sequoia-hope/bluebuzz/archive/nrf52840/ABANDONED.md

# Abandoned

The first bluebuzz board (nRF52840 module, 34 x 44 mm, 4 layers). Abandoned
2026-10-18 in favour of the RP2350A + RM2 board, which now lives at the top
of this project. Kept for reference only; its pipeline still runs from this
folder (`python3 build.py`), but nothing here is maintained.
