sequoia-hope/bluebuzz/design/gates/phase7/copper_b_cu.png

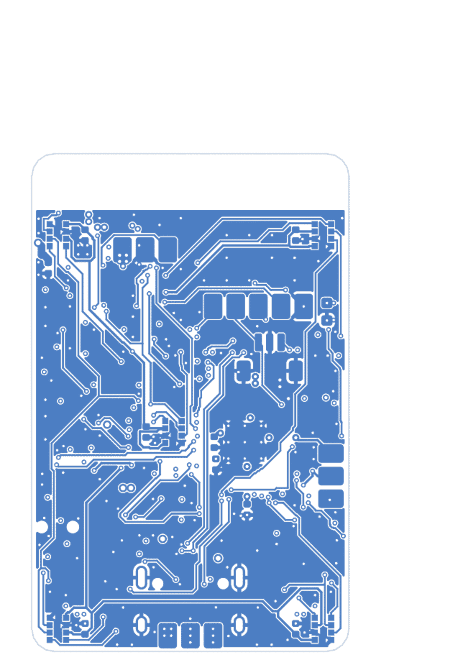
design/gates/phase7/copper_b_cu.png
