sequoia-hope/bluebuzz/design/gates/phase7/copper_f_cu.png

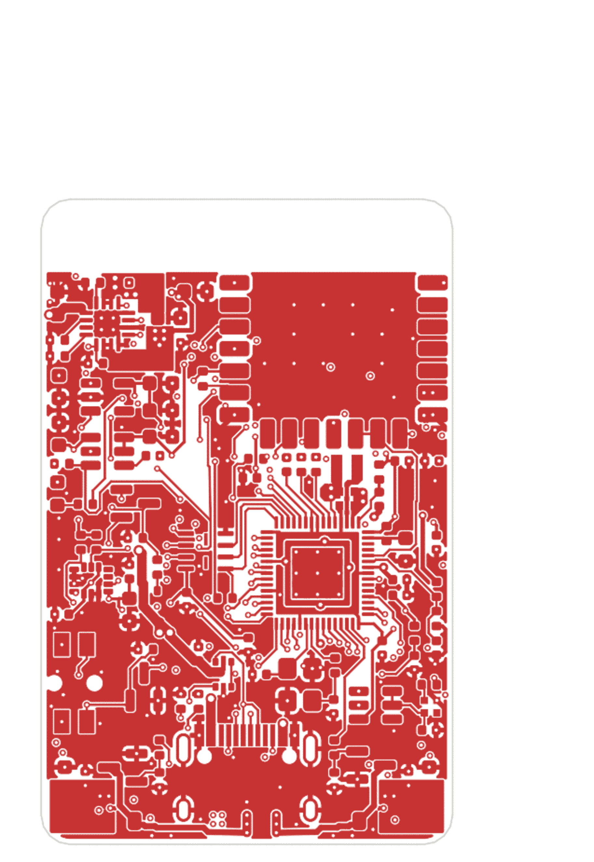
design/gates/phase7/copper_f_cu.png
