sequoia-hope/bluebuzz/design/gates/phase7/copper_in1_cu.png

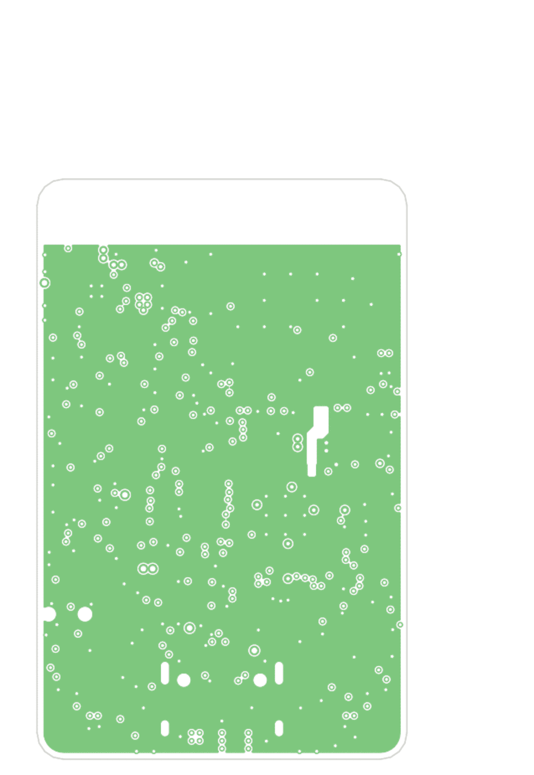
design/gates/phase7/copper_in1_cu.png
