sequoia-hope/bluebuzz/design/gates/phase7/copper_in2_cu.png

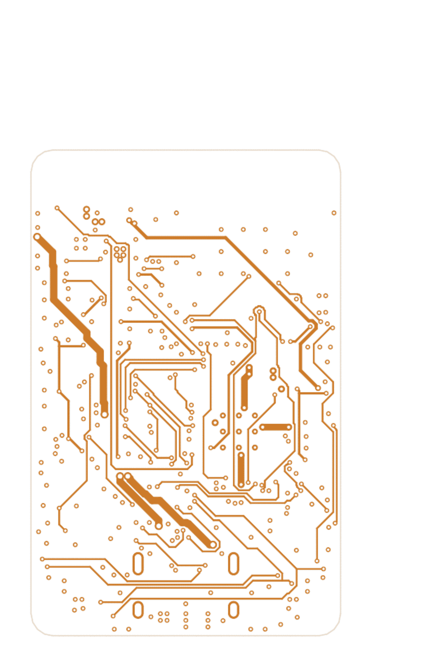
design/gates/phase7/copper_in2_cu.png
