sequoia-hope/bluebuzz/design/gates/phase7/copper_in3_cu.png

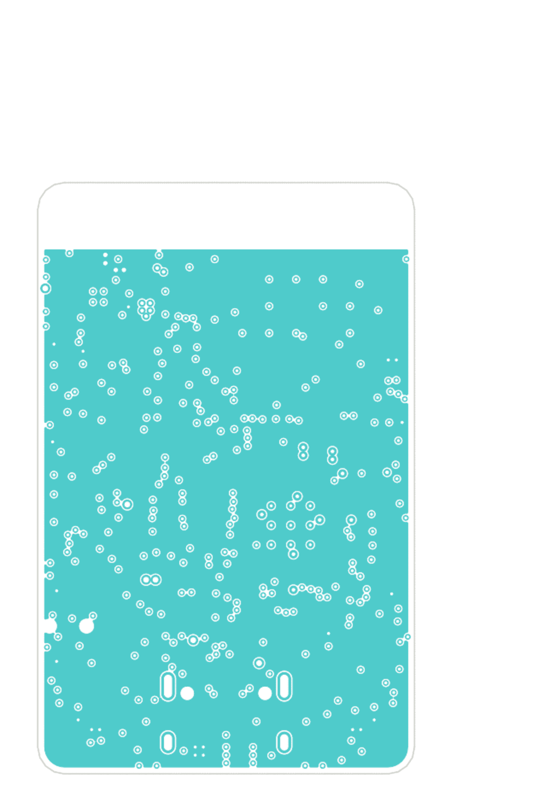
design/gates/phase7/copper_in3_cu.png
