sequoia-hope/bluebuzz/design/gates/phase7/copper_in4_cu.png

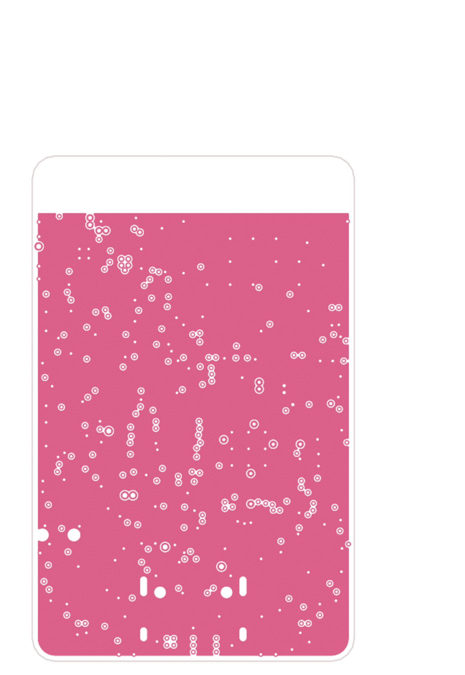
design/gates/phase7/copper_in4_cu.png
