sequoia-hope/bluebuzz/design/renders/sch-1.png

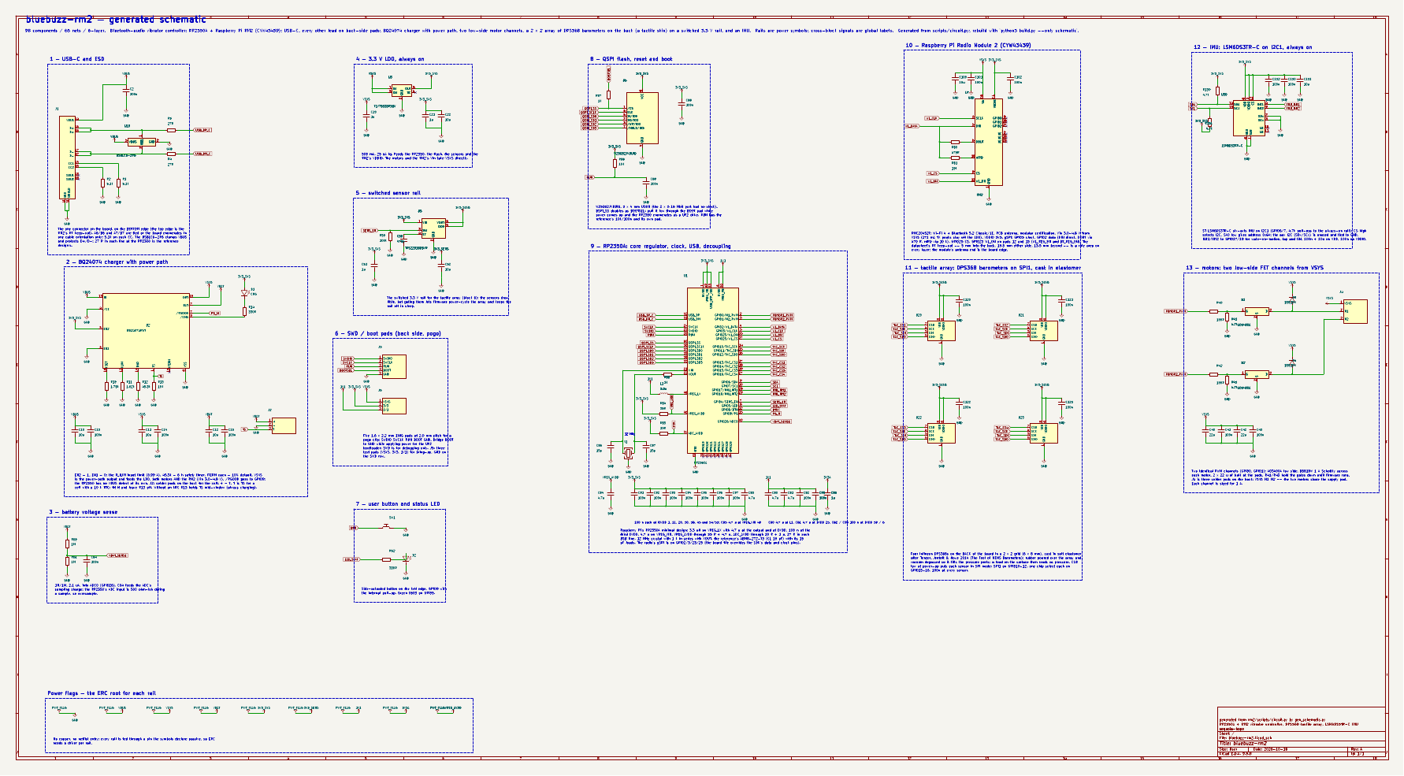
design/renders/sch-1.png
