sequoia-hope/bluebuzz/design/renders/sch-tile1.png

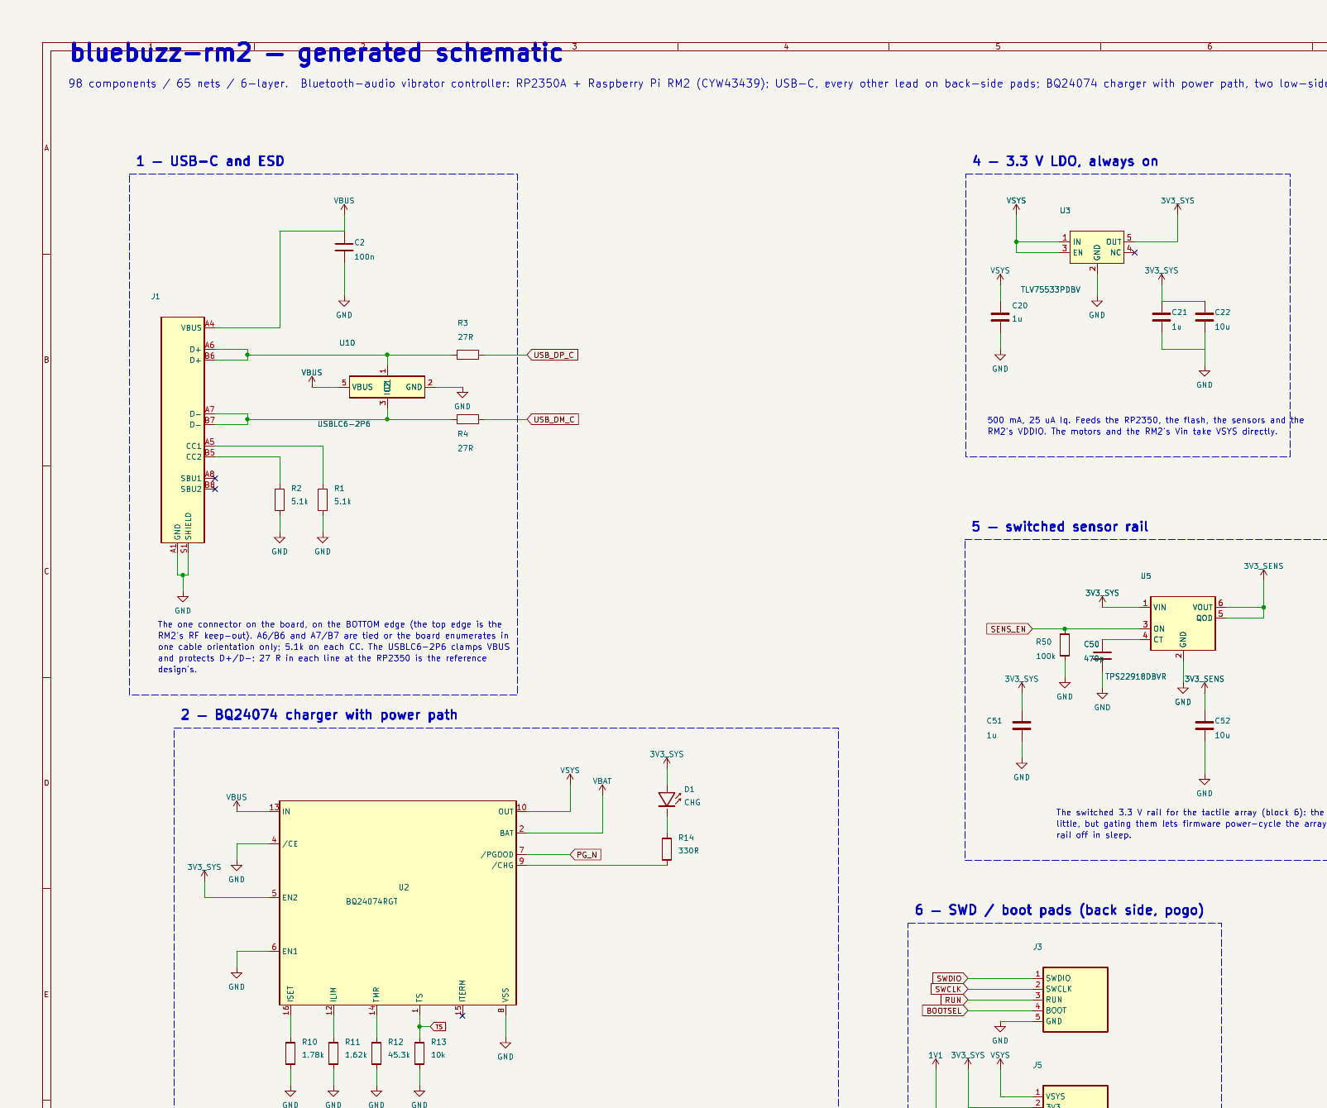
design/renders/sch-tile1.png
