sequoia-hope/bluebuzz/design/renders/sch-tile2.png

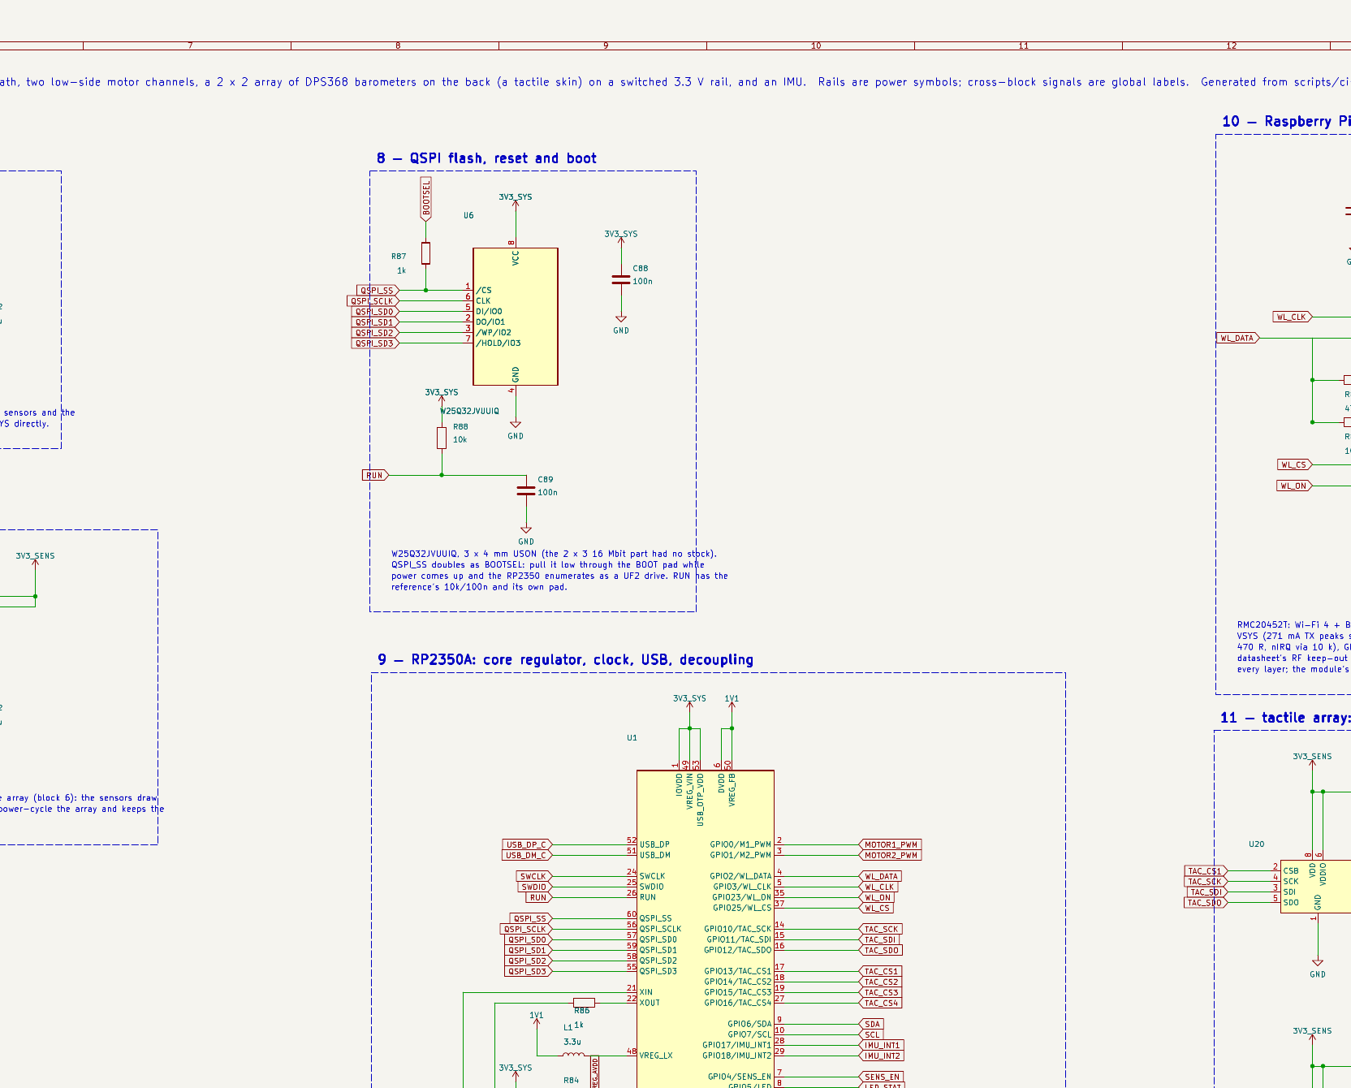
design/renders/sch-tile2.png
