sequoia-hope/bluebuzz/design/renders/sch-tile3.png

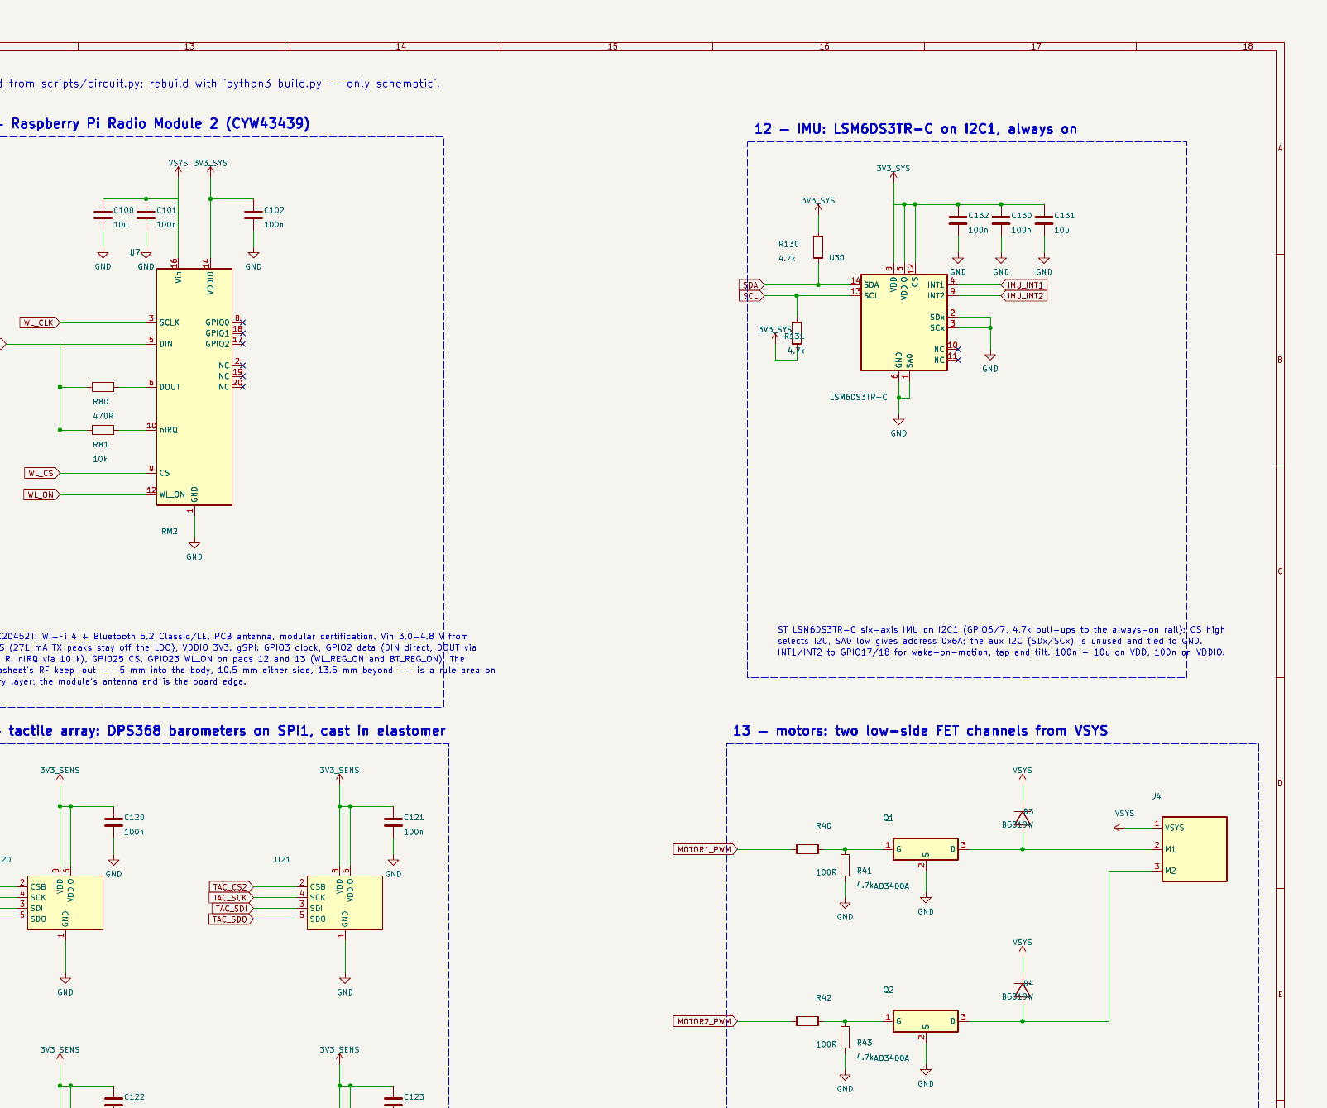
design/renders/sch-tile3.png
