sequoia-hope/bluebuzz/design/renders/sch-tile4.png

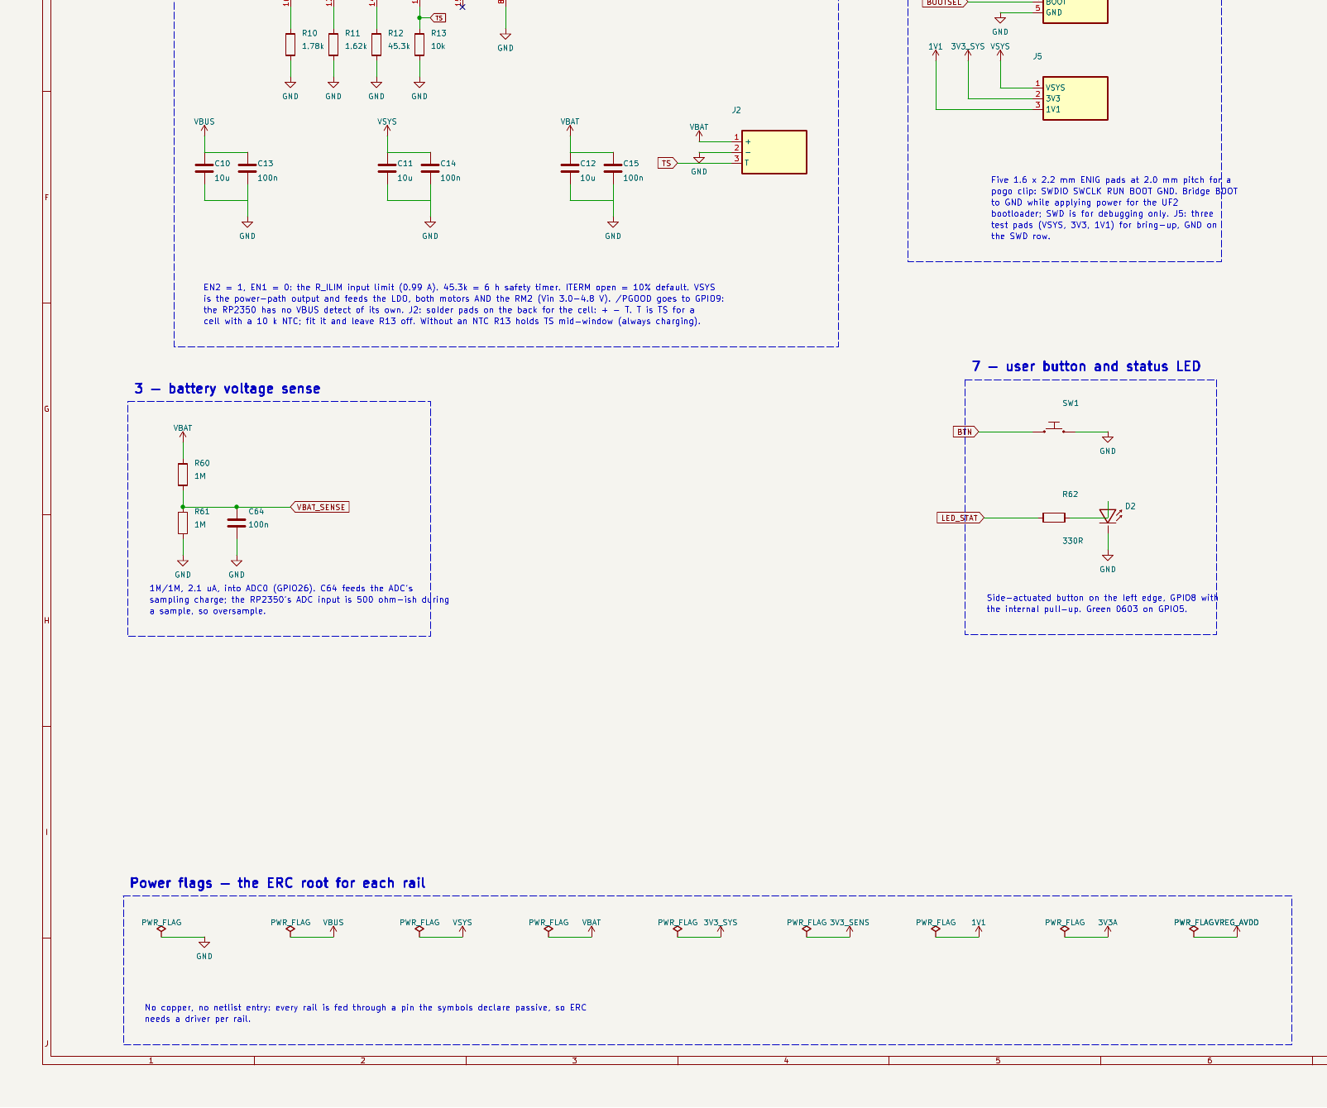
design/renders/sch-tile4.png
