sequoia-hope/bluebuzz/design/renders/sch-tile5.png

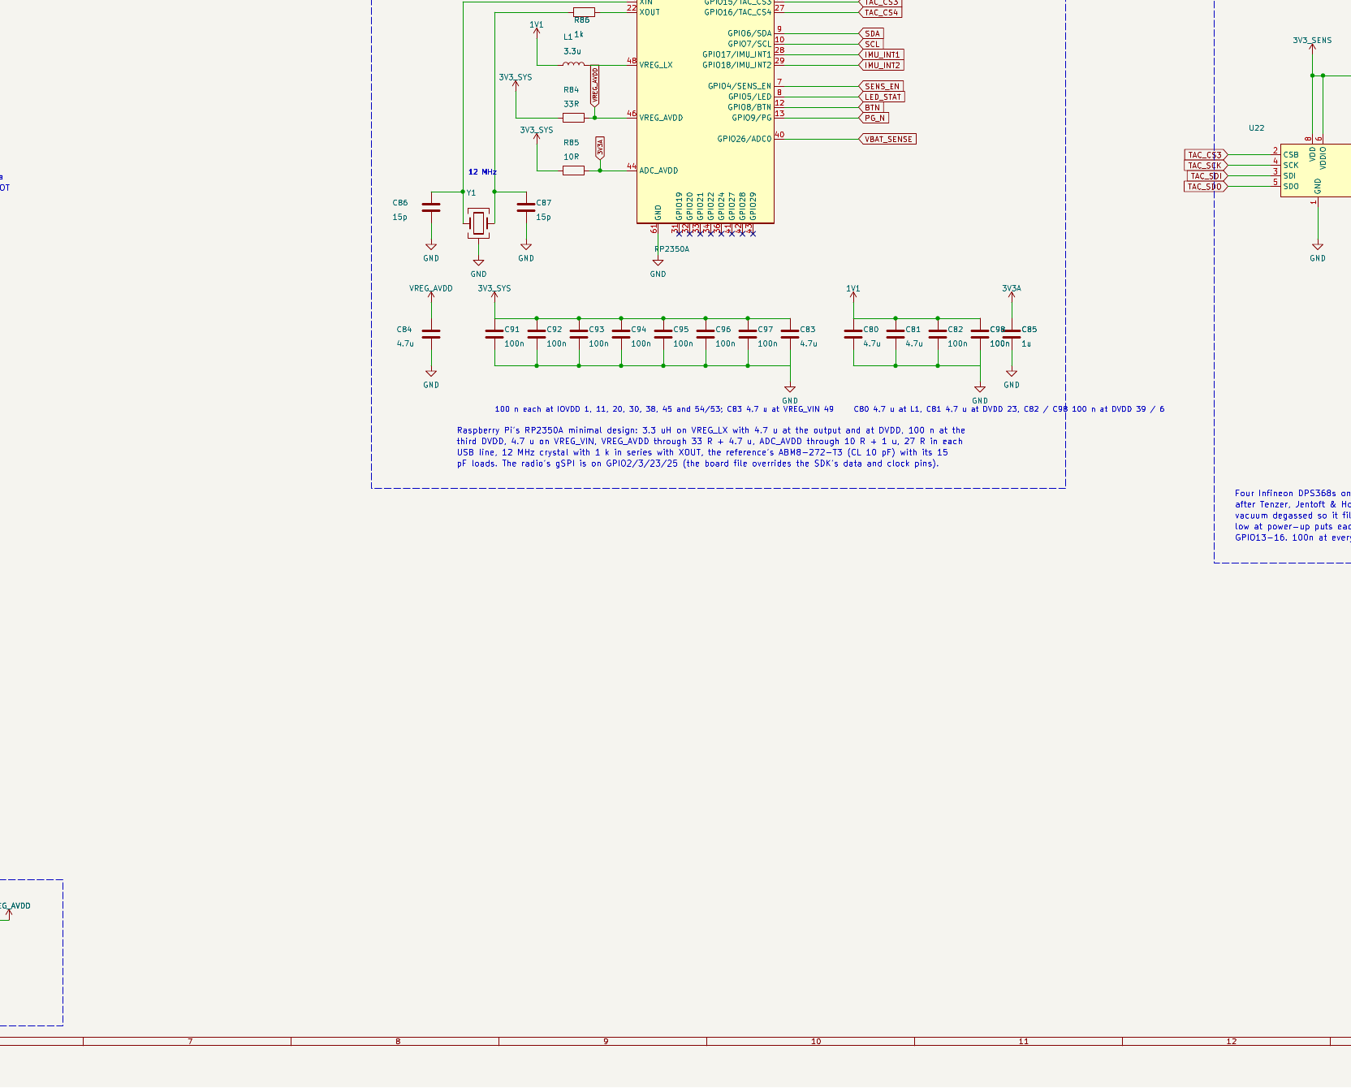
design/renders/sch-tile5.png
