sequoia-hope/bluebuzz/design/renders/sch-tile6.png

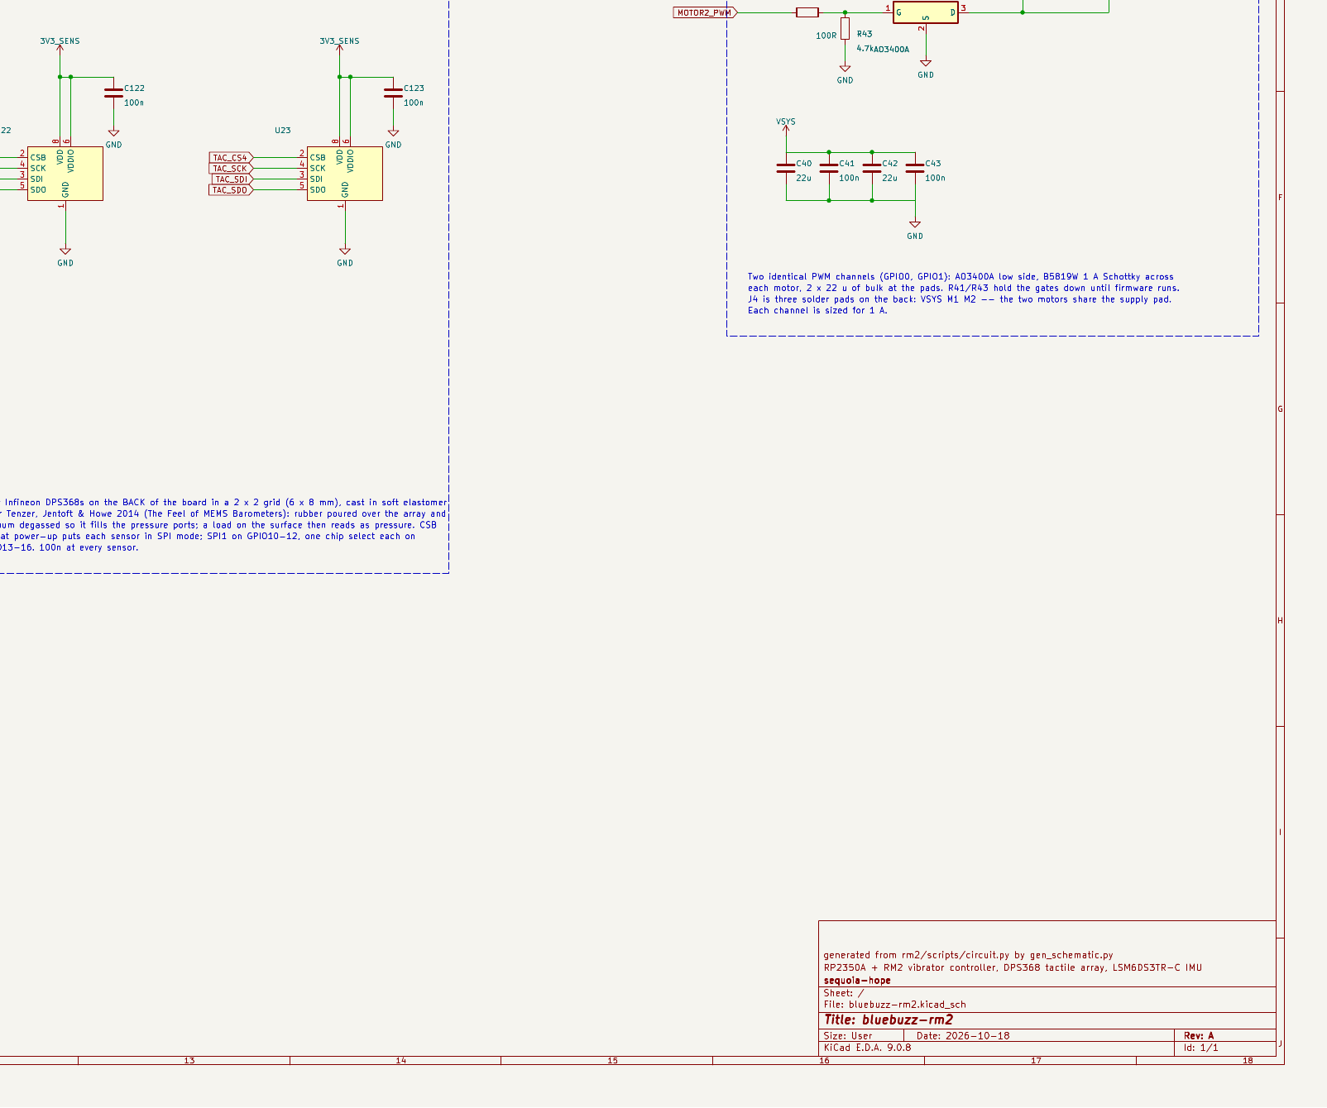
design/renders/sch-tile6.png
