sequoia-hope/bluebuzz/docs/components/img/ds-abm8-specs.png

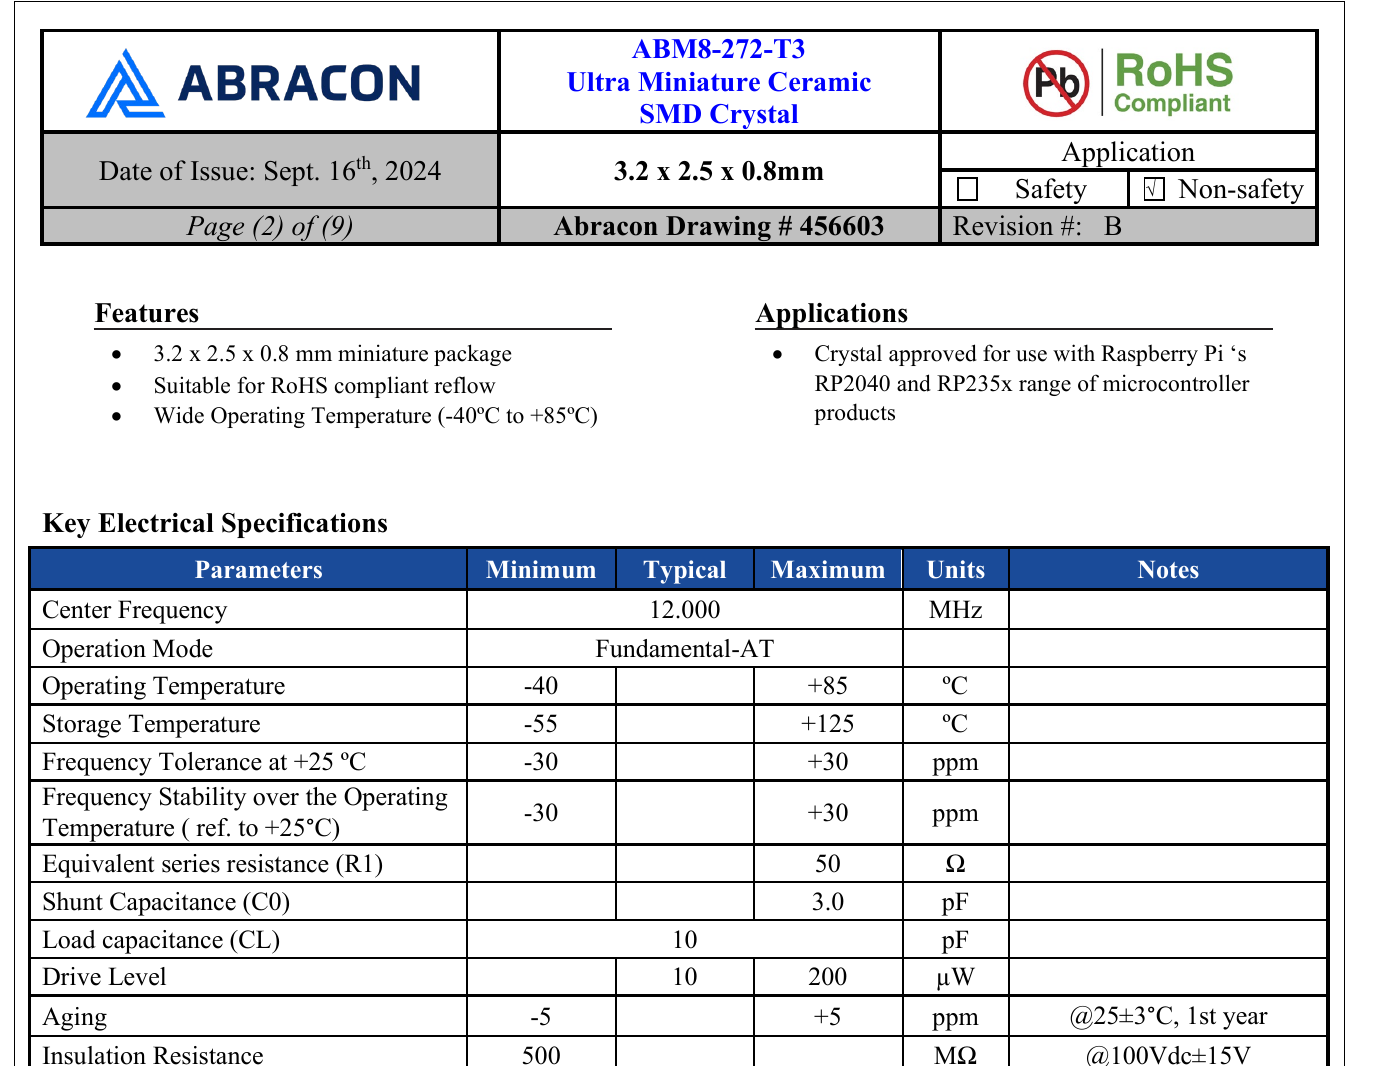
docs/components/img/ds-abm8-specs.png
