sequoia-hope/bluebuzz/docs/components/img/ds-bq-design.png

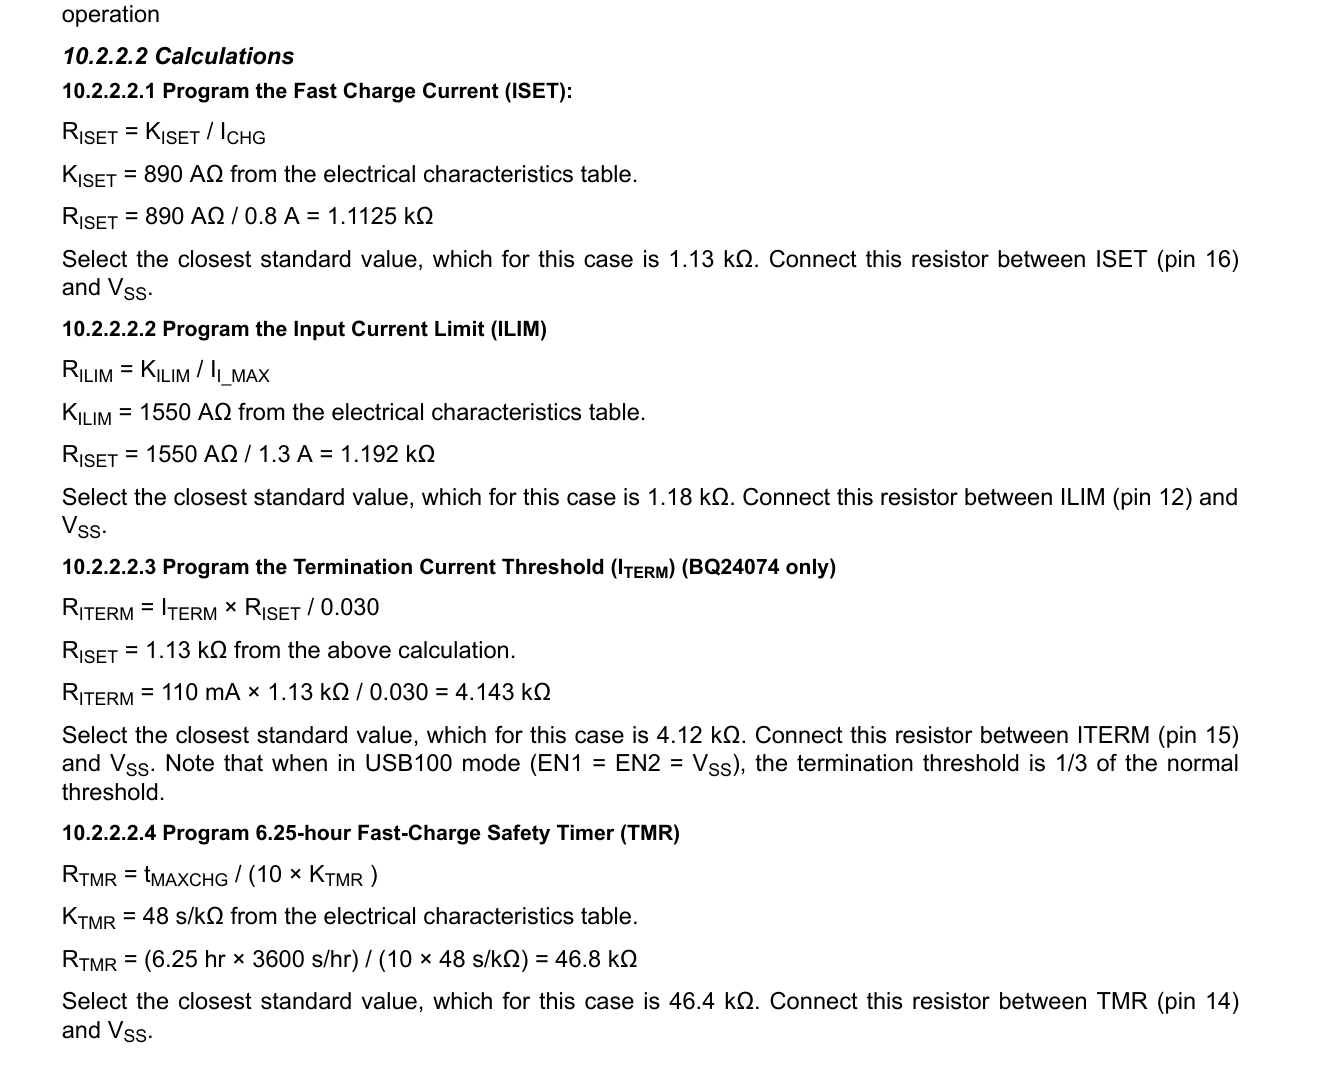
docs/components/img/ds-bq-design.png
