sequoia-hope/bluebuzz/out/layer_b.png

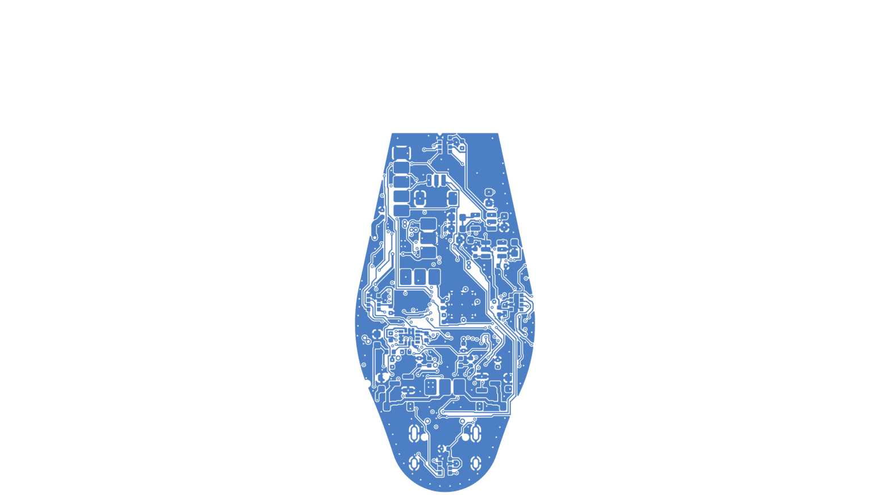
out/layer_b.png
