sequoia-hope/bluebuzz/out/layer_edge.png

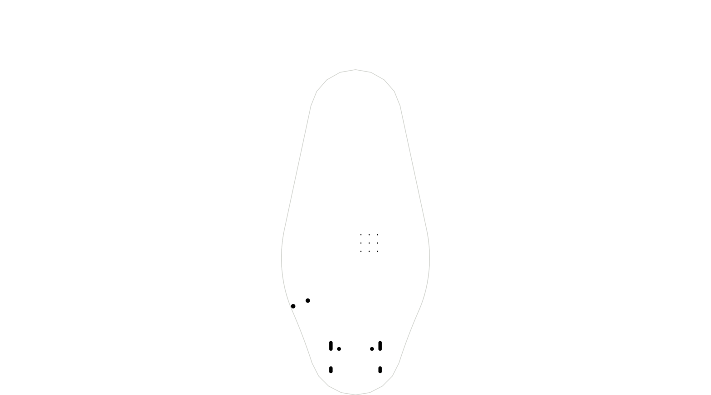
out/layer_edge.png
