sequoia-hope/bluebuzz/out/layout_layers.png

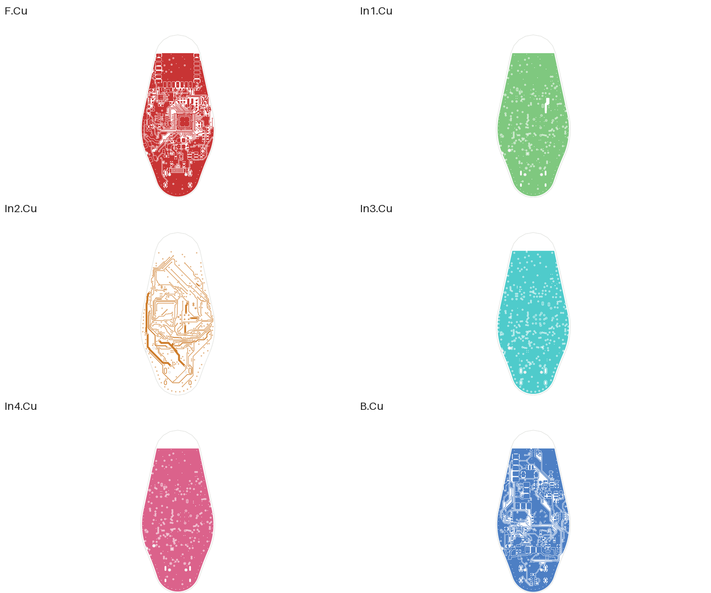
out/layout_layers.png
