sequoia-hope/bluebuzz/out/render_bottom.png

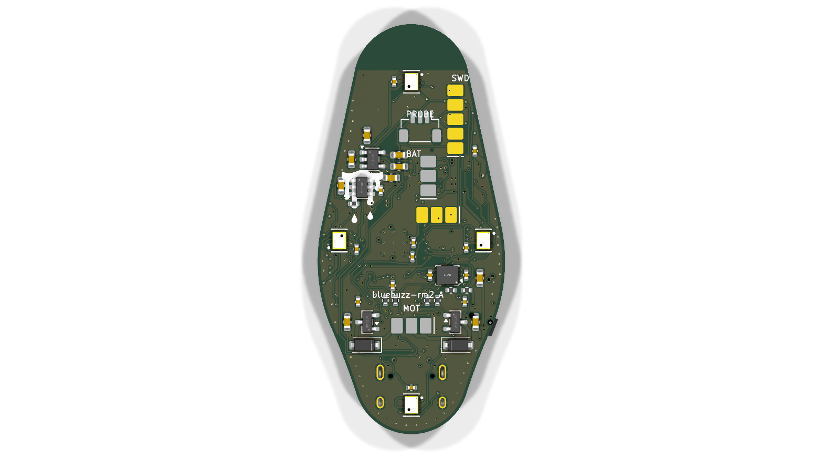
out/render_bottom.png
