sequoia-hope/bluebuzz/out/squish_outline_overlay.png

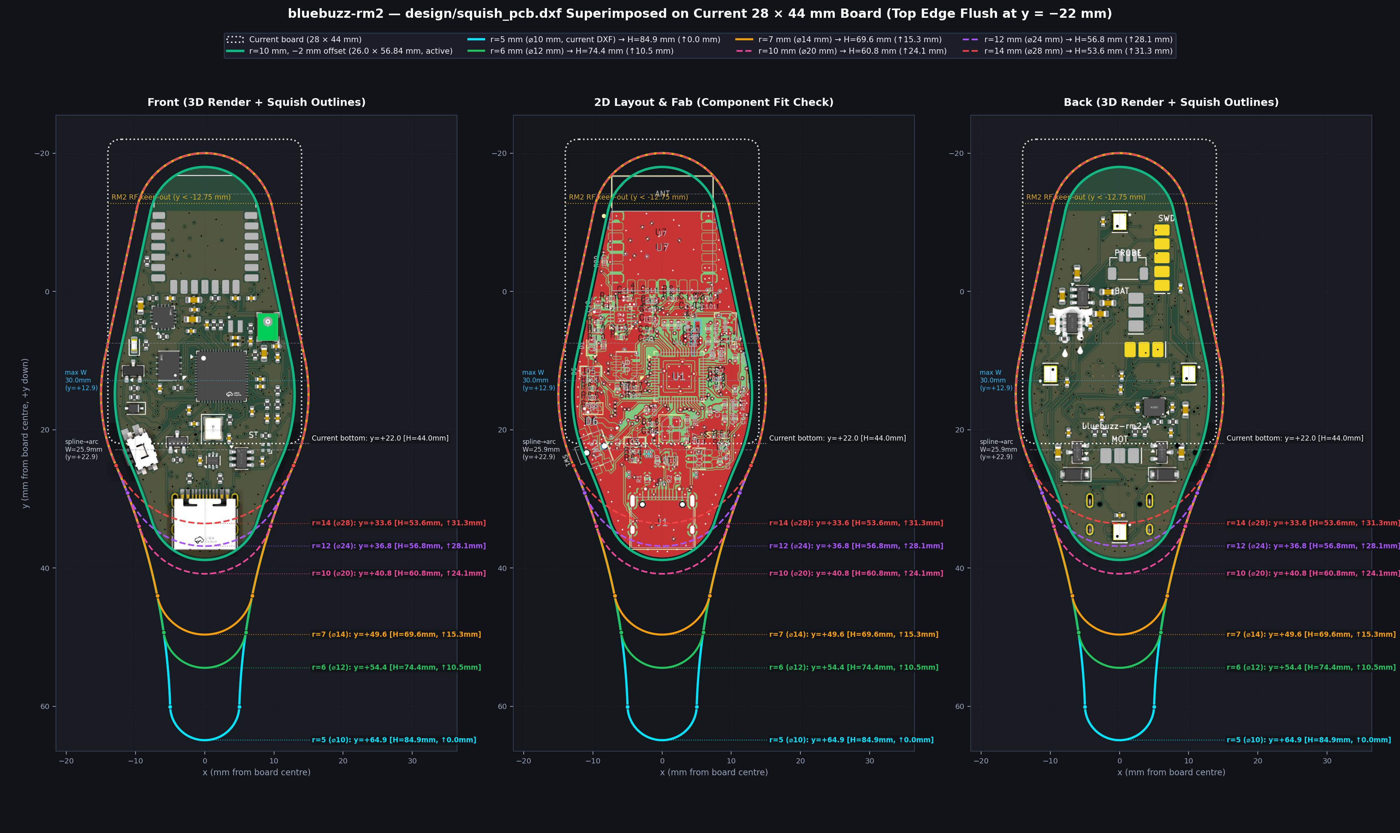
out/squish_outline_overlay.png
