sequoia-hope/bluebuzz/out/jlcpcb/bom.csv

Comment | Designator | Footprint | MPN | LCSC Part #
10u | C10,C100,C11,C12,C131,C22,C52 | C_0603_1608Metric | CL10A106KP8NNNC | C19702
100n | C101,C102,C120,C121,C122,C123,C13,C130,C132,C133,C14,C140,C15,C2,C41,C43,C64,C82,C88,C89,C91,C92,C93,C94,C95,C96,C97,C98 | C_0402_1005Metric | CL05B104KO5NNNC | C1525
22u | C40,C42 | C_0603_1608Metric | CL10A226MP8NUNE | C86295
470p | C50 | C_0402_1005Metric | 0402CG471J500NT | C75274
4.7u | C80,C83 | C_0402_1005Metric_small_pads | CL05A475MP5NRNC | C23733
4.7u | C81,C84 | C_0402_1005Metric | CL05A475MP5NRNC | C23733
1u | C20,C21,C51,C85 | C_0603_1608Metric | CL10A105KB8NNNC | C15849
15p | C86,C87 | C_0402_1005Metric | 0402CG150J500NT | C1548
CHG | D1 | LED_0603_1608Metric | 19-217/GHC-YR1S2/6T | C2986059
XL-1010RGBC | D2 | LED_1010_WS2812 | XL-1010RGBC-2812B-S | C51900942
B5819W | D3,D4 | D_SOD-123 | B5819W | C8598
BAT54C | D5 | SOT-23 | BAT54C,215 | C37704
1N4148WS | D6 | D_SOD-323 | 1N4148WS | C2128
USB-C | J1 | USB_C_Receptacle_HRO_TYPE-C-31-M-12 | TYPE-C-31-M-12 | C165948
3.3u | L1 | L_pol_2016 | AOTA-B201610S3R3-101-T | C42411119
AO3400A | Q1,Q2 | SOT-23 | AO3400A | C20917
2N7002 | Q3 | SOT-23 | 2N7002 | C8545
1.78k | R10 | R_0402_1005Metric | 0402WGF1781TCE | C113478
1.62k | R11 | R_0402_1005Metric | 0402WGF1621TCE | C61897
45.3k | R12 | R_0402_1005Metric | 0402WGF4532TCE | C26980
10k | R13,R81,R88 | R_0402_1005Metric | 0402WGF1002TCE | C25744
330R | R14,R62 | R_0402_1005Metric | 0402WGF3300TCE | C25104
5.1k | R1,R2 | R_0402_1005Metric | 0402WGF5101TCE | C25905
27R | R3,R4 | R_0402_1005Metric | 0402WGF270JTCE | C25100
100R | R40,R42 | R_0402_1005Metric | 0402WGF1000TCE | C25076
4.7k | R130,R131,R41,R43 | R_0402_1005Metric | 0402WGF4701TCE | C25900
1M | R60,R61 | R_0402_1005Metric | 0402WGF1004TCE | C26083
100k | R50,R63,R64,R66 | R_0402_1005Metric | 0402WGF1003TCE | C25741
470R | R80 | R_0402_1005Metric | 0402WGF4700TCE | C25117
33R | R84 | R_0402_1005Metric | 0402WGF330JTCE | C25105
10R | R85 | R_0402_1005Metric | 0402WGF100JTCE | C25077
1k | R86,R87 | R_0402_1005Metric | 0402WGF1001TCE | C11702
PWR | SW1 | Panasonic_EVQPUL_EVQPUC | EVQPUC02K | C79174
RP2350A | U1 | QFN-60-1EP_7x7mm_P0.4mm_EP3.4x3.4mm_ThermalVias | RP2350A | C42411118
USBLC6-2P6 | U10 | SOT-666 | USBLC6-2P6 | C15999
TPS22918DBVR | U11,U5 | SOT-23-6 | TPS22918DBVR | C131941
BQ24074RGT | U2 | VQFN-16-1EP_3x3mm_P0.5mm_EP1.6x1.6mm | BQ24074RGTR | C54313
DPS368 | U20,U21,U22,U23 | DPS368_LGA-8 | DPS368XTSA1 | C3232508
TLV75533PDBV | U3 | SOT-23-5 | TLV75533PDBVR | C404027
LSM6DS3TR-C | U30 | LGA-14_3x2.5mm_P0.5mm_LayoutBorder3x4y | LSM6DS3TR-C | C967633
MP34DT05-A | U40 | MP34DT05_HCLGA-4 | MP34DT05TR-A | C2688664
W25Q32JVUUIQ | U6 | Winbond_USON-8-2EP_3x4mm_P0.8mm_EP0.2x0.8mm | W25Q32JVUUIQ | C2999380
12MHz | Y1 | Crystal_SMD_3225-4Pin_3.2x2.5mm | ABM8-272-T3 | C20625731
