sequoia-hope/bluebuzz/docs/components/img/ds-ao-front.png

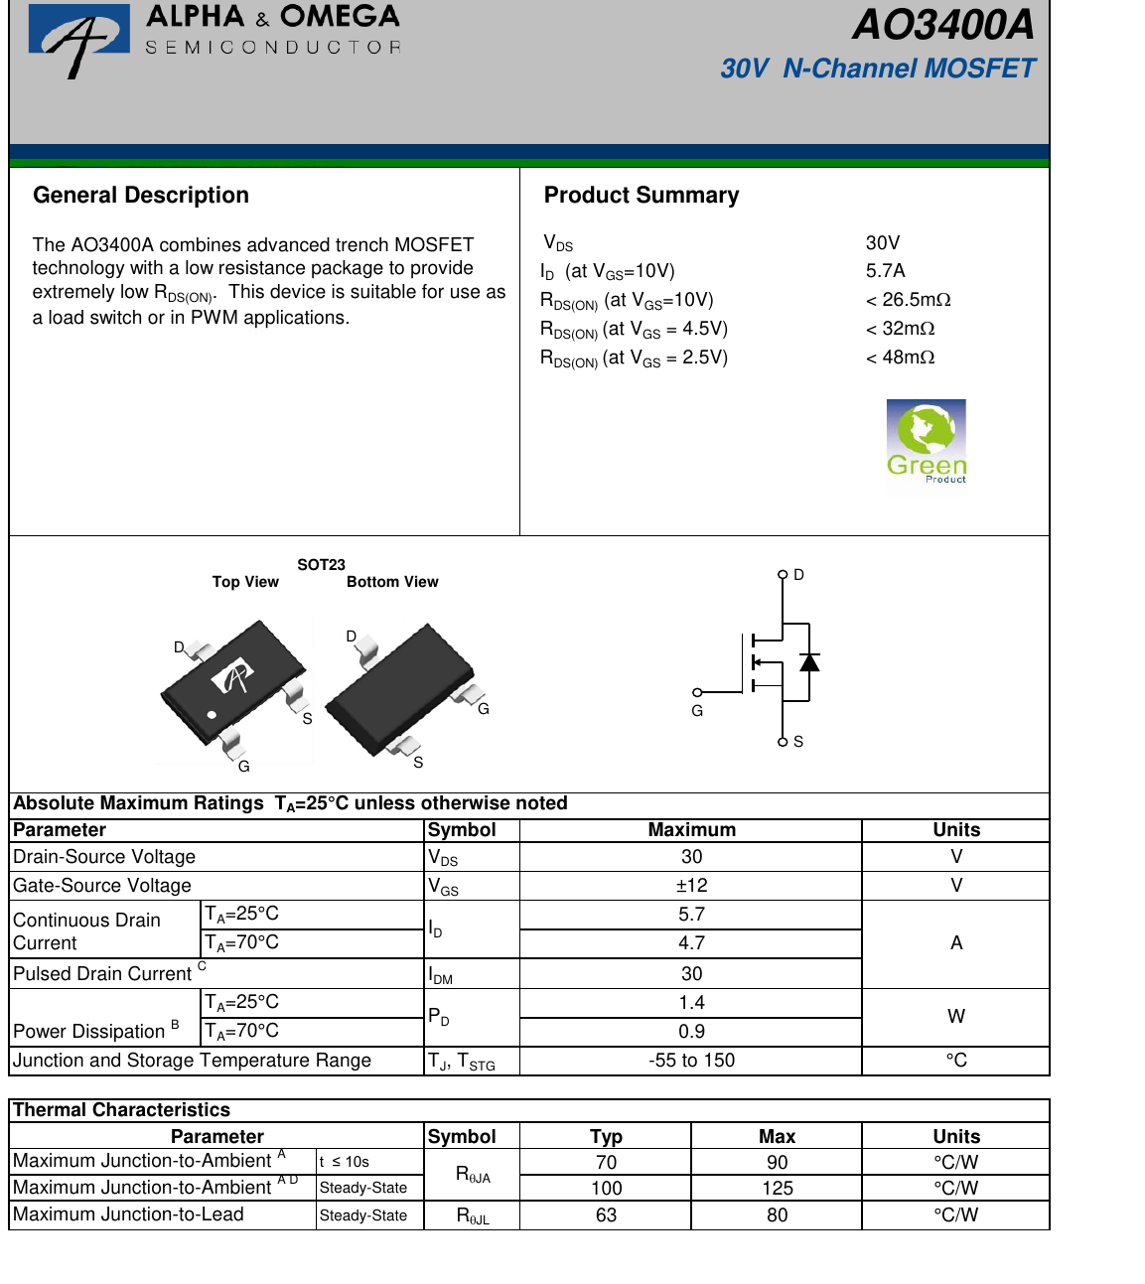
docs/components/img/ds-ao-front.png
