sequoia-hope/bluebuzz/docs/components/img/ds-ao-rds.png

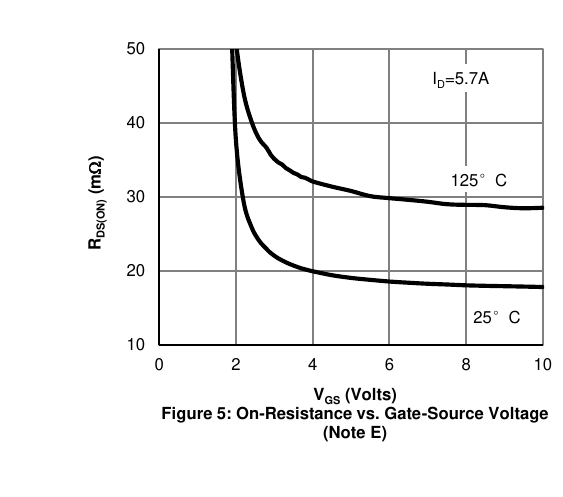
docs/components/img/ds-ao-rds.png
