sequoia-hope/bluebuzz/docs/components/img/ds-b5819w.png

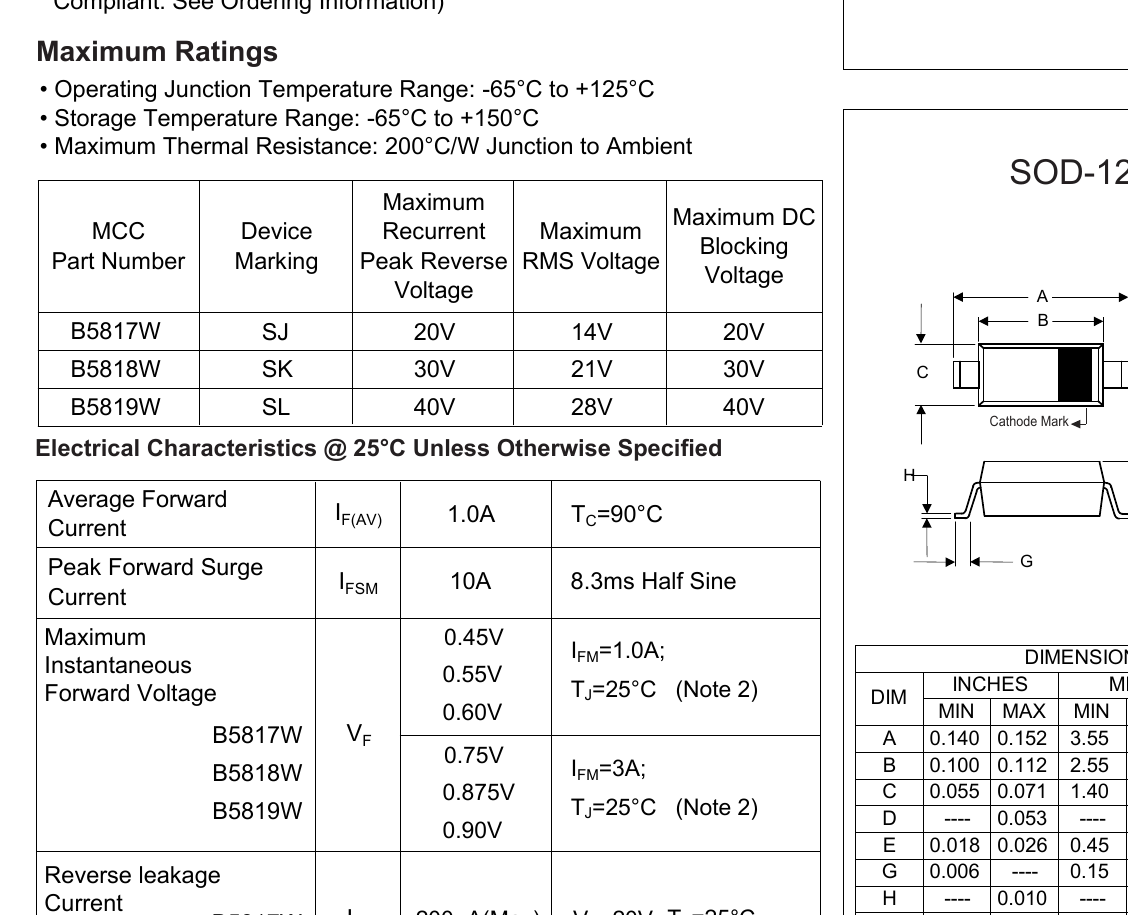
docs/components/img/ds-b5819w.png
