sequoia-hope/bluebuzz/docs/components/img/ds-bat54.png

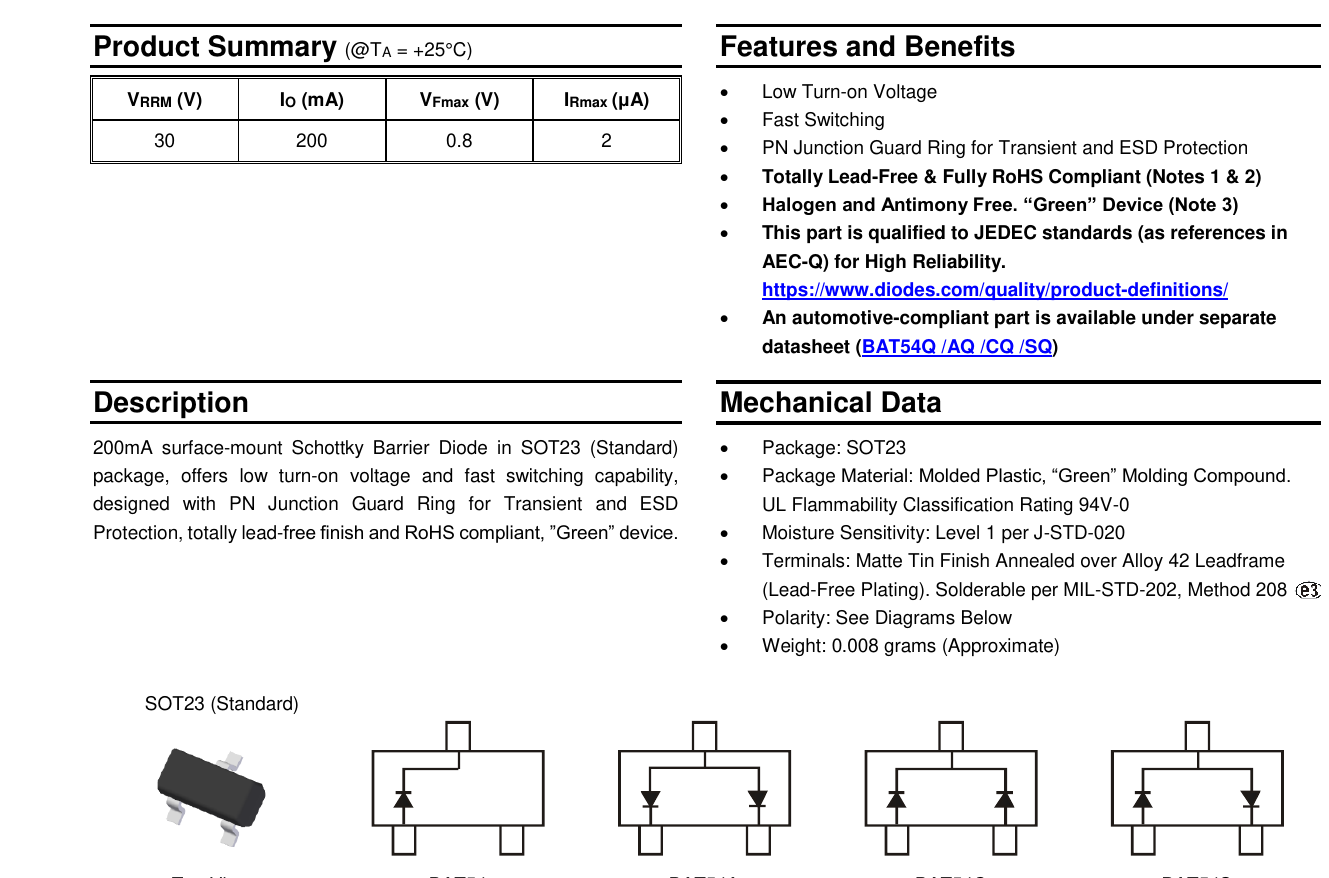
docs/components/img/ds-bat54.png
