sequoia-hope/bluebuzz/docs/components/img/ds-bq-front.png

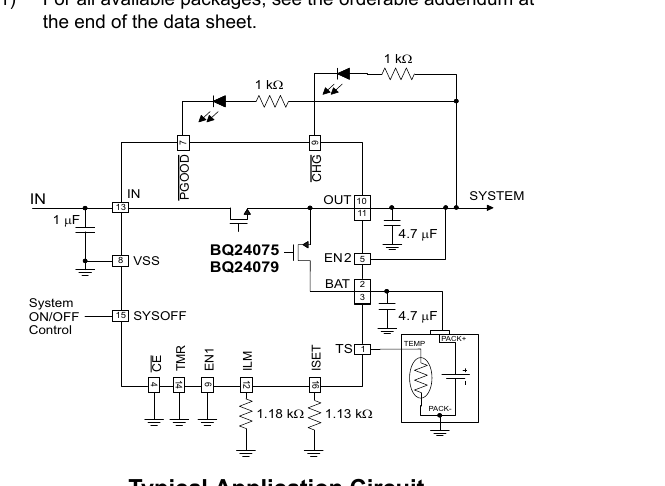
docs/components/img/ds-bq-front.png
