sequoia-hope/bluebuzz/docs/components/img/ds-dps-caps.png

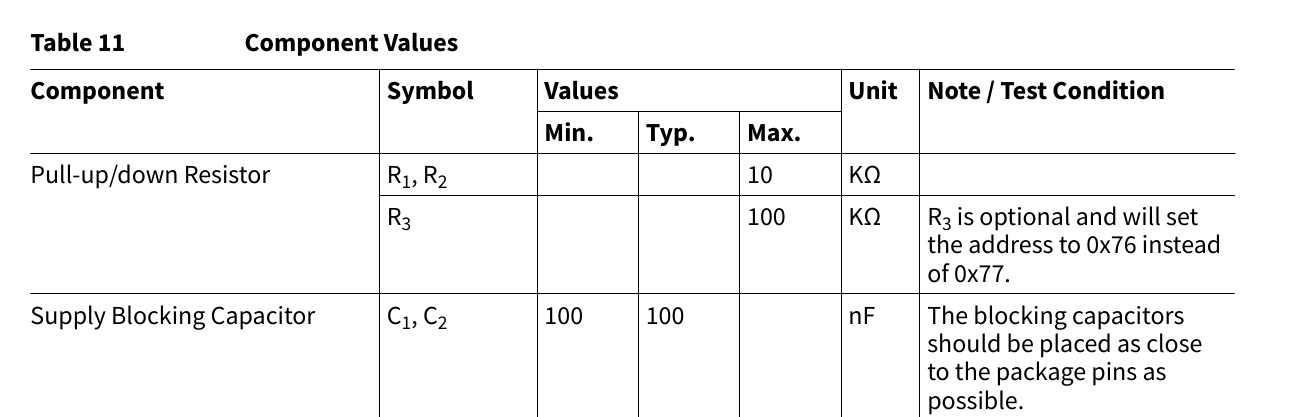
docs/components/img/ds-dps-caps.png
