sequoia-hope/bluebuzz/docs/components/img/ds-dps-handling.png

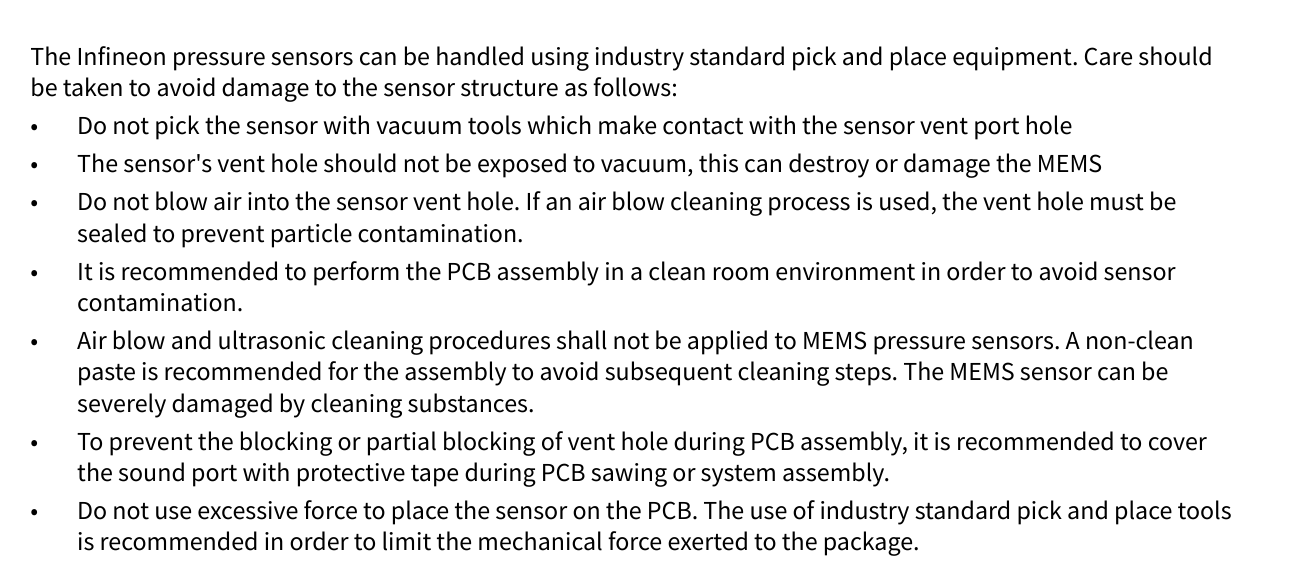
docs/components/img/ds-dps-handling.png
