sequoia-hope/bluebuzz/docs/components/img/ds-dps-land.png

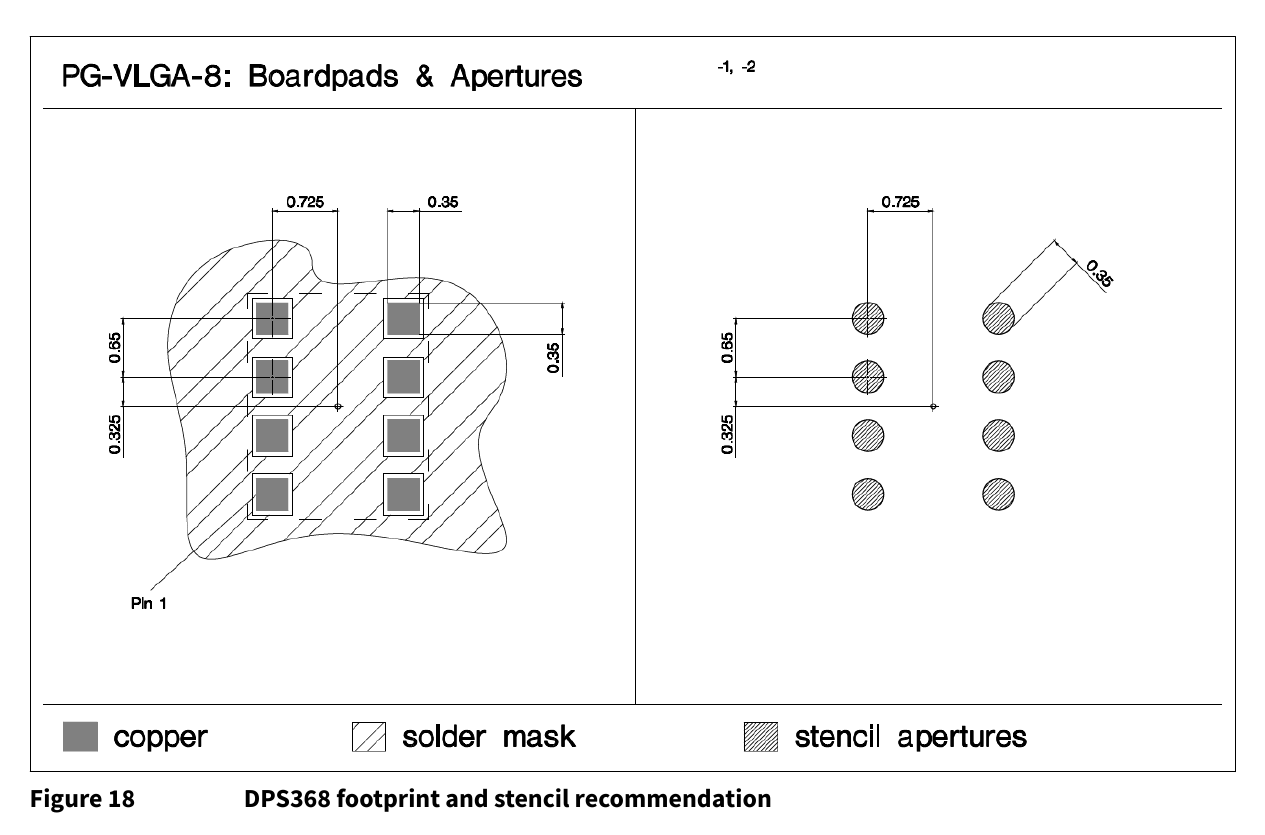
docs/components/img/ds-dps-land.png
