sequoia-hope/bluebuzz/docs/components/img/ds-dps-pins.png

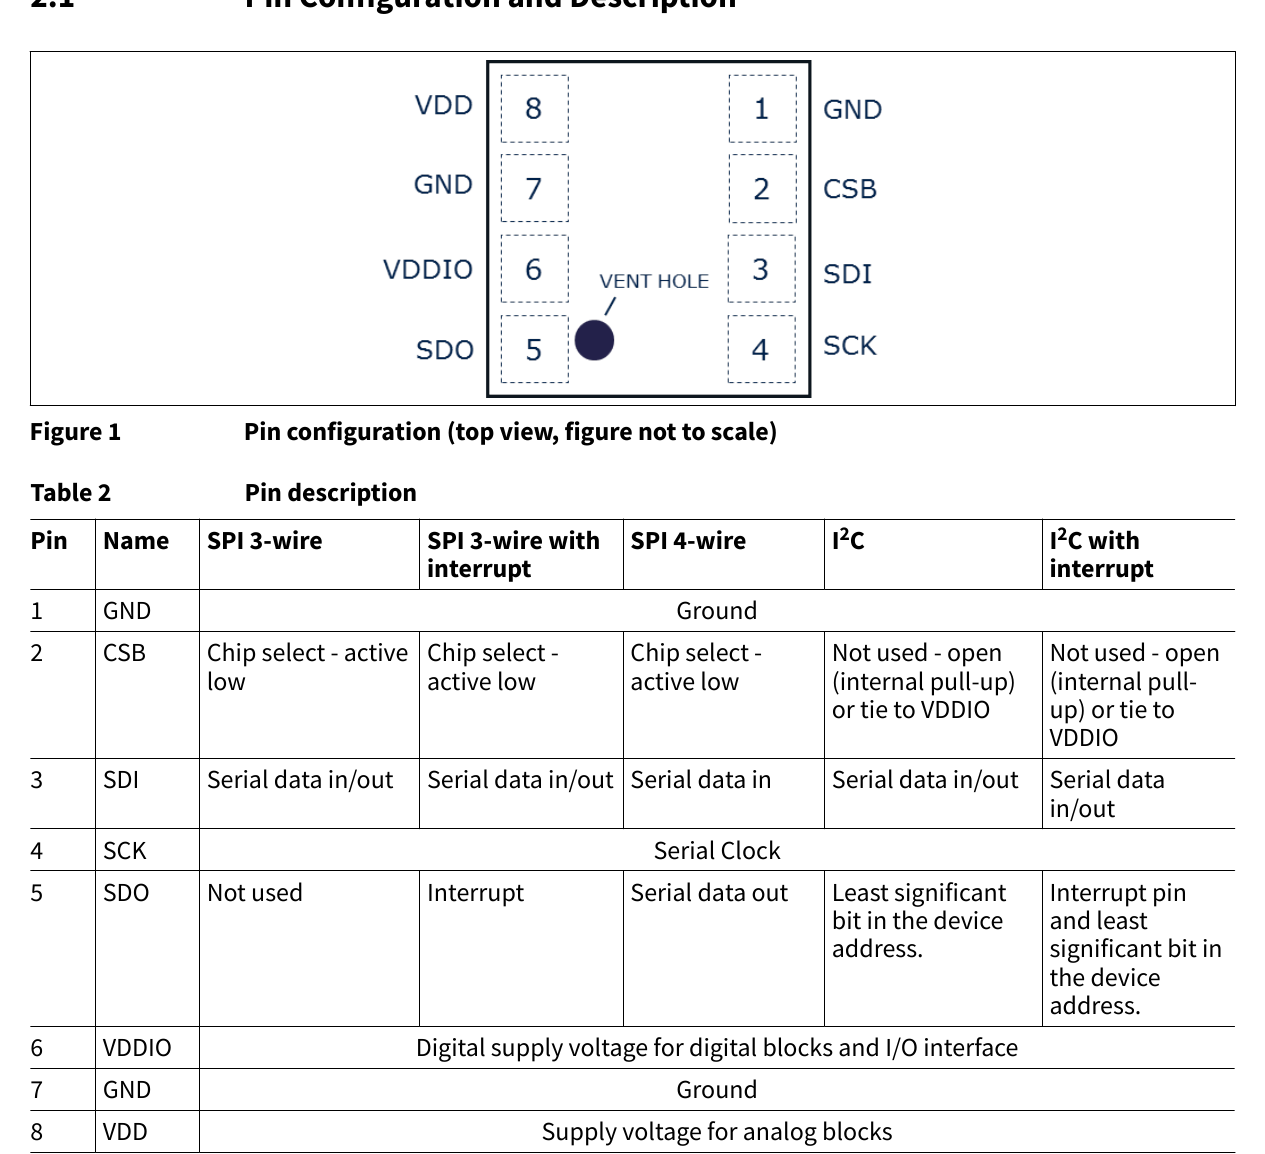
docs/components/img/ds-dps-pins.png
