sequoia-hope/bluebuzz/docs/components/img/ds-dps-spi.png

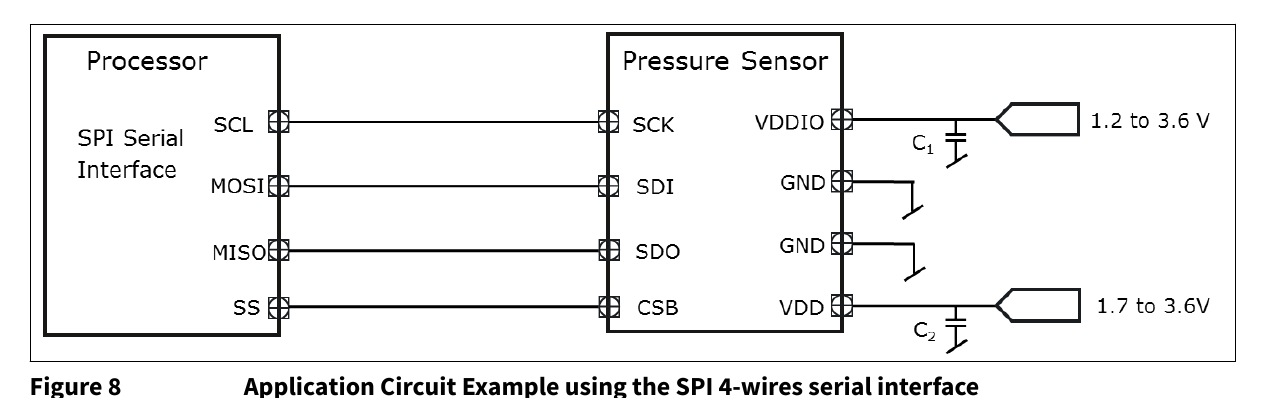
docs/components/img/ds-dps-spi.png
