sequoia-hope/bluebuzz/docs/components/img/ds-hdg-crystal-rec.png

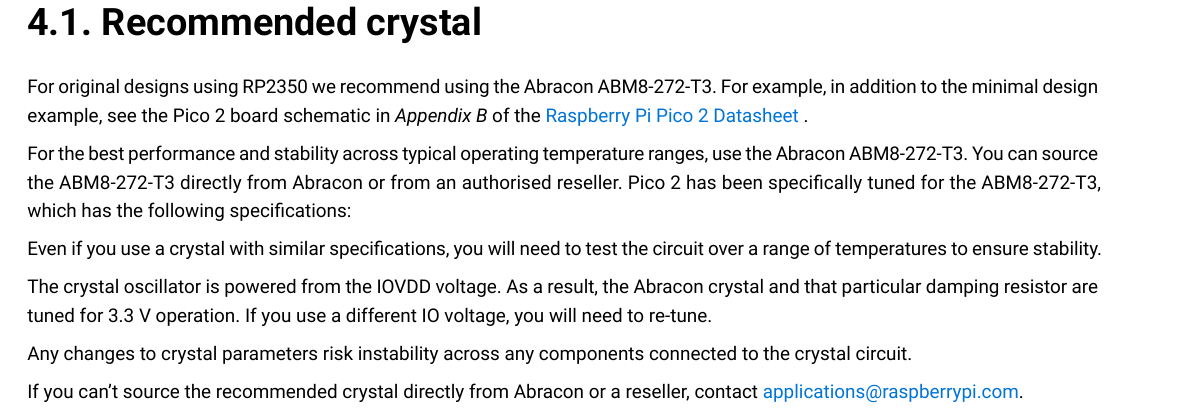
docs/components/img/ds-hdg-crystal-rec.png
