sequoia-hope/bluebuzz/docs/components/img/ds-hdg-crystal.png

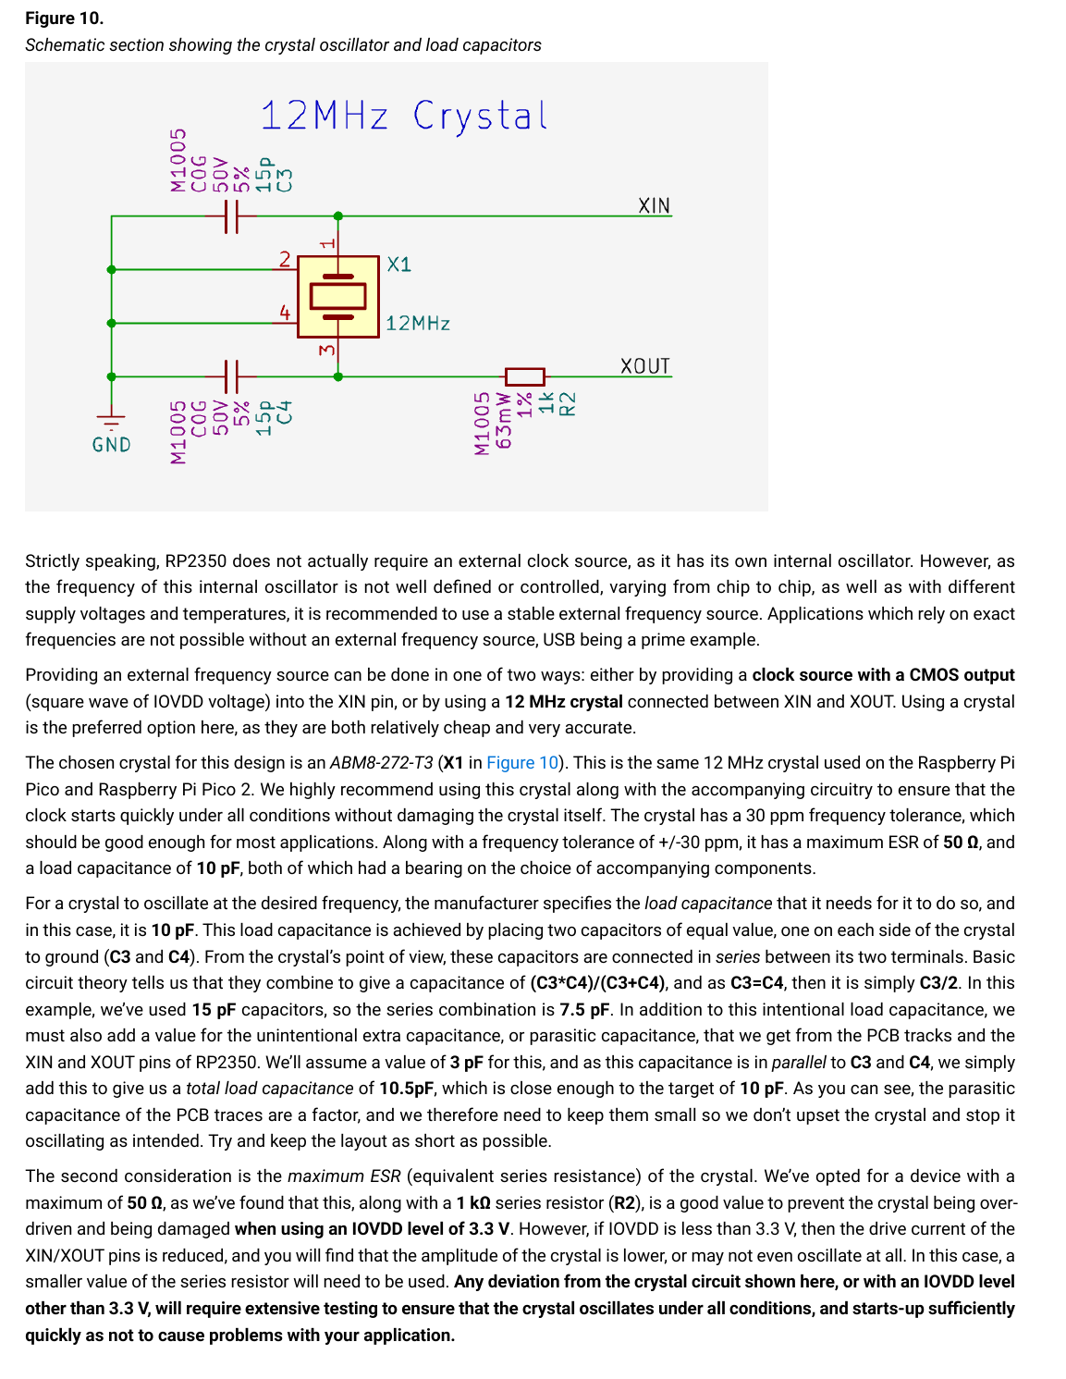
docs/components/img/ds-hdg-crystal.png
