sequoia-hope/bluebuzz/docs/components/img/ds-hdg-decoupling.png

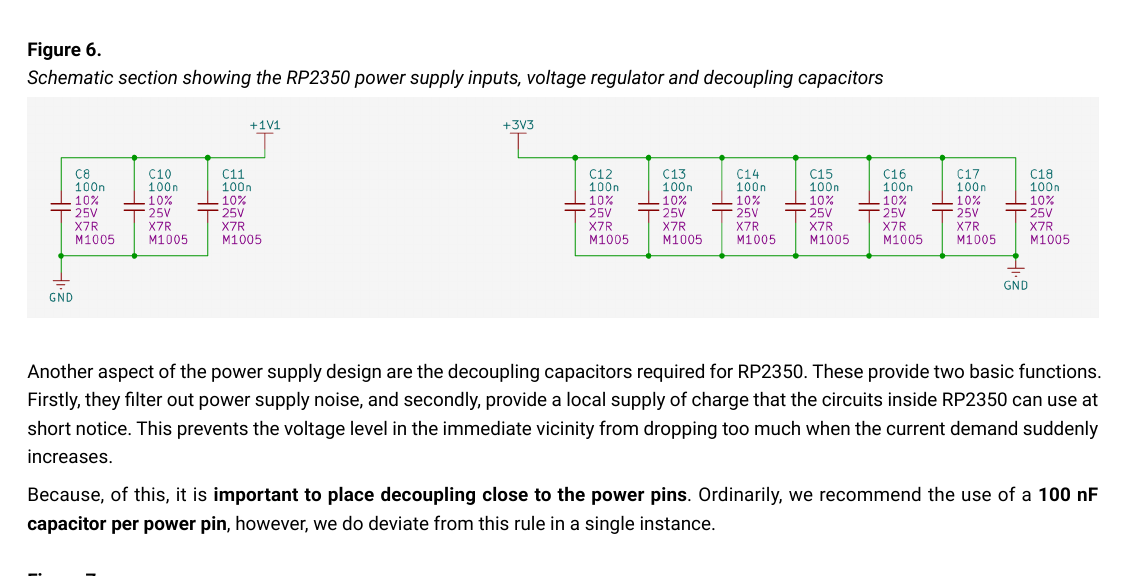
docs/components/img/ds-hdg-decoupling.png
