sequoia-hope/bluebuzz/docs/components/img/ds-hdg-flash.png

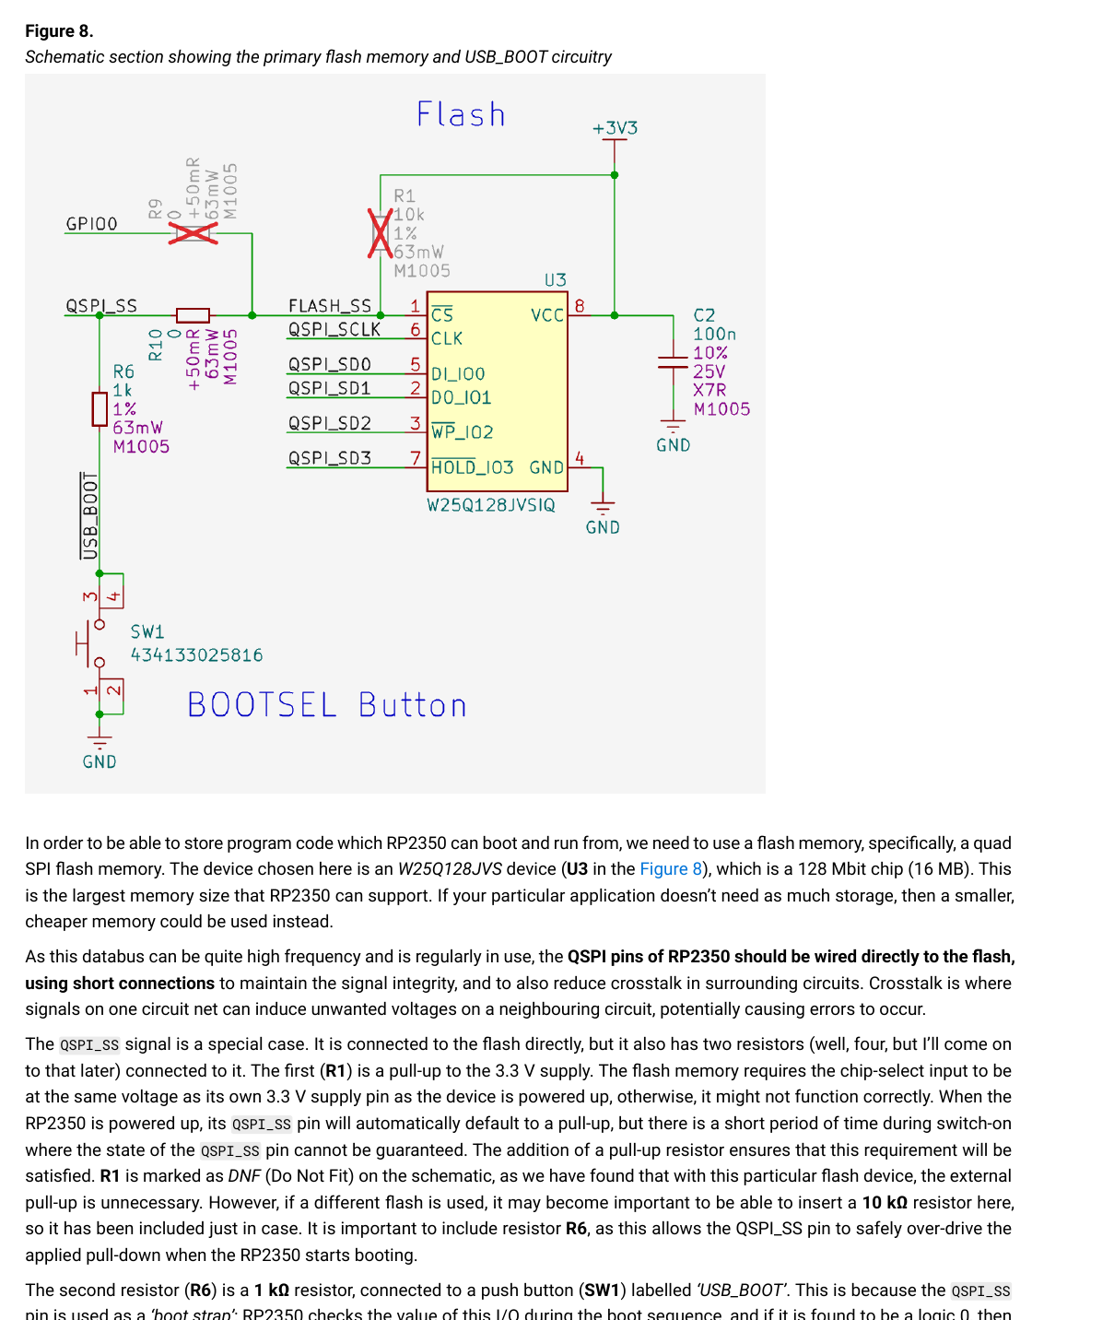
docs/components/img/ds-hdg-flash.png
