sequoia-hope/bluebuzz/docs/components/img/ds-hdg-inductor.png

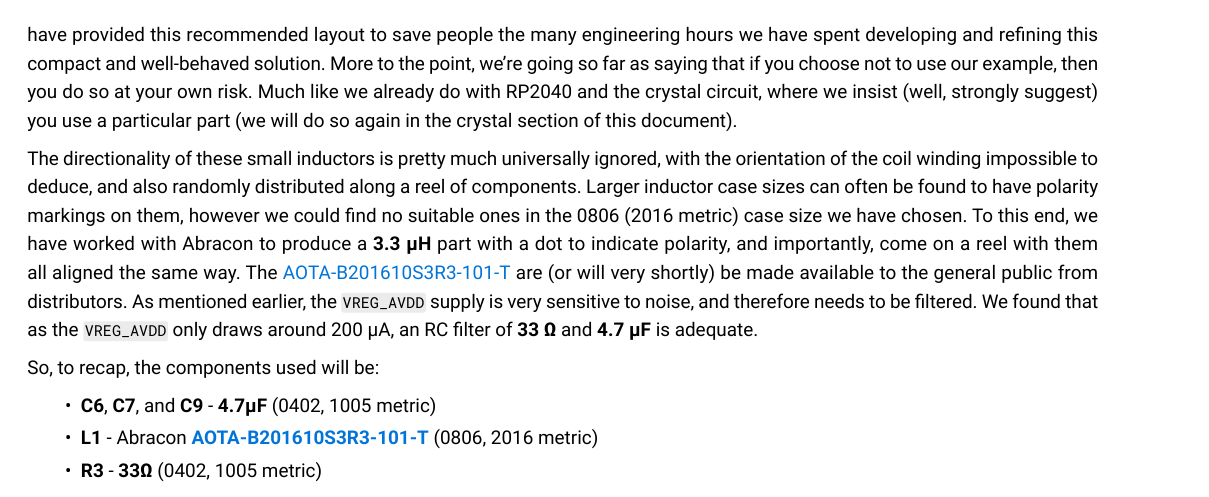
docs/components/img/ds-hdg-inductor.png
