sequoia-hope/bluebuzz/docs/components/img/ds-hdg-regulator-layout.png

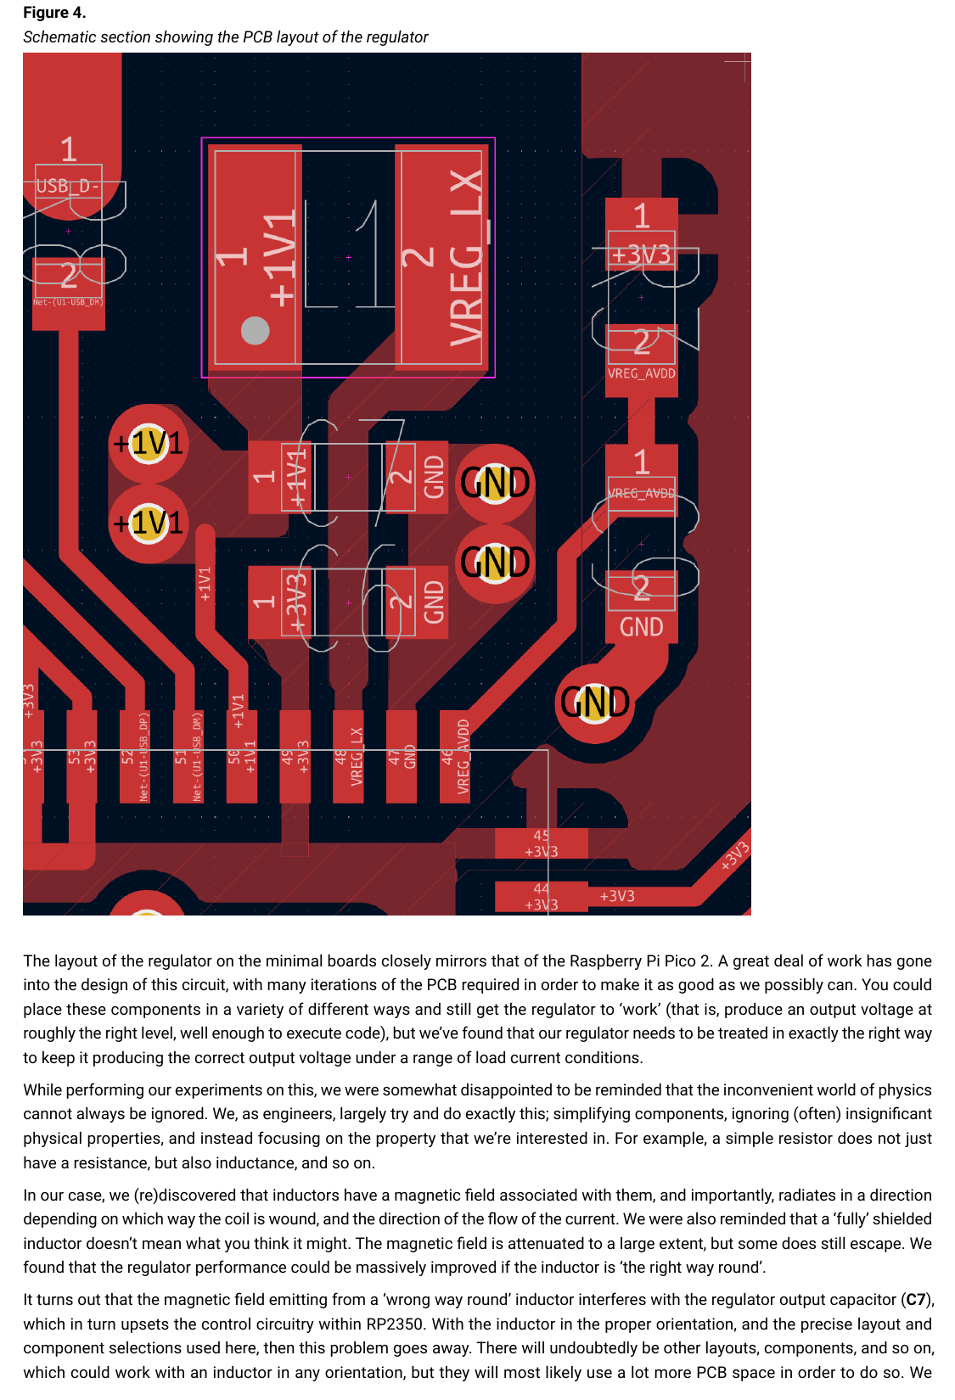
docs/components/img/ds-hdg-regulator-layout.png
