sequoia-hope/bluebuzz/docs/components/img/ds-hdg-usb.png

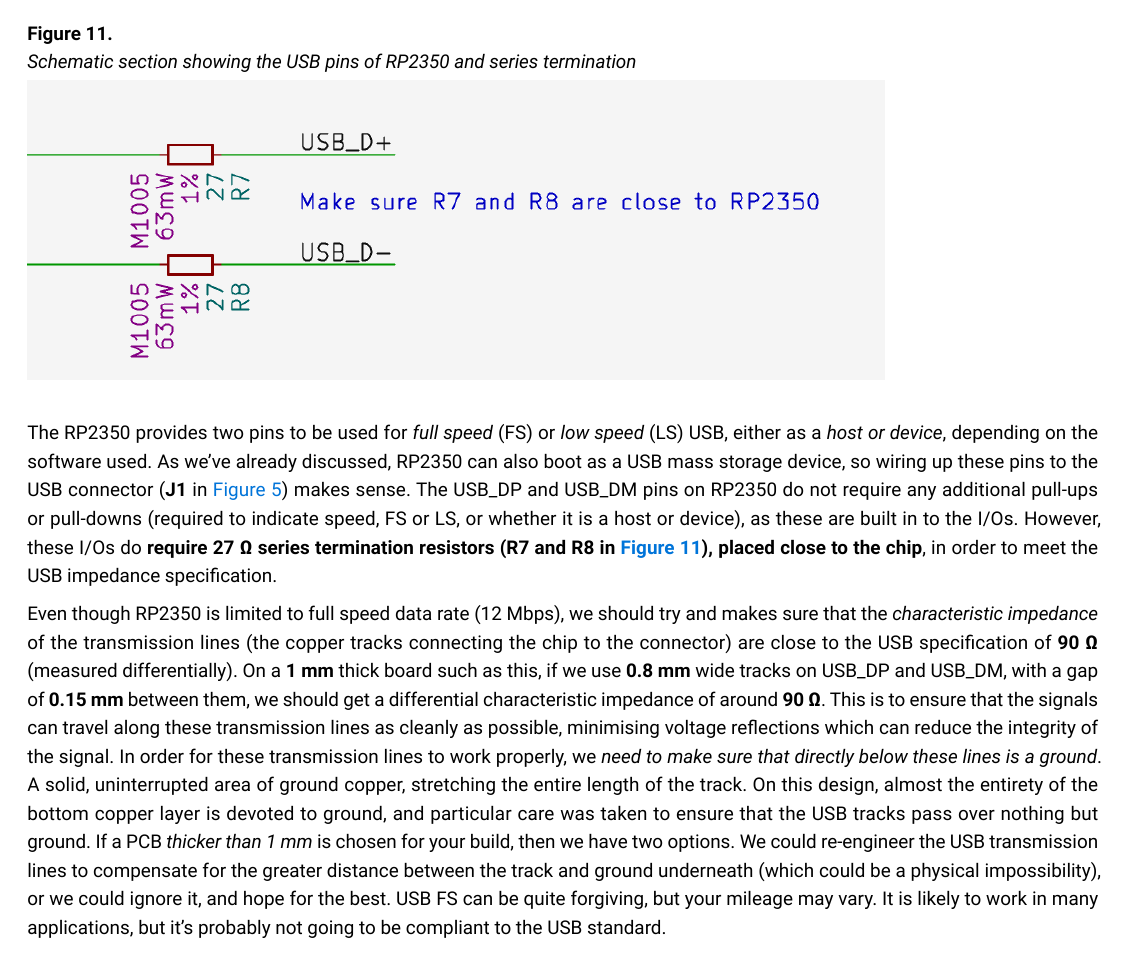
docs/components/img/ds-hdg-usb.png
