sequoia-hope/bluebuzz/docs/components/img/ds-jst-sh.png

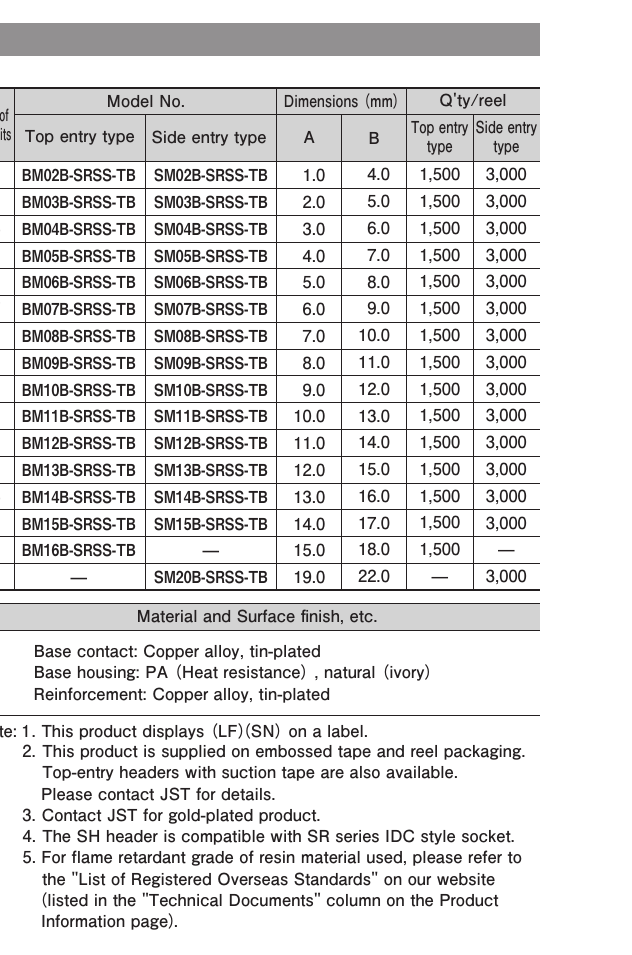
docs/components/img/ds-jst-sh.png
