sequoia-hope/bluebuzz/docs/components/img/ds-lsm-app.png

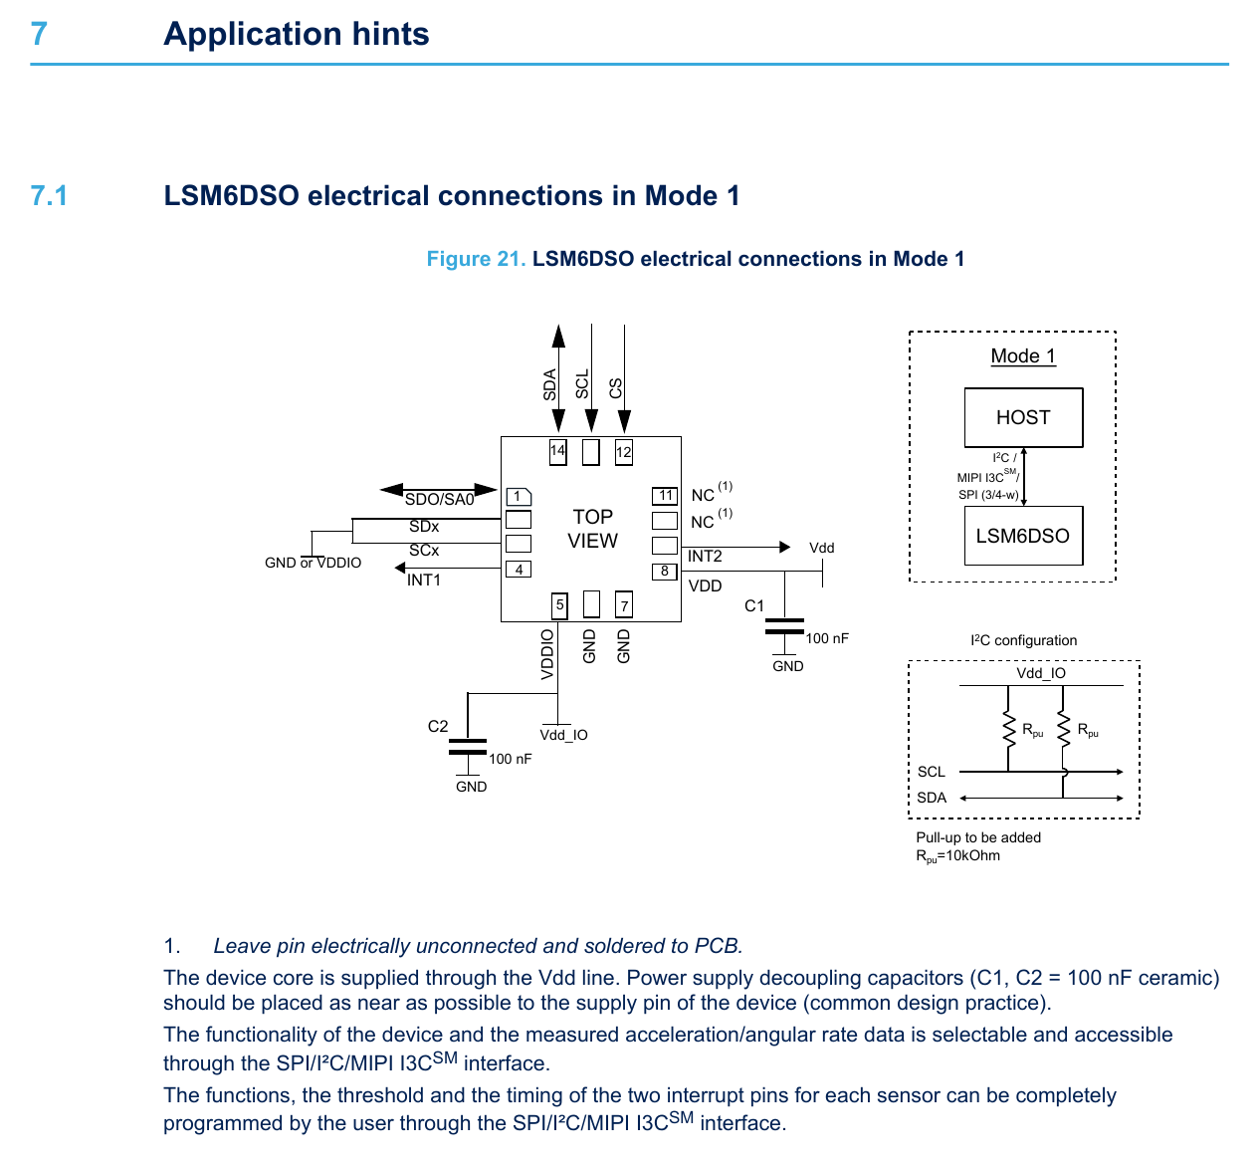
docs/components/img/ds-lsm-app.png
