sequoia-hope/bluebuzz/docs/components/img/ds-rm2-footprint.png

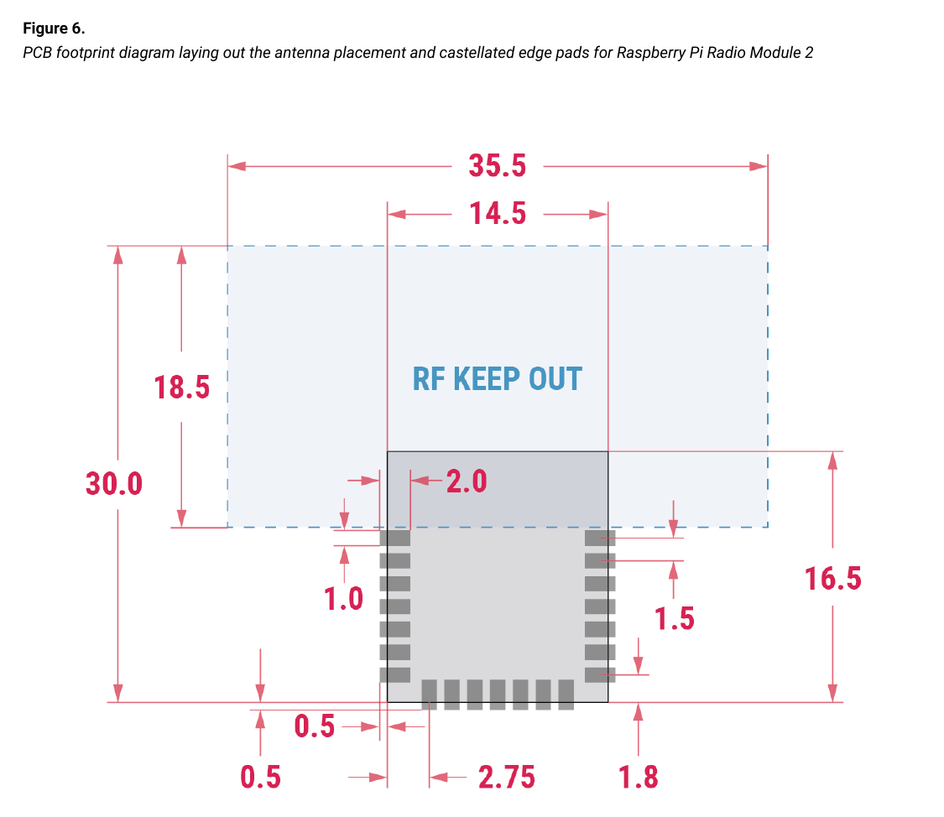
docs/components/img/ds-rm2-footprint.png
