sequoia-hope/bluebuzz/docs/components/img/ds-rm2-gpio.png

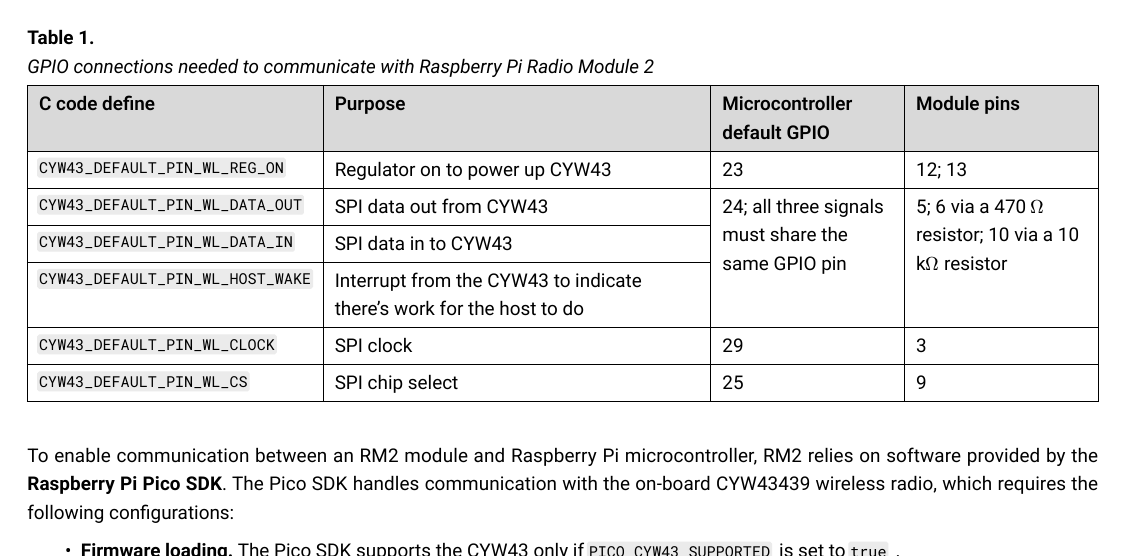
docs/components/img/ds-rm2-gpio.png
