sequoia-hope/bluebuzz/docs/components/img/ds-rm2-pins.png

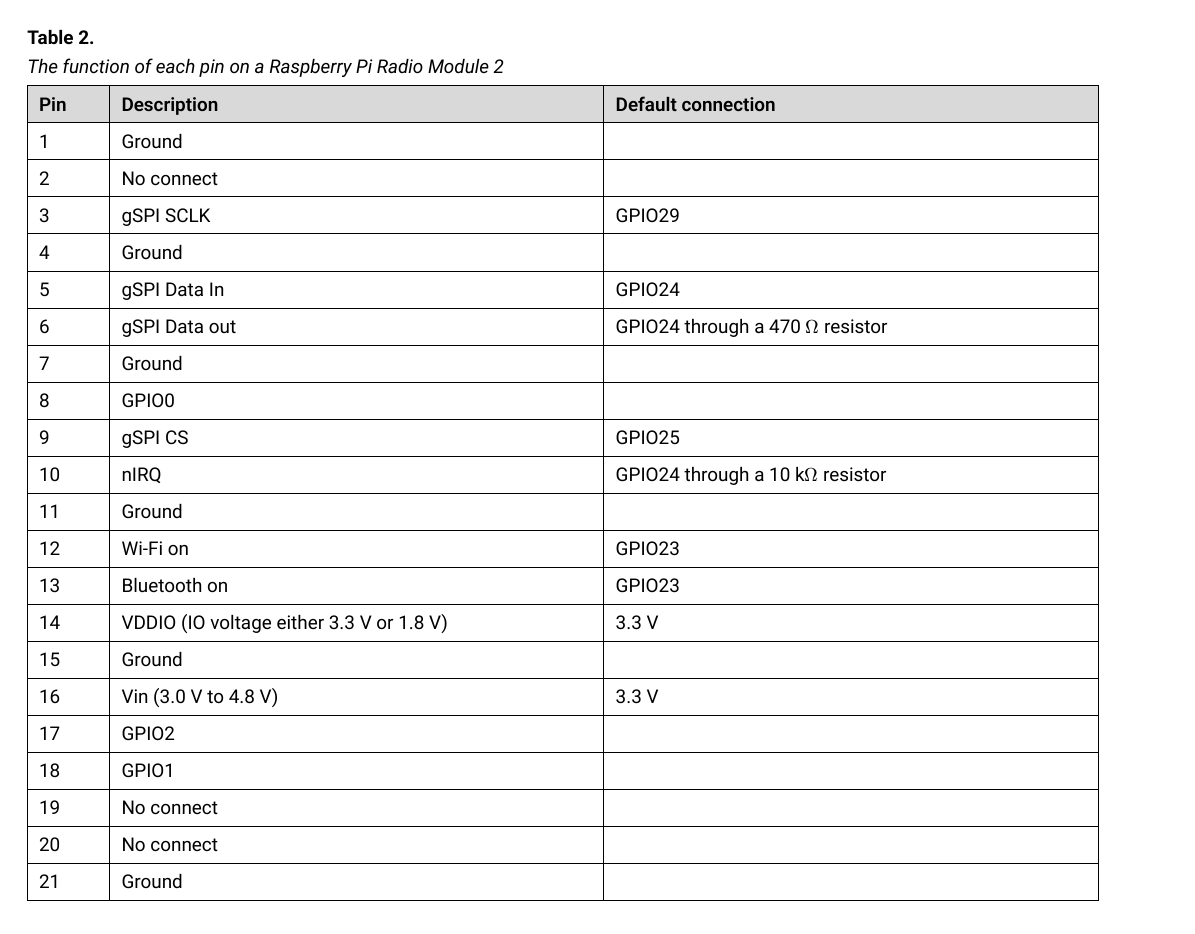
docs/components/img/ds-rm2-pins.png
