sequoia-hope/bluebuzz/docs/components/img/ds-rp2350-fig22.png

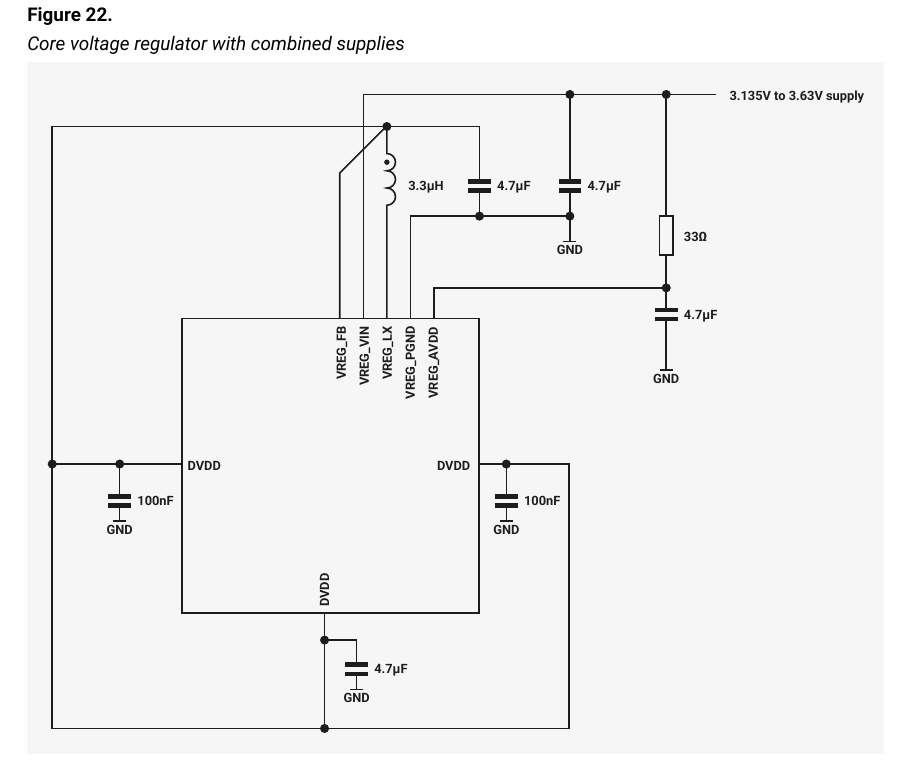
docs/components/img/ds-rp2350-fig22.png
