sequoia-hope/bluebuzz/docs/components/img/ds-rp2350-fig25.png

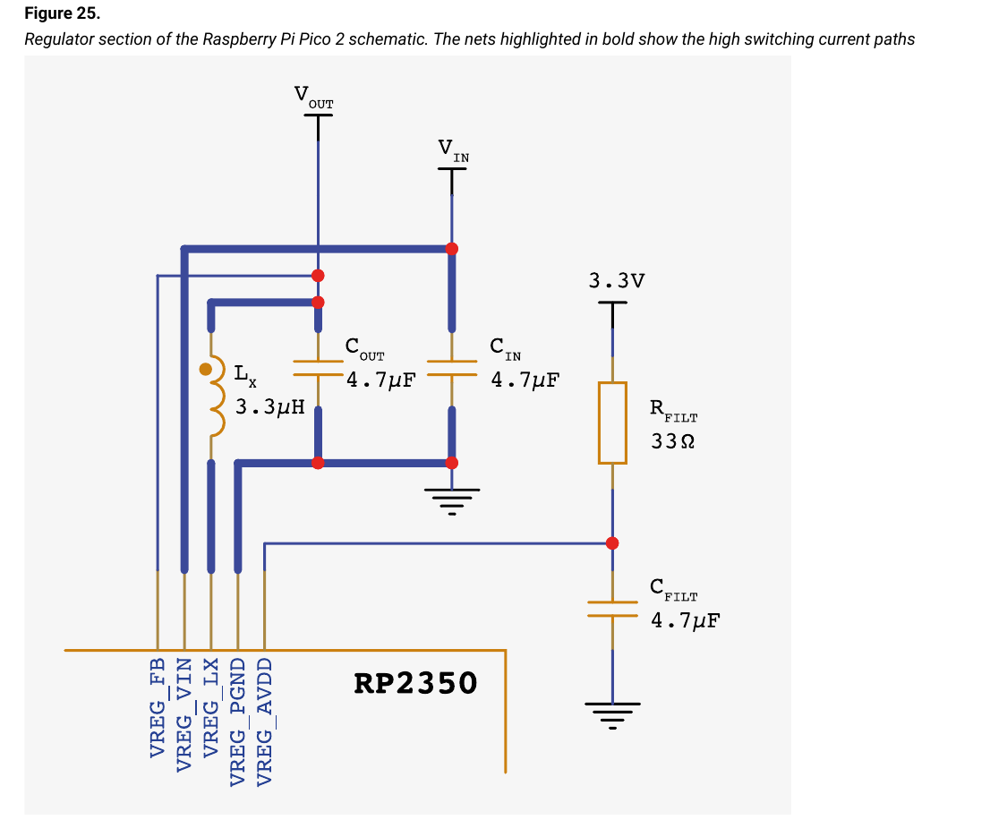
docs/components/img/ds-rp2350-fig25.png
