sequoia-hope/bluebuzz/docs/components/img/ds-tlv-absmax.png

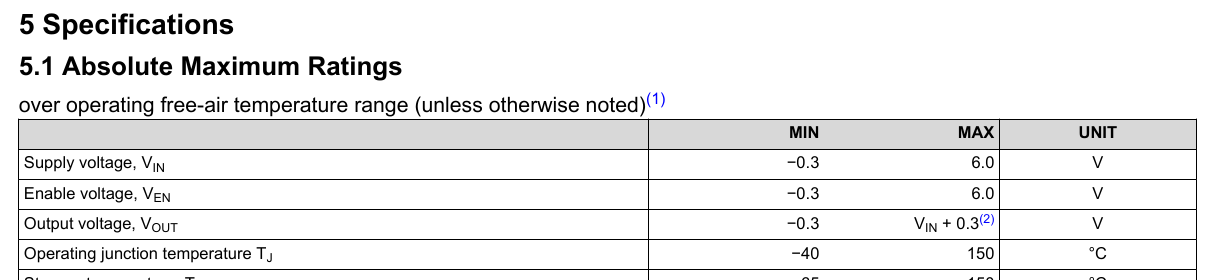
docs/components/img/ds-tlv-absmax.png
