sequoia-hope/bluebuzz/docs/components/img/ds-tlv-ec.png

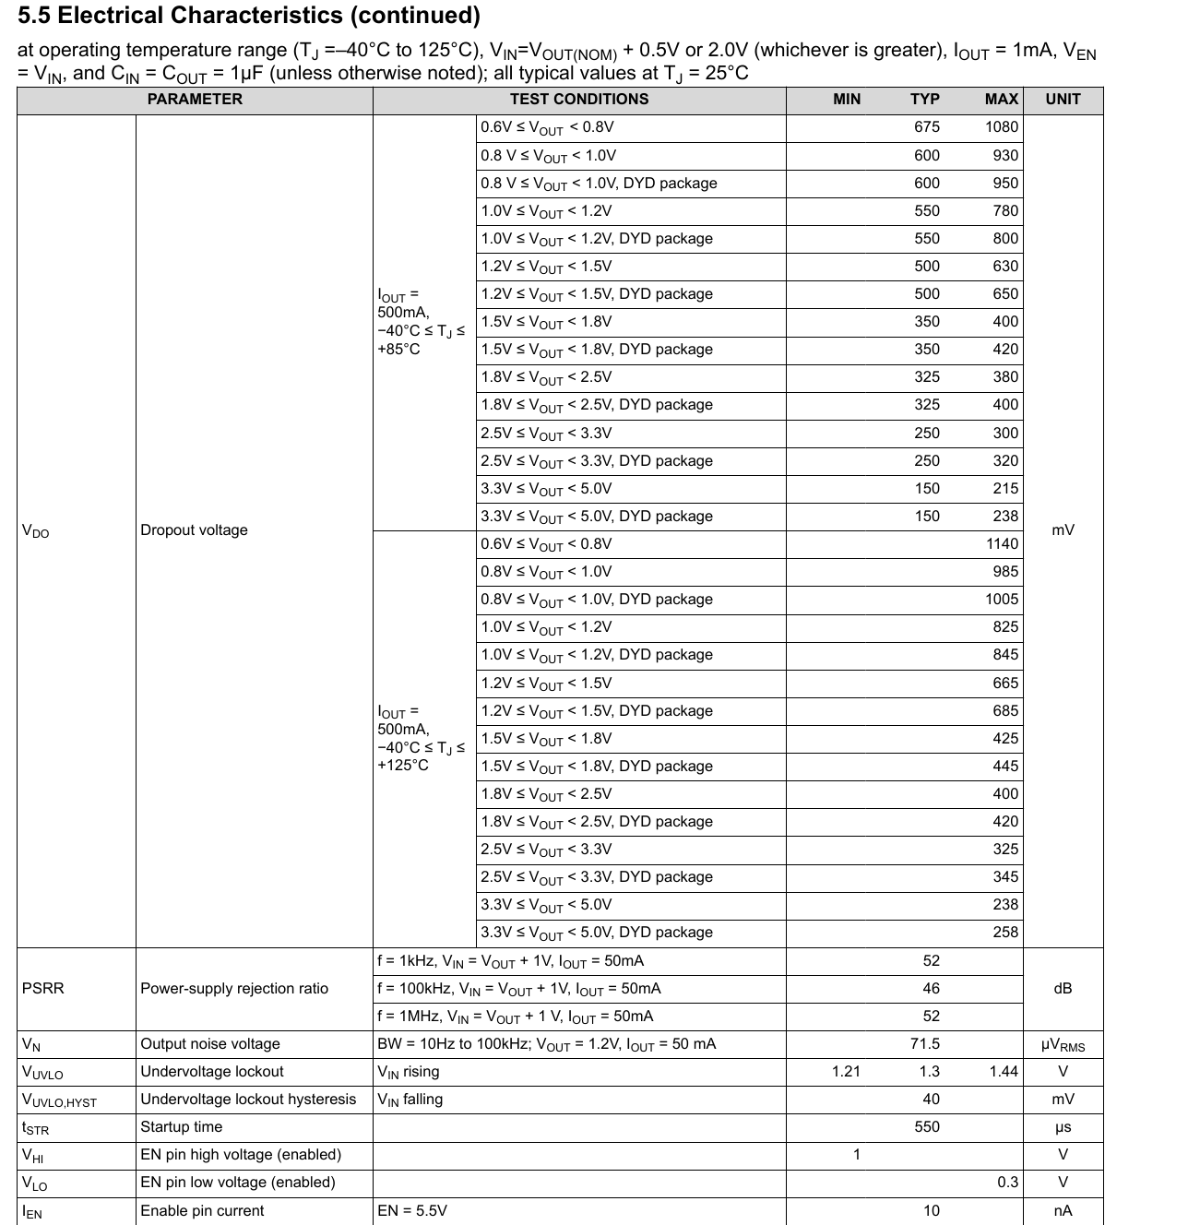
docs/components/img/ds-tlv-ec.png
