sequoia-hope/bluebuzz/docs/components/img/ds-tlv-front.png

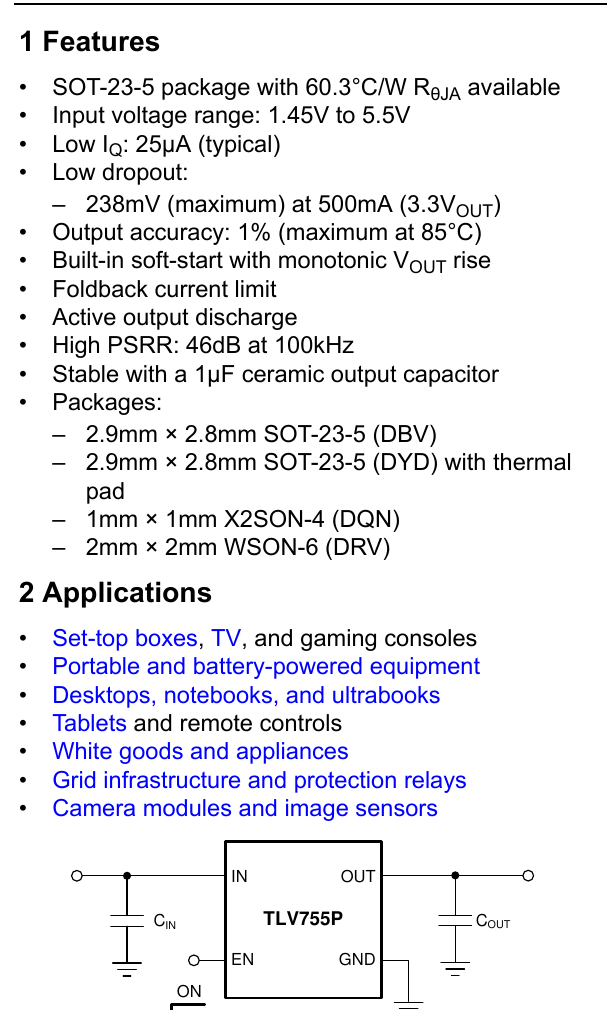
docs/components/img/ds-tlv-front.png
