sequoia-hope/bluebuzz/docs/components/img/ds-tps-front.png

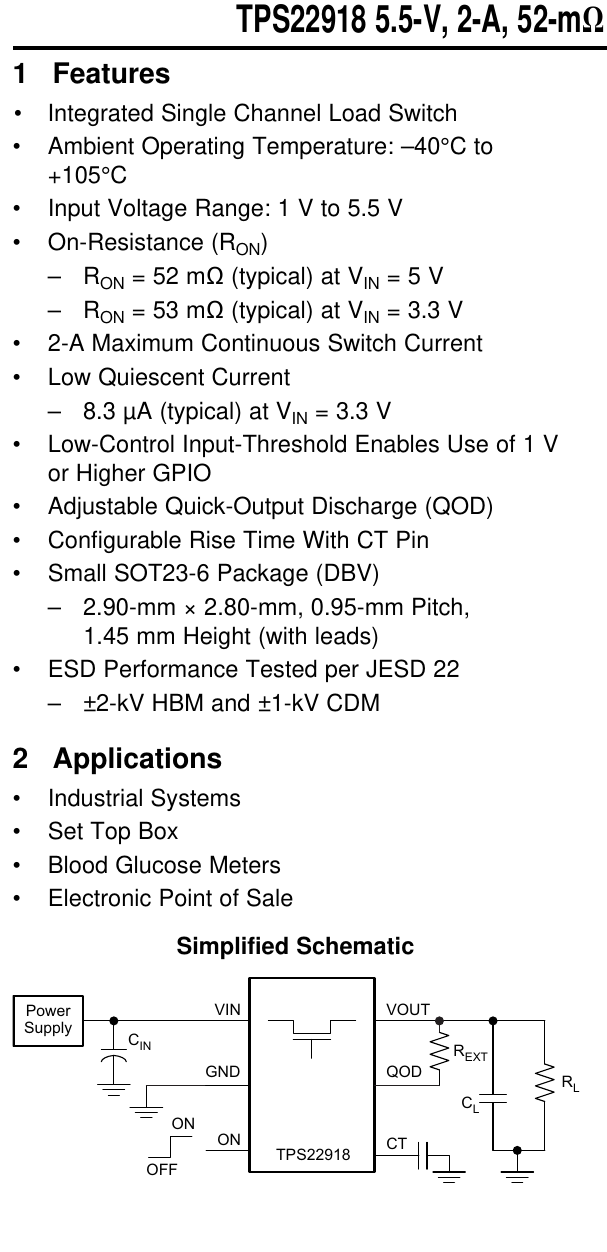
docs/components/img/ds-tps-front.png
