sequoia-hope/bluebuzz/docs/components/img/ds-tps-rise.png

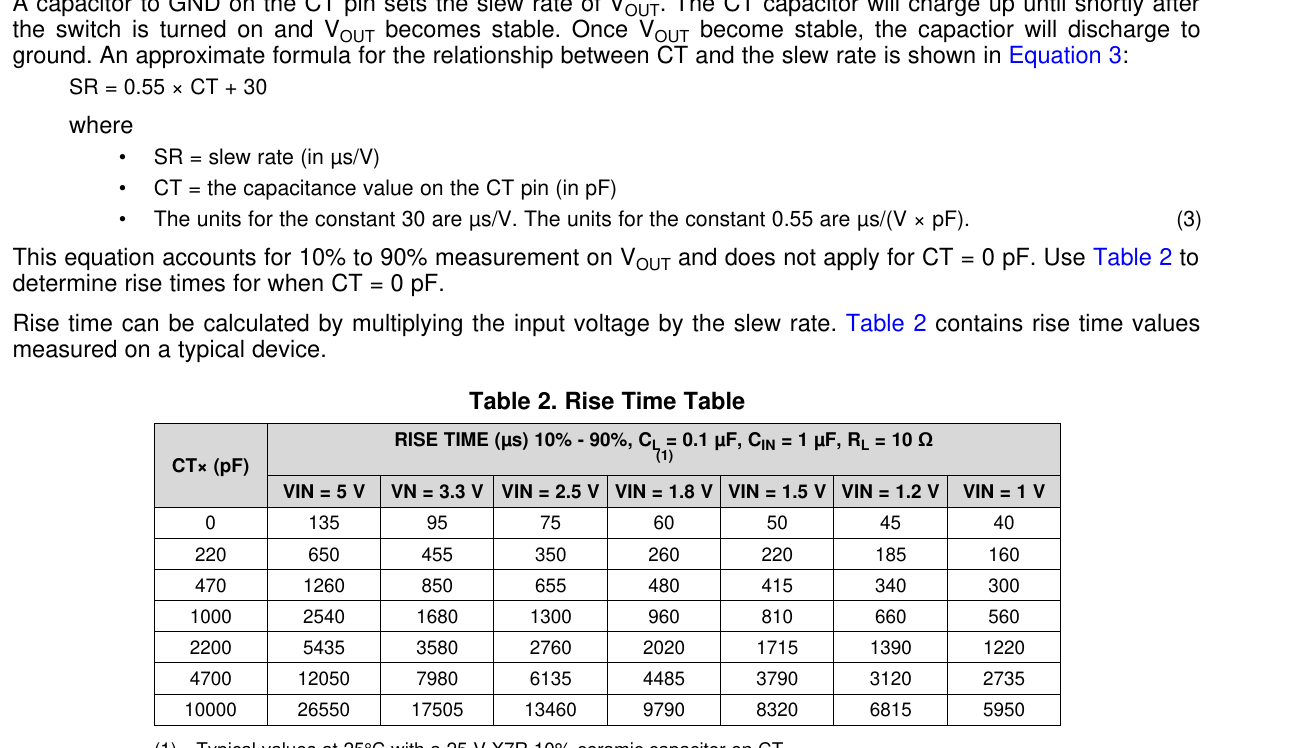
docs/components/img/ds-tps-rise.png
