sequoia-hope/bluebuzz/docs/components/img/ds-w25q-pins.png

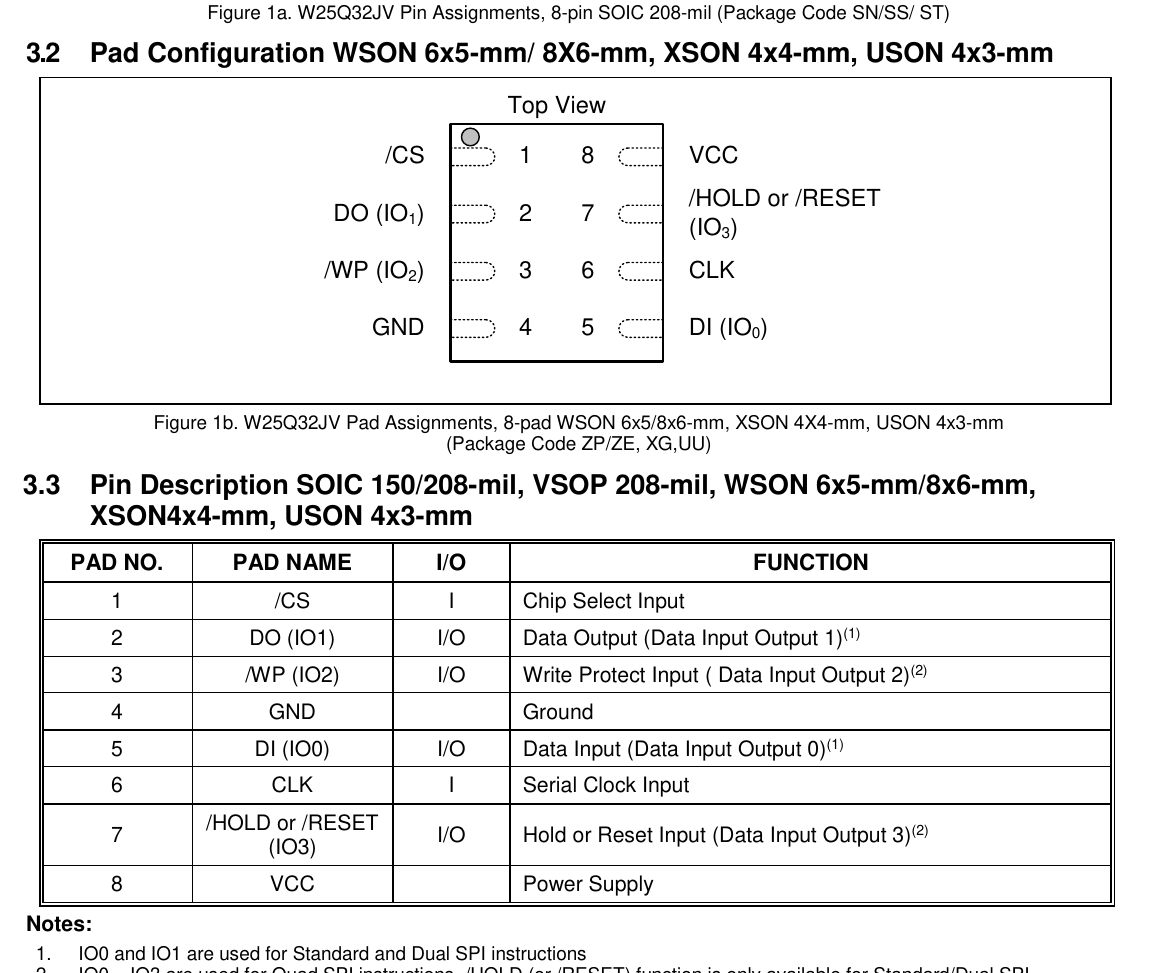
docs/components/img/ds-w25q-pins.png
