sequoia-hope/bluebuzz/docs/components/img/loc-1.png

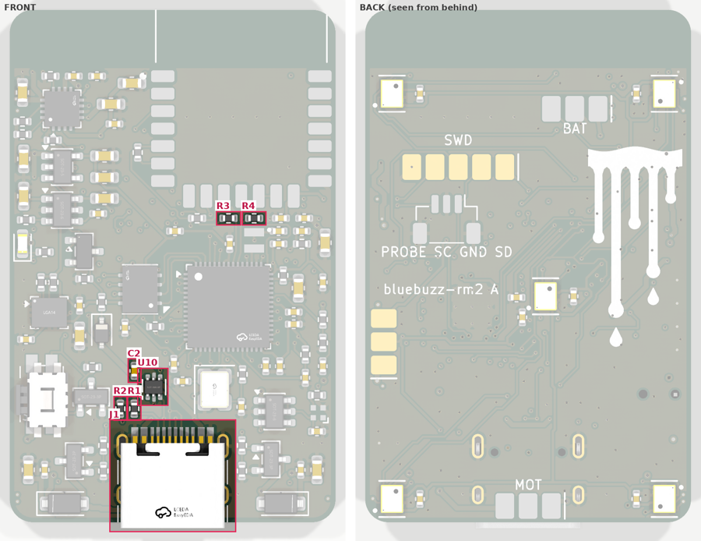
docs/components/img/loc-1.png
