sequoia-hope/bluebuzz/docs/components/img/loc-2.png

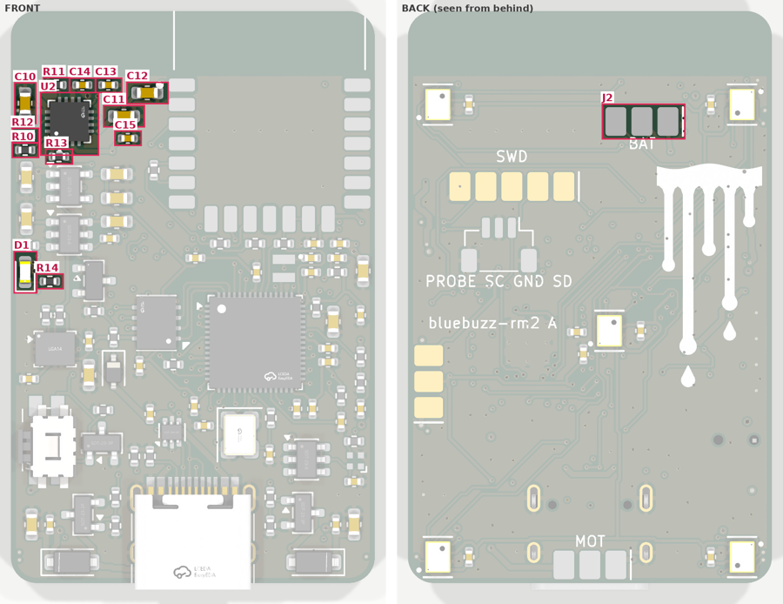
docs/components/img/loc-2.png
