sequoia-hope/bluebuzz/docs/components/img/loc-3.png

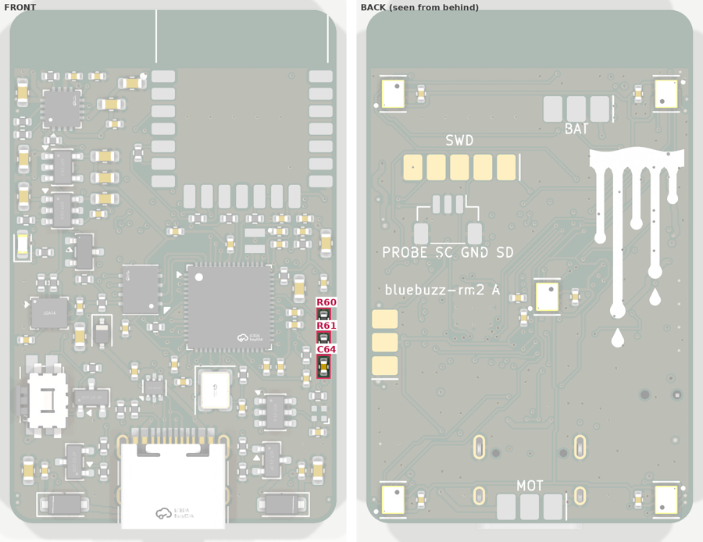
docs/components/img/loc-3.png
