sequoia-hope/bluebuzz/docs/components/img/loc-6.png

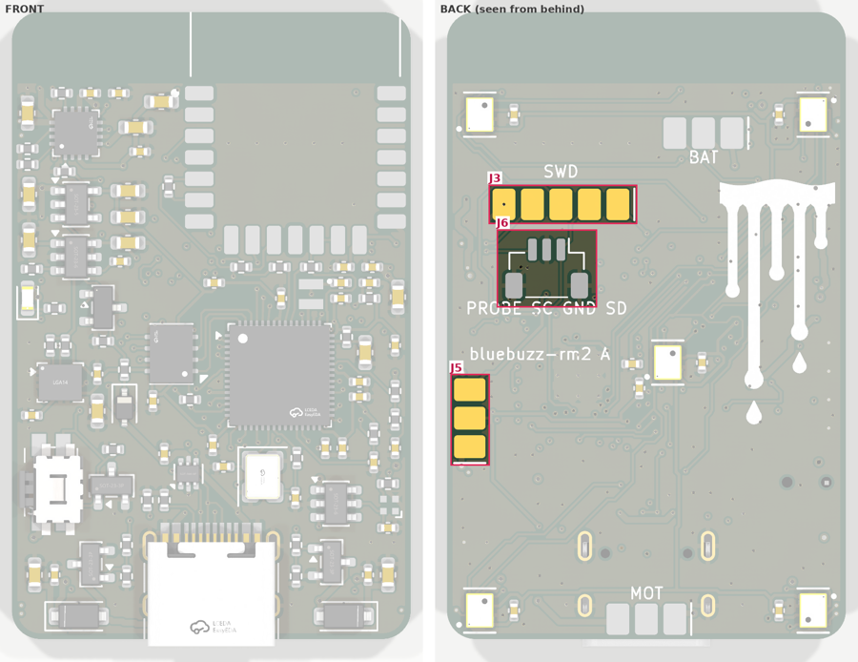
docs/components/img/loc-6.png
