sequoia-hope/bluebuzz/docs/components/img/loc-7.png

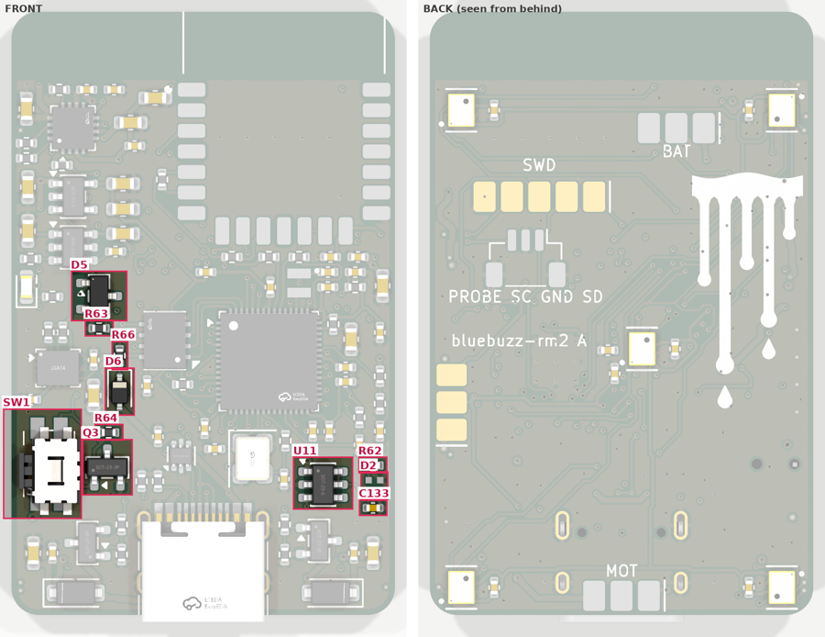
docs/components/img/loc-7.png
