sequoia-hope/bluebuzz/docs/components/img/loc-9.png

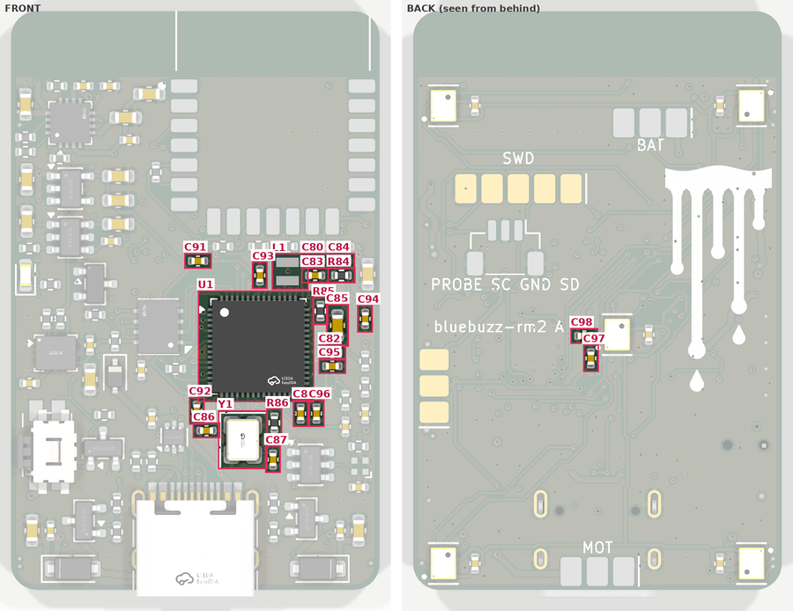
docs/components/img/loc-9.png
