sequoia-hope/bluebuzz/docs/components/img/loc-10.png

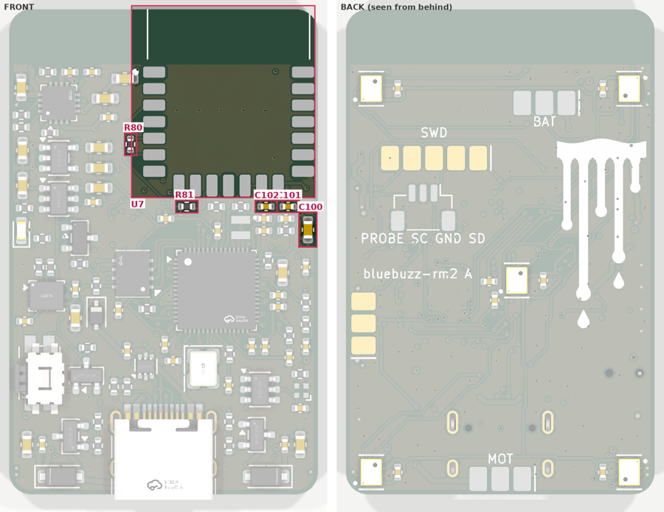
docs/components/img/loc-10.png
