sequoia-hope/bluebuzz/docs/components/img/loc-11.png

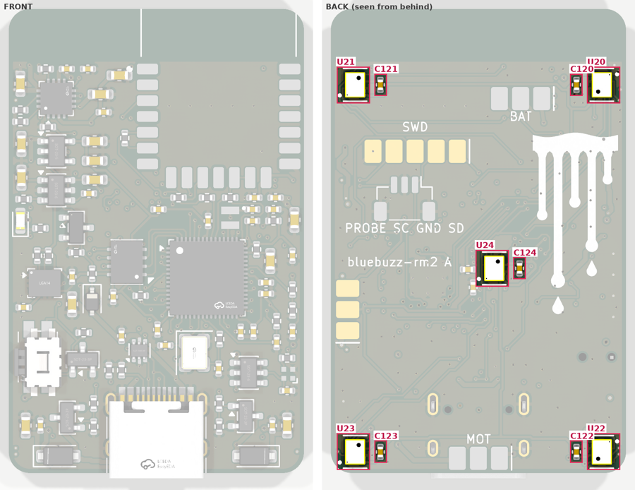
docs/components/img/loc-11.png
