sequoia-hope/bluebuzz/docs/components/img/sch-1.png

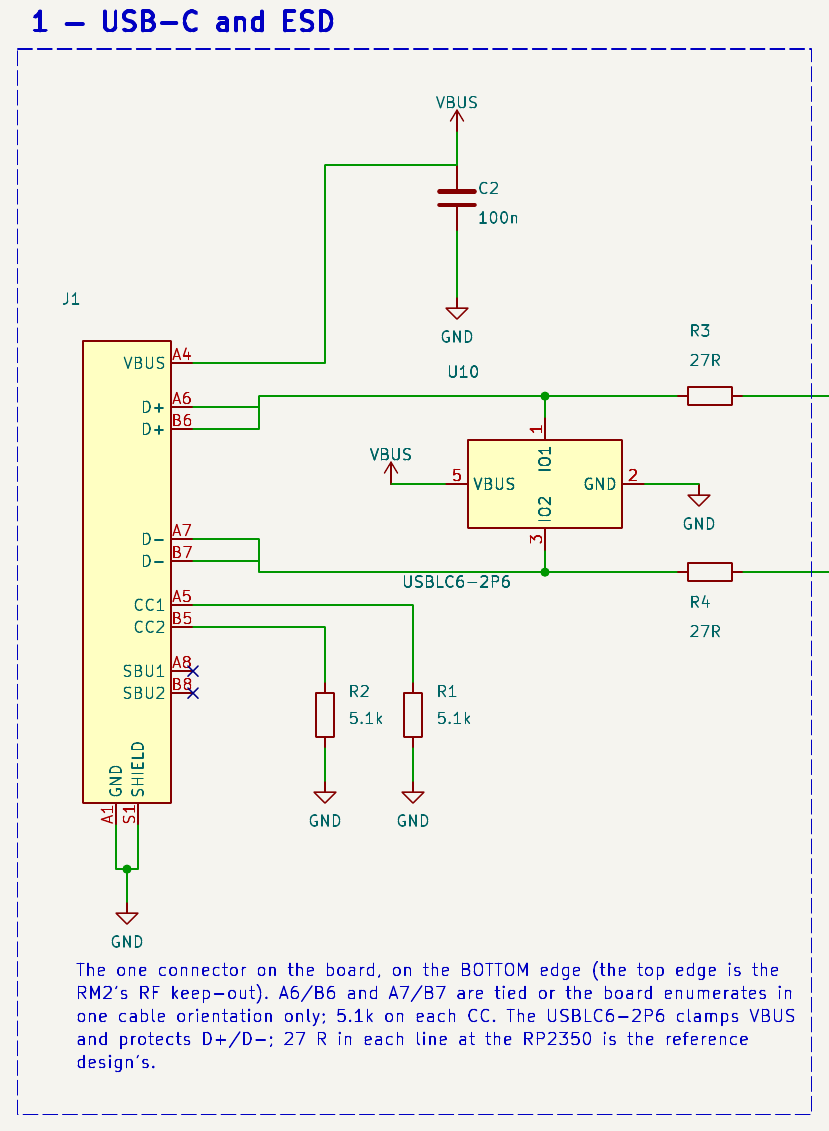
docs/components/img/sch-1.png
