sequoia-hope/bluebuzz/docs/components/img/sch-2.png

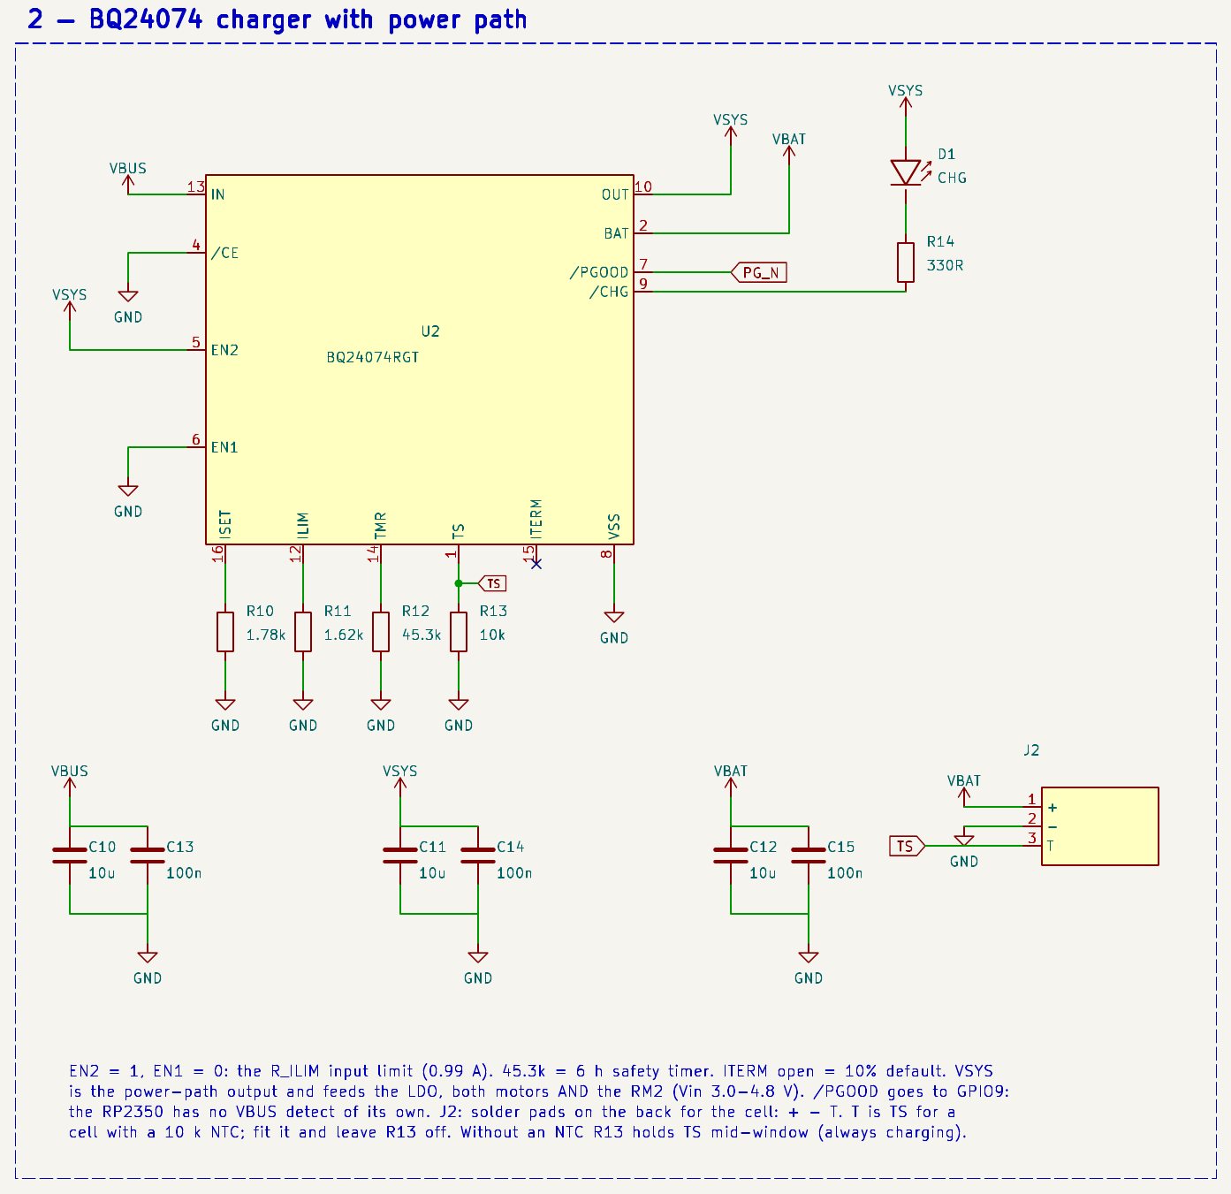
docs/components/img/sch-2.png
