sequoia-hope/bluebuzz/docs/components/img/sch-3.png

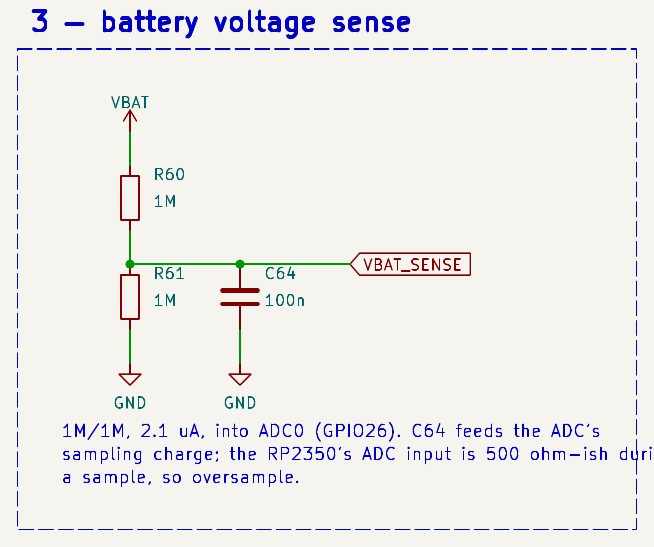
docs/components/img/sch-3.png
