sequoia-hope/bluebuzz/docs/components/img/sch-4.png

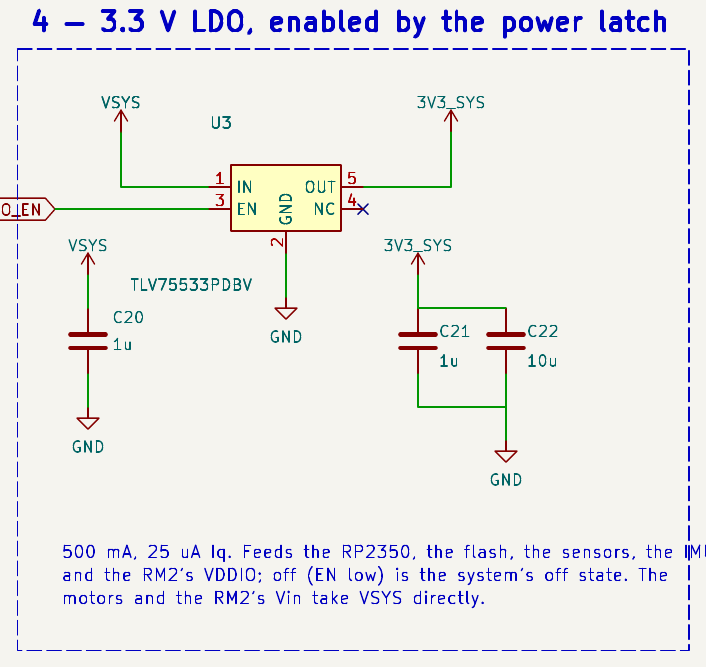
docs/components/img/sch-4.png
