sequoia-hope/bluebuzz/docs/components/img/sch-5.png

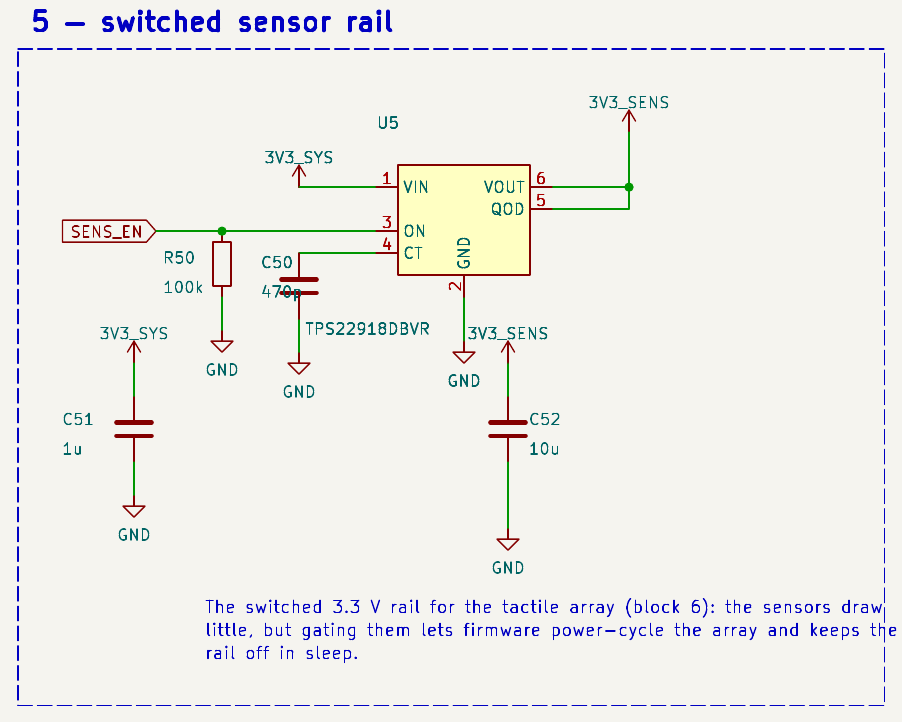
docs/components/img/sch-5.png
