sequoia-hope/bluebuzz/docs/components/img/sch-6.png

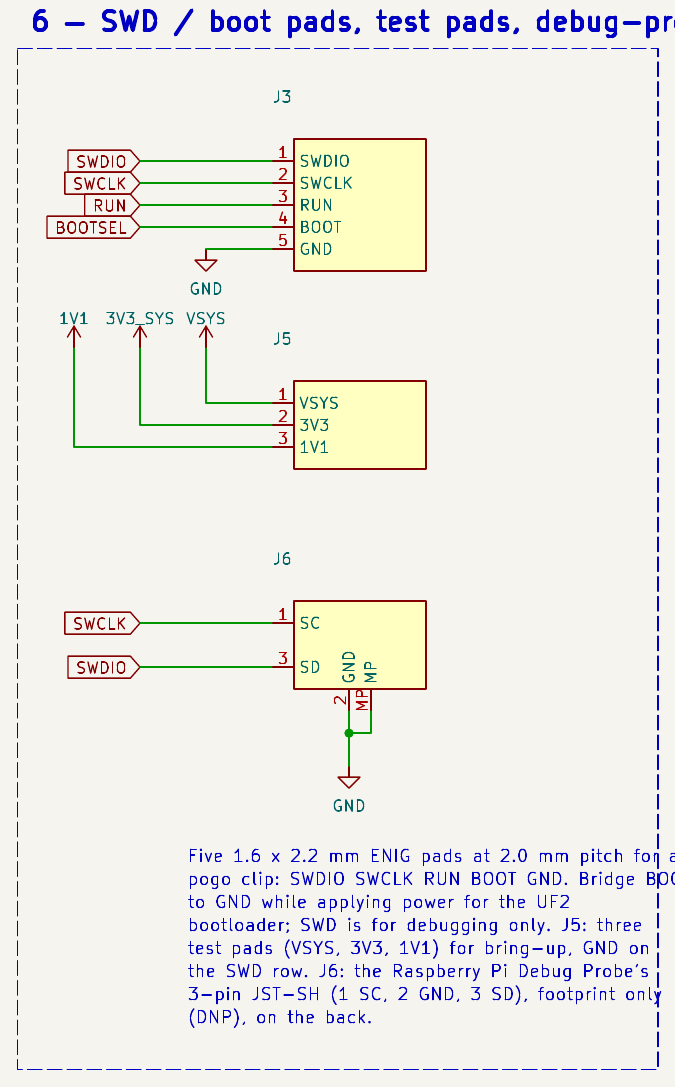
docs/components/img/sch-6.png
