sequoia-hope/bluebuzz/docs/components/img/sch-7.png

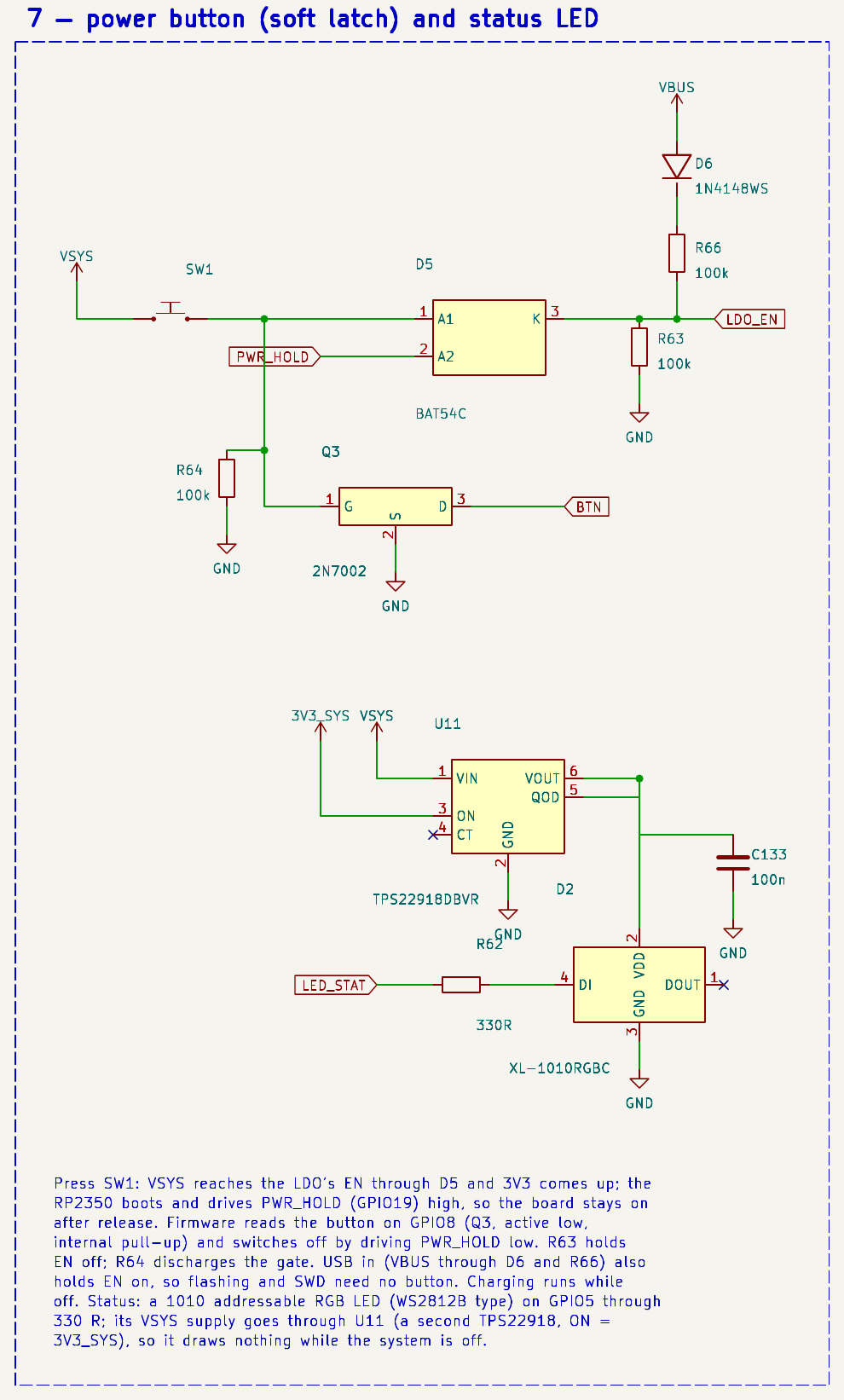
docs/components/img/sch-7.png
