sequoia-hope/bluebuzz/docs/components/img/sch-8.png

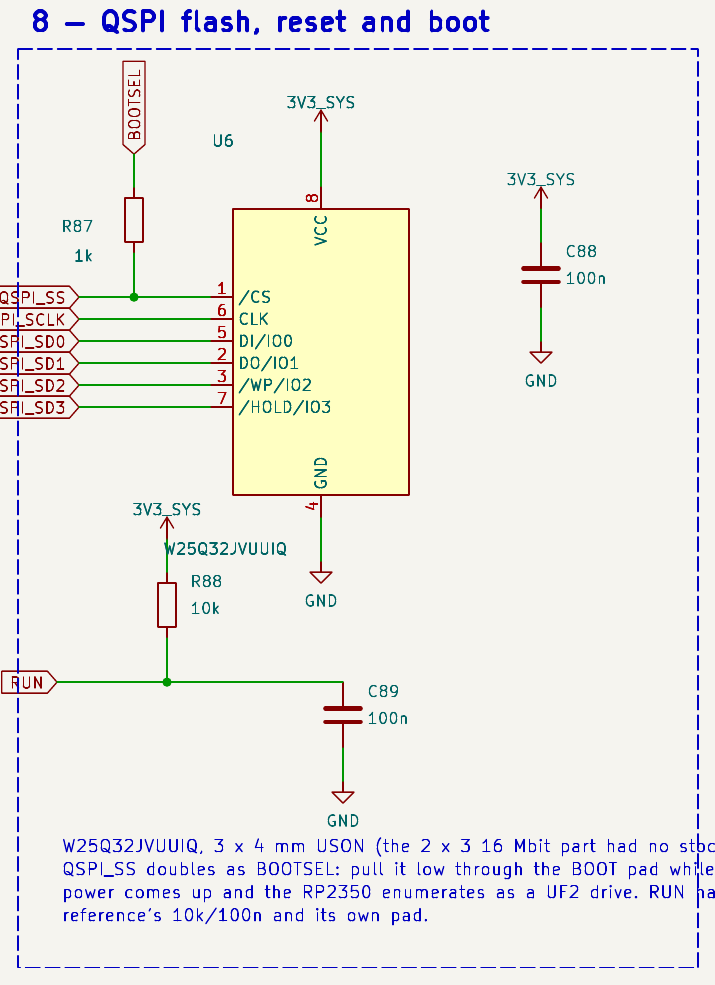
docs/components/img/sch-8.png
