sequoia-hope/bluebuzz/docs/components/img/sch-9.png

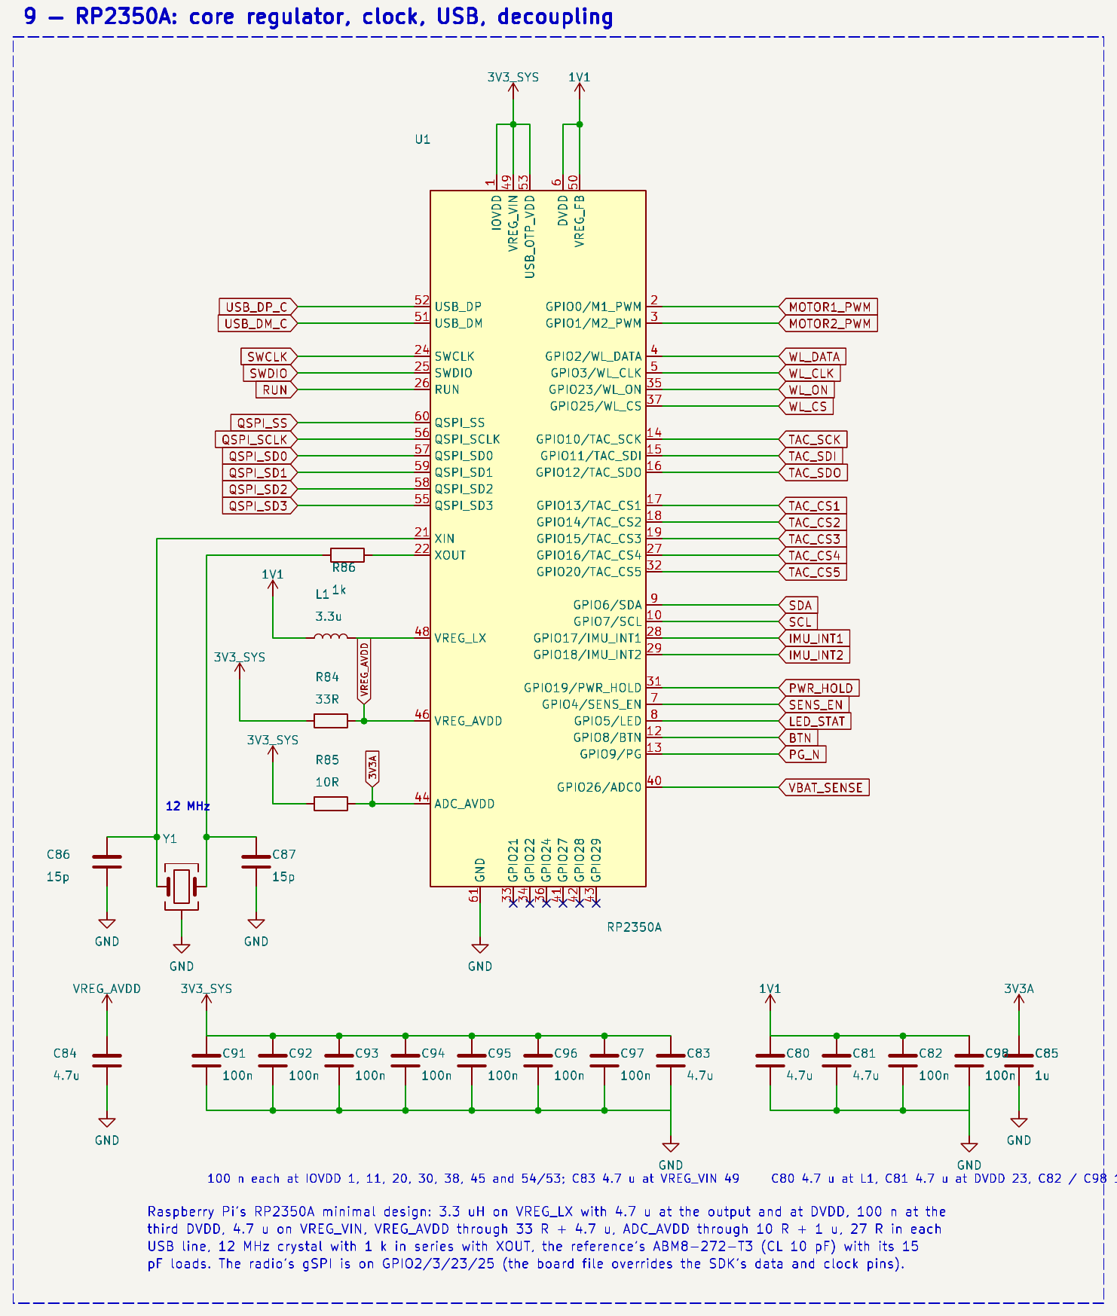
docs/components/img/sch-9.png
