sequoia-hope/bluebuzz/docs/components/img/sch-10.png

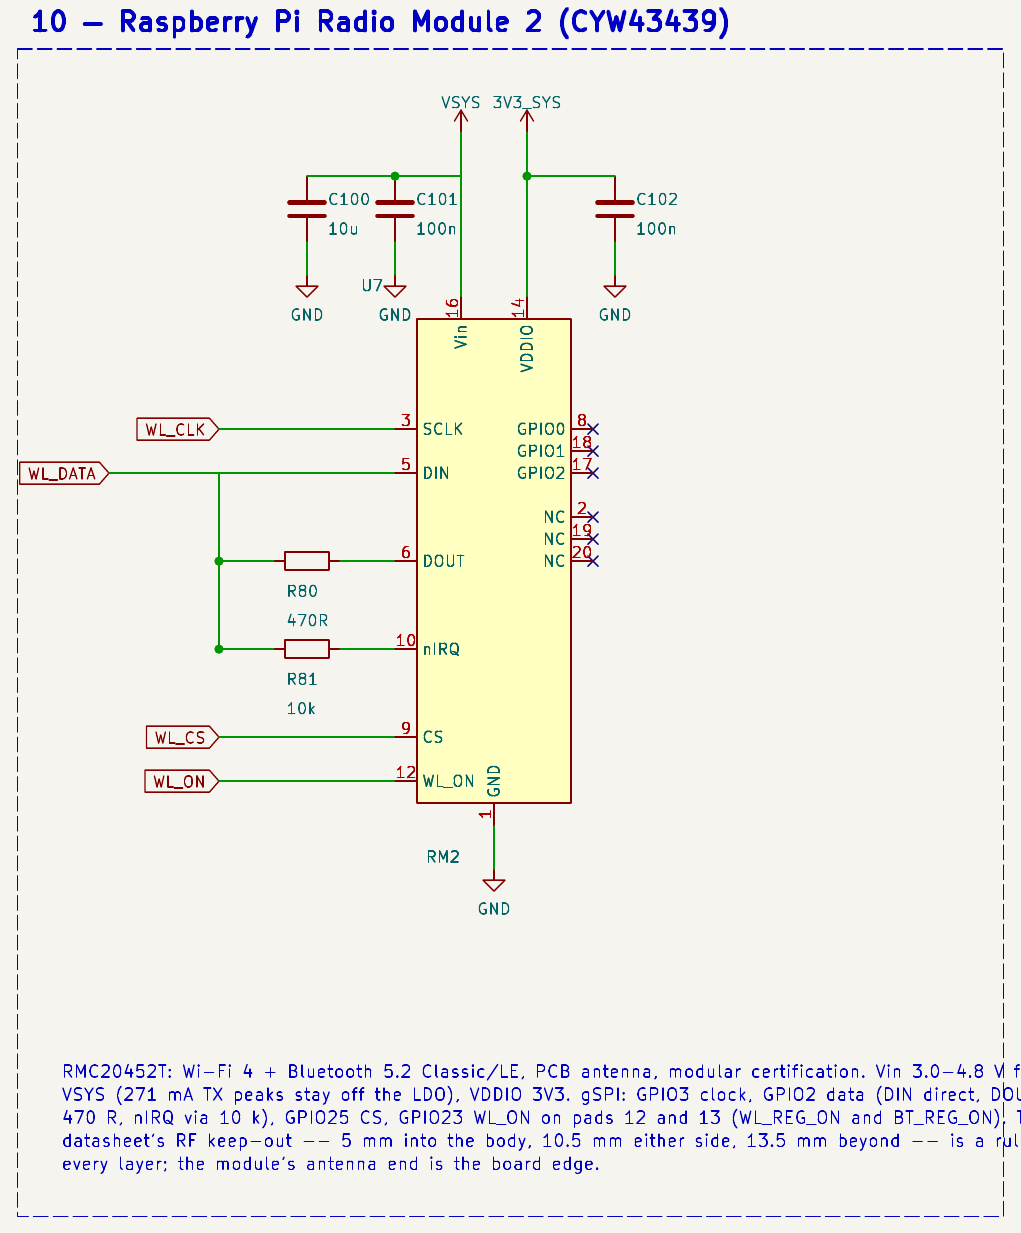
docs/components/img/sch-10.png
