sequoia-hope/bluebuzz/docs/components/img/sch-11.png

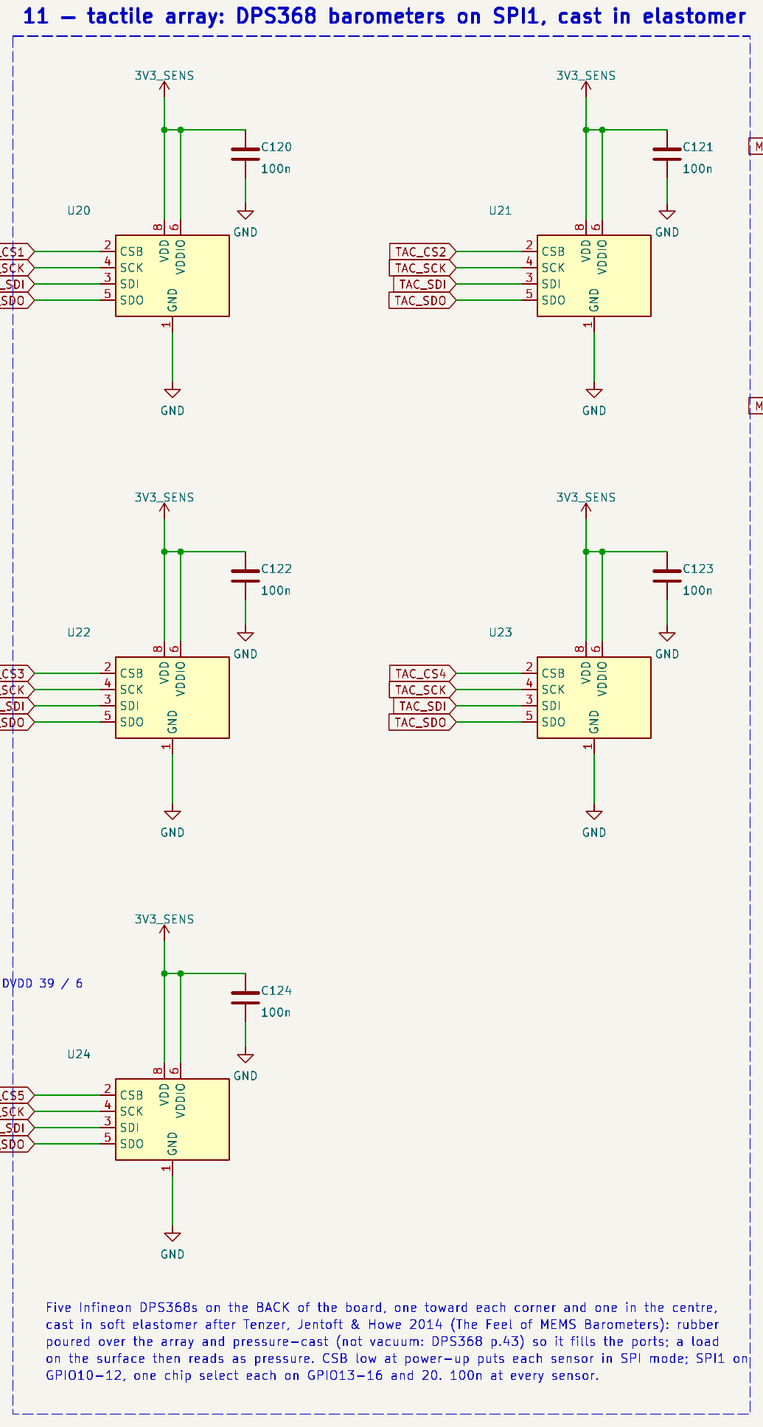
docs/components/img/sch-11.png
