sequoia-hope/bluebuzz/docs/components/img/sch-12.png

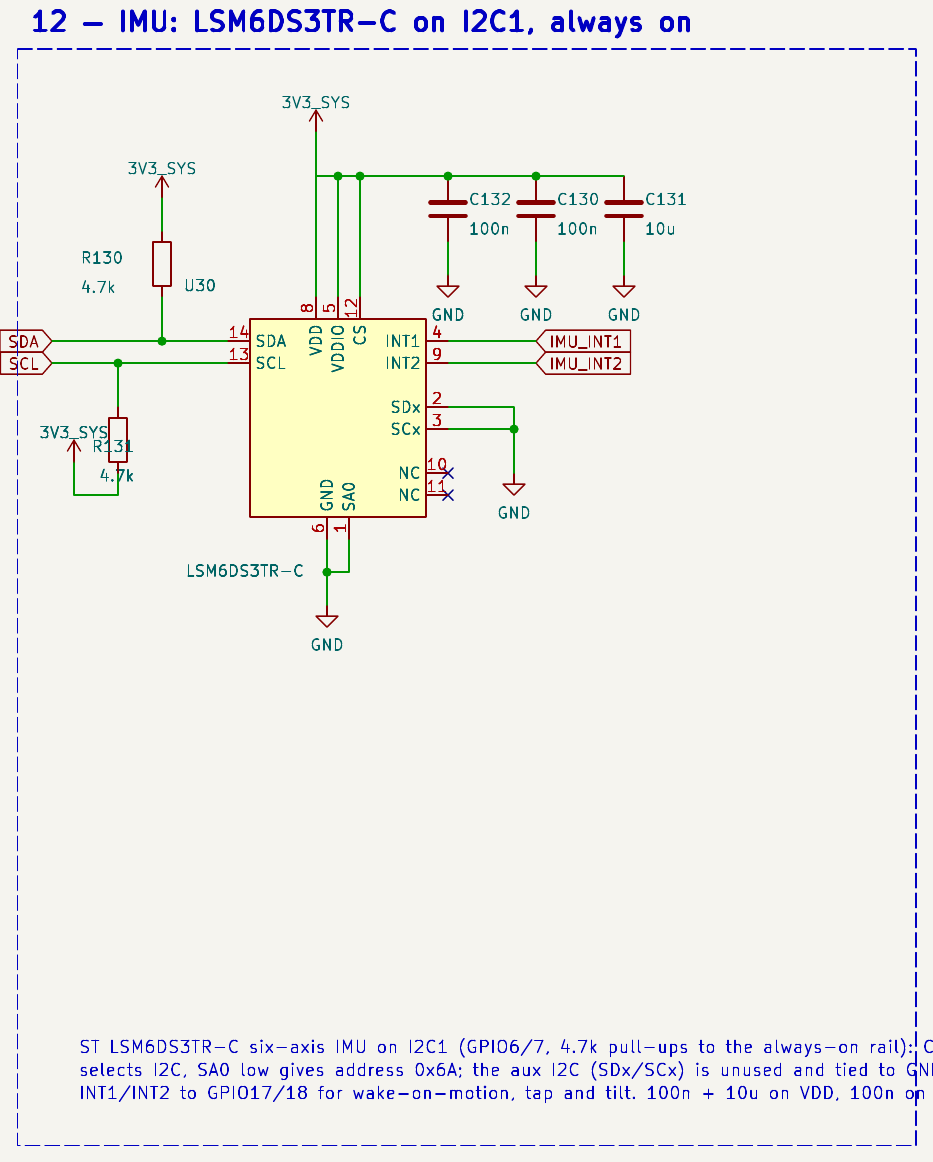
docs/components/img/sch-12.png
