sequoia-hope/bluebuzz/docs/components/img/sch-13.png

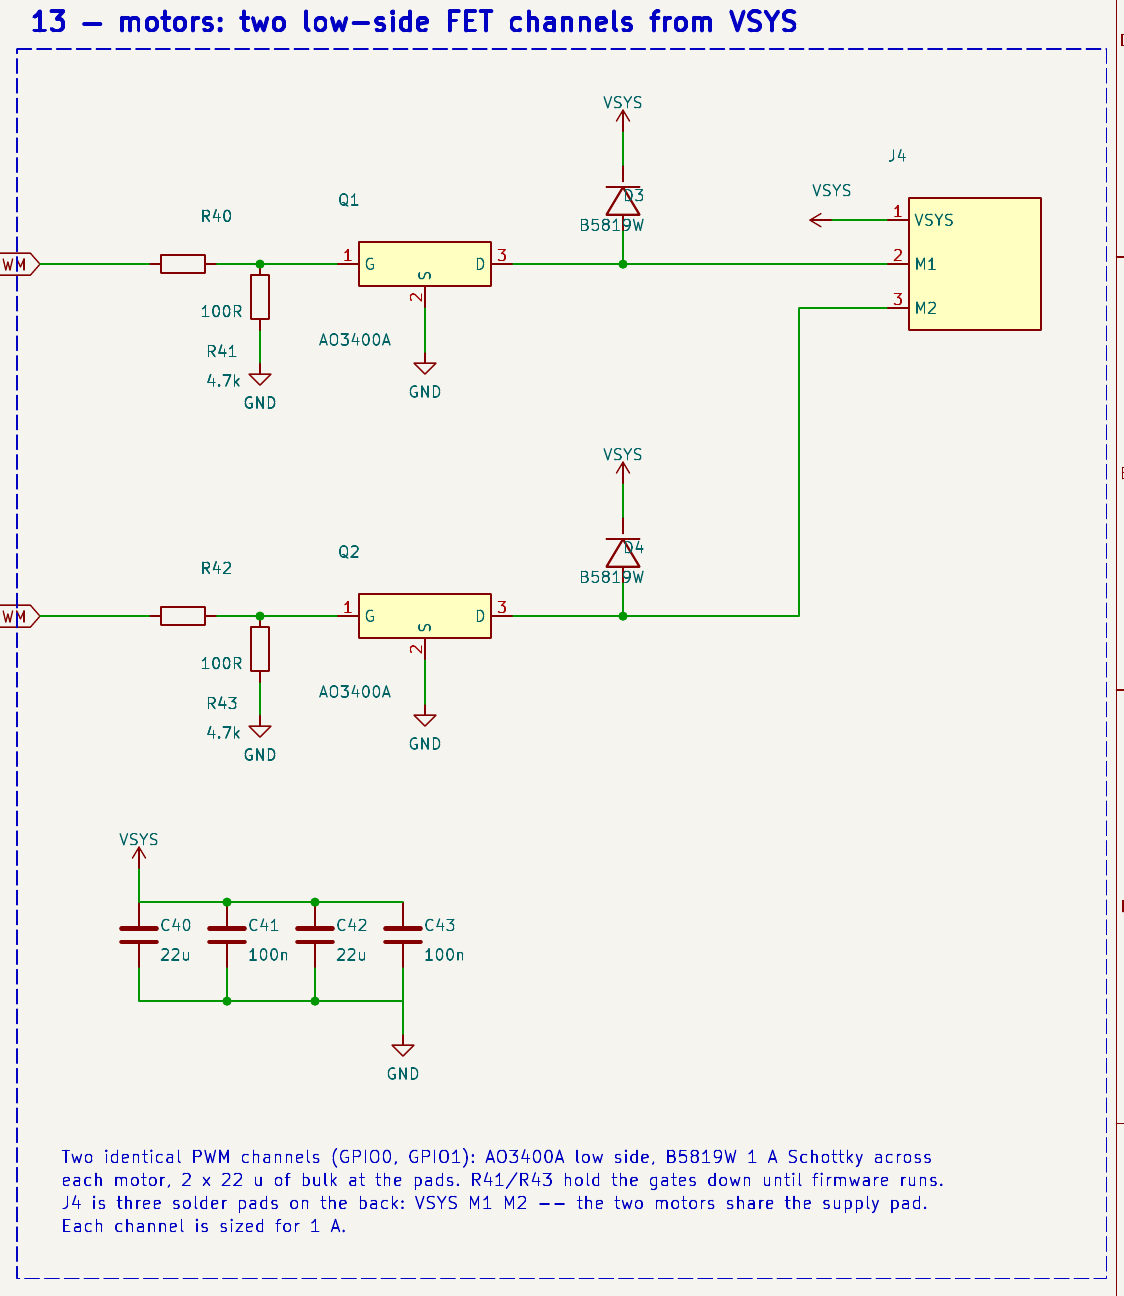
docs/components/img/sch-13.png
