sequoia-hope/bluebuzz/docs/components/img/sch-all.jpg

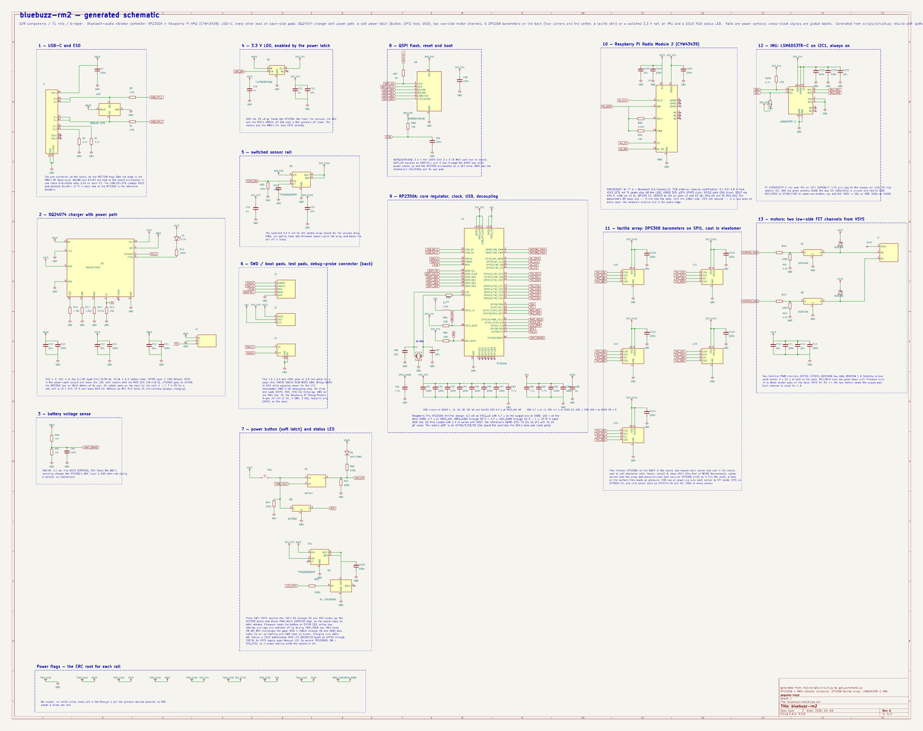
docs/components/img/sch-all.jpg
