sequoia-hope/bluebuzz/design/squish_pcb.dxf

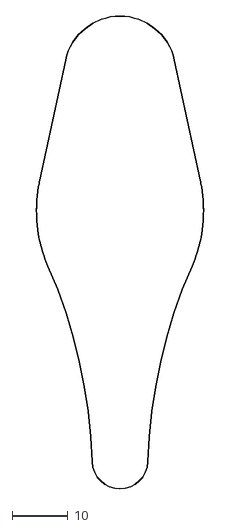
[picture p73: CAD file, 2026-10-22]
design/squish_pcb.dxf
30.0 x 84.9
