sequoia-hope/bluebuzz/out/bluebuzz-rm2.step

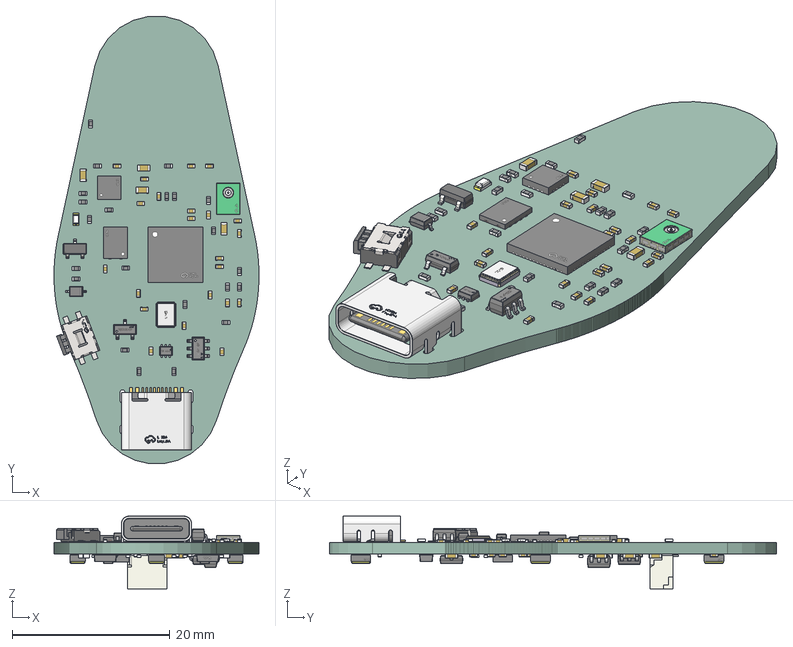
[picture p74: CAD file, 2026-10-22]
out/bluebuzz-rm2.step
26.0 x 56.7 x 9.25 mm
C0402_L1.0-W0.5-H0.5 x 35
R0402_L1.0-W0.5-H0.4 x 29
SOT-23-6_L2.9-W1.6-H1.5-LS2.8-P0.95 x 2
C0603_L1.6-W0.8-H0.8 x 13
USB-C_SMD-TYPE-C-31-M-12_1
QFN-16_L3.0-W3.0-P0.50-EP1.7
SOT-666-6P_L1.6-W1.2-H0.6-LS1.6-P0.50
LED0603-RD_GREEN
USON-8_L4.0-W3.0-H0.6-P0.80-BL_GD25Q32CNIGR
QFN-60_L7.0-W7.0-P0.40-TL-EP3.4
CRYSTAL-SMD_4P-L3.2-W2.5-BL
SOT-23
SOT-23-3P_L2.9-W1.3-H1.0-LS2.4-P0.95 x 3
SW-SMD_EVQPUC02K-L4.5-W4.7-H1.7-P5.25-LS6.4
SOD-323_L1.8-W1.3-LS2.5-RD
MIC-SMD_5P-L3.0-W4.0-P0.85-BL
SOD-123_L2.7-W1.6-LS3.7-RD-1 x 2
LGA-8_L2.5-W2.0-P0.65-TR_DPS368 x 4
LGA-14_L2.5-W3.0-H0.9-P0.50
SOT-23-5_L2.9-W1.6-H1.1-LS2.8-P0.95
JST_SH_BM03B-SRSS-TB_1x03-1MP_P1.00mm_Vertical
bluebuzz-rm2_PCB
