sequoia-hope/bluebuzz/out/bluebuzz-rm2-schematic.pdf

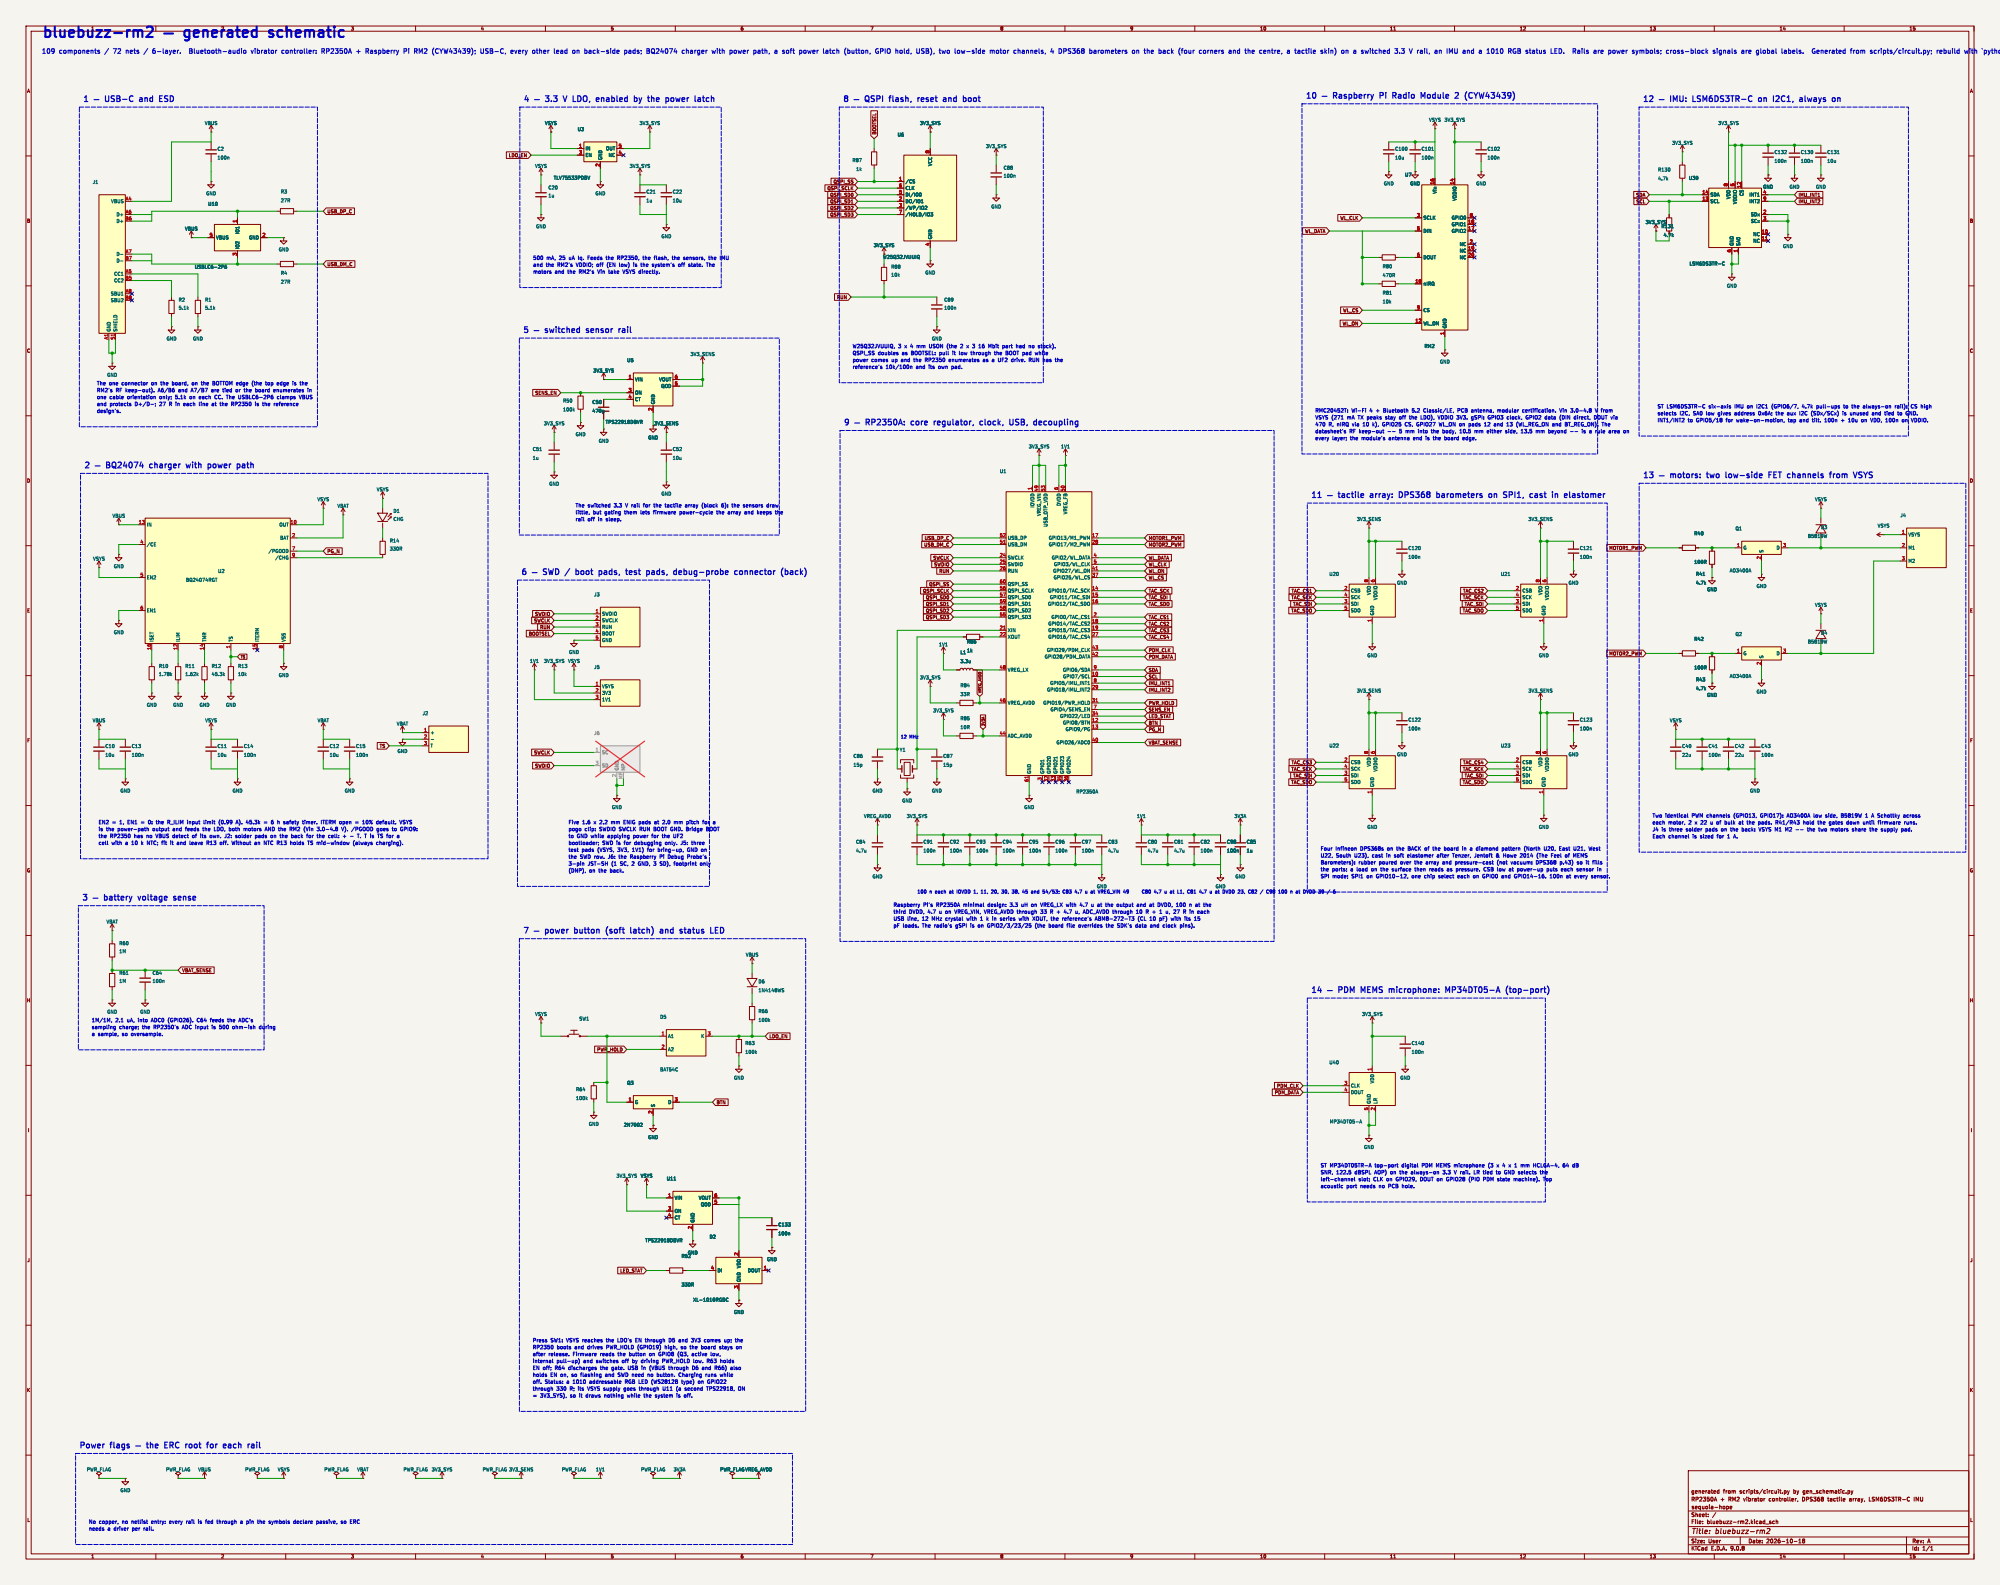
[picture p75: page 1]

/CS 1 CLK 6 DI/IO0 5 DO/IO1 2

500 mA, 25 uA Iq. Feeds the RP2350, the flash, the sensors, the IMU
and the RM2's VDDIO; off (EN low) is the system's off state. The
motors and the RM2's Vin take VSYS directly.

5 þÿ switched sensor rail

QSPI_SS doubles as BOOTSEL: pull it low through the BOOT pad while W25Q32JVUUIQ, 3 x 4 mm USON (the 2 x 3 16 Mbit part had no stock).

VSYS (271 mA TX peaks stay off the LDO), VDDIO 3V3. gSPI: GPIO3 clock, GPIO2 data (DIN direct, DOUT via
470 R, nIRQ via 10 k), GPIO25 CS, GPIO27 WL_ON on pads 12 and 13 (WL_REG_ON and BT_REG_ON). The

J6 SWDIO 1 SWCLK 2 RUN 3 BOOT 4 GND 5

Five 1.6 x 2.2 mm ENIG pads at 2.0 mm pitch for a
pogo clip: SWDIO SWCLK RUN BOOT GND. Bridge BOOT

the RP2350 has no VBUS detect of its own. J2: solder pads on the back for the cell: + - T. T is TS for a

Four Infineon DPS368s on the BACK of the board in a diamond pattern (North U20, East U21, West

C80 4.7 u at L1, C81 4.7 u at DVDD 23, C82 / C98 100 n at DVDD 39 / 6

7 þÿ power button (soft latch) and status LED

3 DOUT 1 D2 XL-1010RGBC GND GND

RP2350 boots and drives PWR_HOLD (GPIO19) high, so the board stays on
after release. Firmware reads the button on GPIO8 (Q3, active low,

through 330 R; its VSYS supply goes through U11 (a second TPS22918, ON
= 3V3_SYS), so it draws nothing while the system is off.

needs a driver per rail.
