sequoia-hope/bluebuzz/design/renders/schematic.pdf

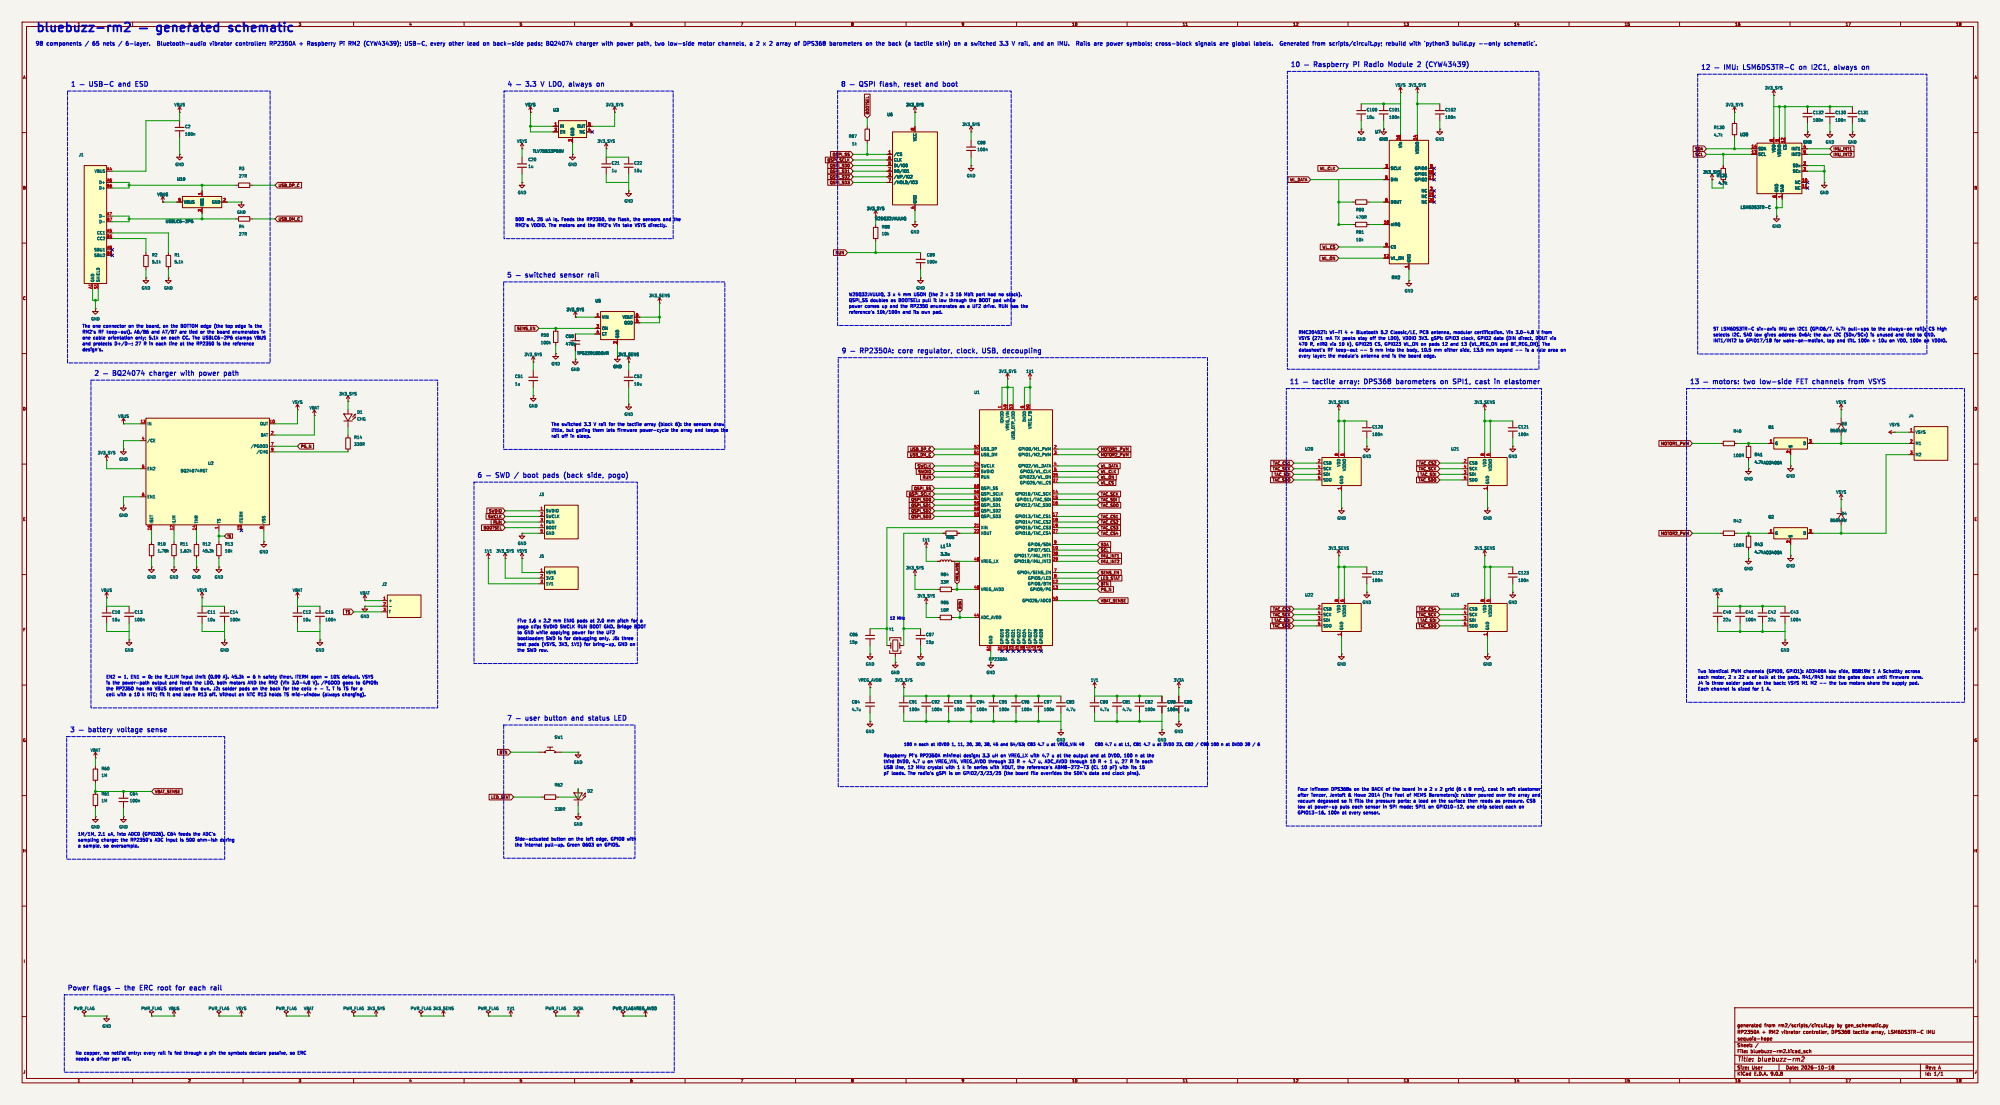
[picture p76: page 1]

10 þÿ Raspberry Pi Radio Module 2 (CYW43439)

4 þÿ 3.3 V LDO, always on

8 þÿ QSPI flash, reset and boot
3V3_SYS U6 W25Q32JVUUIQ

3 GND 2 U10 USBLC6-2P6 VBUS GND A1 SHIELD S1 VBUS A4 D+ A6 D+ B6 D- A7 D- B7 CC1 A5 CC2 B5 SBU1 A8 SBU2 B8

2 OUT 5 NC 4 VSYS GND

5 þÿ switched sensor rail

W25Q32JVUUIQ, 3 x 4 mm USON (the 2 x 3 16 Mbit part had no stock).
QSPI_SS doubles as BOOTSEL: pull it low through the BOOT pad while

VSYS (271 mA TX peaks stay off the LDO), VDDIO 3V3. gSPI: GPIO3 clock, GPIO2 data (DIN direct, DOUT via
470 R, nIRQ via 10 k), GPIO25 CS, GPIO23 WL_ON on pads 12 and 13 (WL_REG_ON and BT_REG_ON). The

rail off in sleep. Five 1.6 x 2.2 mm ENIG pads at 2.0 mm pitch for a

6 þÿ SWD / boot pads (back side, pogo)

SWDIO 1 SWCLK 2 RUN 3 BOOT 4 GND 5

pogo clip: SWDIO SWCLK RUN BOOT GND. Bridge BOOT Power flags þÿ the ERC root for each rail

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

3 þÿ battery voltage sense

Four Infineon DPS368s on the BACK of the board in a 2 x 2 grid (6 x 8 mm), cast in soft elastomer
vacuum degassed so it fills the pressure ports; a load on the surface then reads as pressure. CSB

needs a driver per rail.
