sequoia-hope/bluebuzz/viewer/a/sch/bluebuzz.pdf

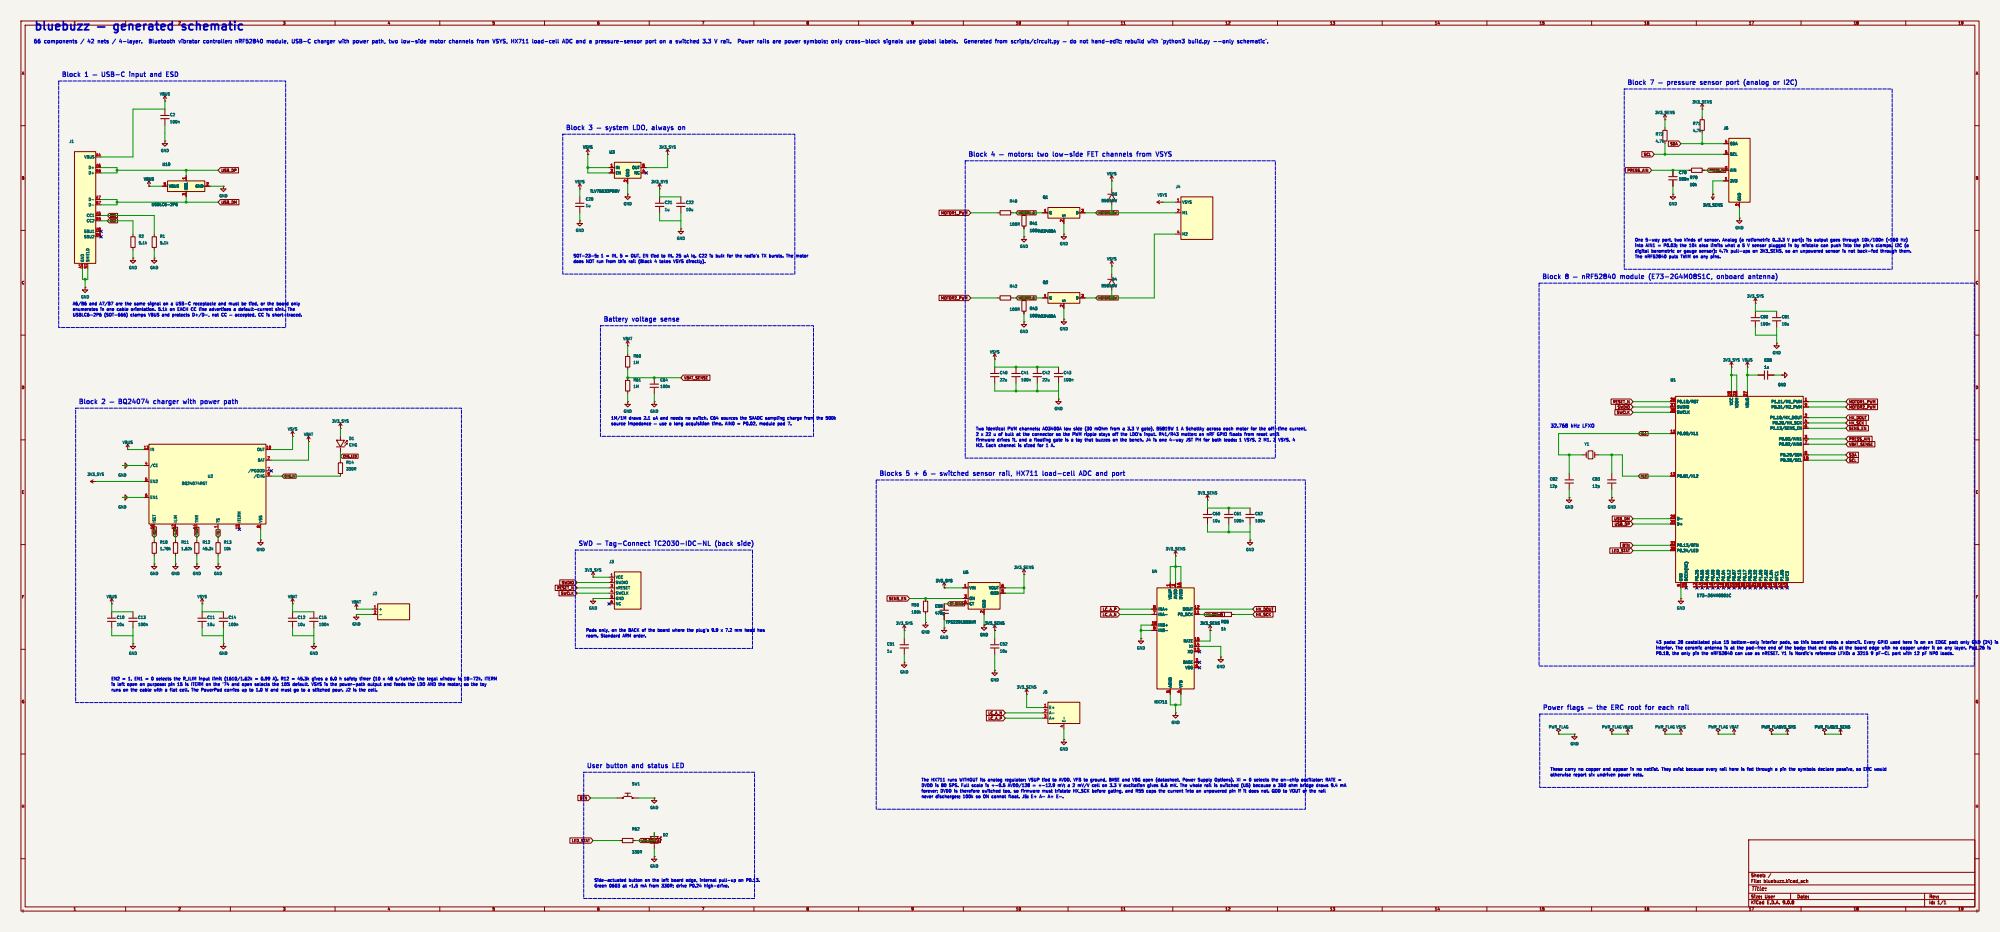
[picture p77: page 1]

bluebuzz þÿ generated schematic

Block 7 þÿ pressure sensor port (analog or I2C) The nRF52840 puts TWIM on any pins.

M2. Each channel is sized for 1 A.
100n GND

nRESET 3 SWCLK 4 GND 5 NC 6

Power flags þÿ the ERC root for each rail
