sequoia-hope/bluebuzz/out/bluebuzz-rm2.kicad_pcb

## KiCad design out/bluebuzz-rm2.kicad_pcb (2026-10-22)

Schematic: bluebuzz-rm2.kicad_sch

Parts:
C2, C13, C14, C15, C41, C43, C64, C82, C88, C89, C91, C92, C93, C94, C95, C96, C97, C98, C101, C102, C120, C121, C122, C123, C130, C132, C133, C140: 100n; C_0402_1005Metric
C10, C11, C12, C22, C52, C100, C131: 10u; C_0603_1608Metric
C20, C21, C51, C85: 1u; C_0603_1608Metric
C40, C42: 22u; C_0603_1608Metric
C50: 470p; C_0402_1005Metric
C80, C83: 4.7u; C_0402_1005Metric_small_pads
C81, C84: 4.7u; C_0402_1005Metric
C86, C87: 15p; C_0402_1005Metric
D1: CHG; LED_0603_1608Metric
D2: XL-1010RGBC; LED_1010_WS2812
D3, D4: B5819W; D_SOD-123
D5: BAT54C; SOT-23
D6: 1N4148WS; D_SOD-323
J1: USB-C; USB_C_Receptacle_HRO_TYPE-C-31-M-12
J2: BAT; PadRow_3x_solder
J3: SWD; PadRow_5x_pogo
J4: MOT; PadRow_3x_solder
J5: TP; PadRow_3x_pogo
J6: PROBE; JST_SH_BM03B-SRSS-TB_1x03-1MP_P1.00mm_Vertical; not fitted
L1: 3.3u; L_pol_2016
Q1, Q2: AO3400A; SOT-23
Q3: 2N7002; SOT-23
R1, R2: 5.1k; R_0402_1005Metric
R3, R4: 27R; R_0402_1005Metric
R10: 1.78k; R_0402_1005Metric
R11: 1.62k; R_0402_1005Metric
R12: 45.3k; R_0402_1005Metric
R13, R81, R88: 10k; R_0402_1005Metric
R14, R62: 330R; R_0402_1005Metric
R40, R42: 100R; R_0402_1005Metric
R41, R43, R130, R131: 4.7k; R_0402_1005Metric
R50, R63, R64, R66: 100k; R_0402_1005Metric
R60, R61: 1M; R_0402_1005Metric
R80: 470R; R_0402_1005Metric
R84: 33R; R_0402_1005Metric
R85: 10R; R_0402_1005Metric
R86, R87: 1k; R_0402_1005Metric
SW1: PWR; Panasonic_EVQPUL_EVQPUC
U1: RP2350A; QFN-60-1EP_7x7mm_P0.4mm_EP3.4x3.4mm_ThermalVias
U2: BQ24074RGT; VQFN-16-1EP_3x3mm_P0.5mm_EP1.6x1.6mm
U3: TLV75533PDBV; SOT-23-5
U5, U11: TPS22918DBVR; SOT-23-6
U6: W25Q32JVUUIQ; Winbond_USON-8-2EP_3x4mm_P0.8mm_EP0.2x0.8mm
U7: RM2
U10: USBLC6-2P6; SOT-666
U20, U21, U22, U23: DPS368; DPS368_LGA-8
U30: LSM6DS3TR-C; LGA-14_3x2.5mm_P0.5mm_LayoutBorder3x4y
U40: MP34DT05-A; MP34DT05_HCLGA-4
Y1: 12MHz; Crystal_SMD_3225-4Pin_3.2x2.5mm

Connections:
1V1: C80.1, C81.1, C82.1, C98.1, J5.3 (1V1), L1.1, U1.6 (DVDD), U1.23 (DVDD), U1.39 (DVDD), U1.50 (VREG_FB)
3V3A: C85.1, R85.2, U1.44 (ADC_AVDD)
3V3_SENS: C52.1, C120.1, C121.1, C122.1, C123.1, U5.5 (QOD), U5.6 (VOUT), U20.6 (VDDIO), U20.8 (VDD), U21.6 (VDDIO), U21.8 (VDD), U22.6 (VDDIO), U22.8 (VDD), U23.6 (VDDIO), U23.8 (VDD)
3V3_SYS: C21.1, C22.1, C51.1, C83.1, C88.1, C91.1, C92.1, C93.1, C94.1, C95.1, C96.1, C97.1, C102.1, C130.1, C131.1, C132.1, C140.1, J5.2 (3V3), R84.1, R85.1, R88.1, R130.1, R131.1, U1.1 (IOVDD), U1.11 (IOVDD), U1.20 (IOVDD), U1.30 (IOVDD), U1.38 (IOVDD), U1.45 (IOVDD), U1.49 (VREG_VIN), U1.53 (USB_OTP_VDD), U1.54 (IOVDD), U3.5 (OUT), U5.1 (VIN), U6.8 (VCC), U7.14 (VDDIO), U11.3 (ON), U30.5 (VDDIO), U30.8 (VDD), U30.12 (CS), U40.1 (VDD)
BOOTSEL: J3.4 (BOOT), R87.2
BTN: Q3.3 (D), U1.12 (GPIO8/BTN)
BTN_RAW: D5.1 (A1), Q3.1 (G), R64.1, SW1.2
CC1: J1.A5 (CC1), R1.1
CC2: J1.B5 (CC2), R2.1
CHG_LED: D1.1 (K), R14.1
CHG_N: R14.2, U2.9 (/CHG)
CT_SENS: C50.1, U5.4 (CT)
GND: C2.2, C10.2, C11.2, C12.2, C13.2, C14.2, C15.2, C20.2, C21.2, C22.2, C40.2, C41.2, C42.2, C43.2, C50.2, C51.2, C52.2, C64.2, C80.2, C81.2, C82.2, C83.2, C84.2, C85.2, C86.2, C87.2, C88.2, C89.2, C91.2, C92.2, C93.2, C94.2, C95.2, C96.2, C97.2, C98.2, C100.2, C101.2, C102.2, C120.2, C121.2, C122.2, C123.2, C130.2, C131.2, C132.2, C133.2, C140.2, D2.3 (GND), J1.A1 (GND), J1.A12 (GND), J1.B1 (GND), J1.B12 (GND), J1.S1 (SHIELD), J2.2 (-), J3.5 (GND), J6.2 (GND), J6.MP, Q1.2 (S), Q2.2 (S), Q3.2 (S), R1.2, R2.2, R10.2, R11.2, R12.2, R13.2, R41.2, R43.2, R50.2, R61.2, R63.2, R64.2, U1.47 (GND), U1.61 (GND), U2.4 (/CE), U2.6 (EN1), U2.8 (VSS), U2.17 (VSS), U3.2 (GND), U5.2 (GND), U6.4 (GND), U7.1 (GND), U7.4 (GND), U7.7 (GND), U7.11 (GND), U7.15 (GND), U7.21 (GND), U10.2 (GND), U11.2 (GND), U20.1 (GND), U20.7 (GND), U21.1 (GND), U21.7 (GND), U22.1 (GND), U22.7 (GND), U23.1 (GND), U23.7 (GND), U30.1 (SA0), U30.2 (SDx), U30.3 (SCx), U30.6 (GND), U30.7 (GND), U40.2 (LR), U40.5 (GND), Y1.2, Y1.4
ILIM: R11.1, U2.12 (ILIM)
IMU_INT1: U1.8 (GPIO5/IMU_INT1), U30.4 (INT1)
IMU_INT2: U1.29 (GPIO18/IMU_INT2), U30.9 (INT2)
ISET: R10.1, U2.16 (ISET)
LDO_EN: D5.3 (K), R63.1, R66.2, U3.3 (EN)
LED_DIN: D2.4 (DI), R62.2
LED_STAT: R62.1, U1.34 (GPIO22/LED)
LED_VDD: C133.1, D2.2 (VDD), U11.5 (QOD), U11.6 (VOUT)
MOTOR1_G: Q1.1 (G), R40.2, R41.1
MOTOR1_PWM: R40.1, U1.17 (GPIO13/M1_PWM)
MOTOR1_SW: D3.2 (A), J4.2 (M1), Q1.3 (D)
MOTOR2_G: Q2.1 (G), R42.2, R43.1
MOTOR2_PWM: R42.1, U1.28 (GPIO17/M2_PWM)
MOTOR2_SW: D4.2 (A), J4.3 (M2), Q2.3 (D)
PDM_CLK: U1.43 (GPIO29/PDM_CLK), U40.3 (CLK)
PDM_DATA: U1.42 (GPIO28/PDM_DATA), U40.4 (DOUT)
PG_N: U1.13 (GPIO9/PG), U2.7 (/PGOOD)
PWR_HOLD: D5.2 (A2), U1.31 (GPIO19/PWR_HOLD)
QSPI_SCLK: U1.56 (QSPI_SCLK), U6.6 (CLK)
QSPI_SD0: U1.57 (QSPI_SD0), U6.5 (DI/IO0)
QSPI_SD1: U1.59 (QSPI_SD1), U6.2 (DO/IO1)
QSPI_SD2: U1.58 (QSPI_SD2), U6.3 (/WP/IO2)
QSPI_SD3: U1.55 (QSPI_SD3), U6.7 (/HOLD/IO3)
QSPI_SS: R87.1, U1.60 (QSPI_SS), U6.1 (/CS)
RUN: C89.1, J3.3 (RUN), R88.2, U1.26 (RUN)
SCL: R131.2, U1.10 (GPIO7/SCL), U30.13 (SCL)
SDA: R130.2, U1.9 (GPIO6/SDA), U30.14 (SDA)
SENS_EN: R50.1, U1.7 (GPIO4/SENS_EN), U5.3 (ON)
SWCLK: J3.2 (SWCLK), J6.1 (SC), U1.24 (SWCLK)
SWDIO: J3.1 (SWDIO), J6.3 (SD), U1.25 (SWDIO)
TAC_CS1: U1.2 (GPIO0/TAC_CS1), U20.2 (CSB)
TAC_CS2: U1.18 (GPIO14/TAC_CS2), U21.2 (CSB)
TAC_CS3: U1.19 (GPIO15/TAC_CS3), U22.2 (CSB)
TAC_CS4: U1.27 (GPIO16/TAC_CS4), U23.2 (CSB)
TAC_SCK: U1.14 (GPIO10/TAC_SCK), U20.4 (SCK), U21.4 (SCK), U22.4 (SCK), U23.4 (SCK)
TAC_SDI: U1.15 (GPIO11/TAC_SDI), U20.3 (SDI), U21.3 (SDI), U22.3 (SDI), U23.3 (SDI)
TAC_SDO: U1.16 (GPIO12/TAC_SDO), U20.5 (SDO), U21.5 (SDO), U22.5 (SDO), U23.5 (SDO)
TMR: R12.1, U2.14 (TMR)
TS: J2.3 (T), R13.1, U2.1 (TS)
USB_DM: J1.A7 (D-), J1.B7 (D-), R4.1, U10.3 (IO2), U10.4 (IO2)
USB_DM_C: R4.2, U1.51 (USB_DM)
USB_DP: J1.A6 (D+), J1.B6 (D+), R3.1, U10.1 (IO1), U10.6 (IO1)
USB_DP_C: R3.2, U1.52 (USB_DP)
VBAT: C12.1, C15.1, J2.1 (+), R60.1, U2.2 (BAT), U2.3 (BAT)
VBAT_SENSE: C64.1, R60.2, R61.1, U1.40 (GPIO26/ADC0)
VBUS: C2.1, C10.1, C13.1, D6.2 (A), J1.A4 (VBUS), J1.A9 (VBUS), J1.B4 (VBUS), J1.B9 (VBUS), U2.13 (IN), U10.5 (VBUS)
VBUS_EN: D6.1 (K), R66.1
VREG_AVDD: C84.1, R84.2, U1.46 (VREG_AVDD)
VREG_LX: L1.2, U1.48 (VREG_LX)
VSYS: C11.1, C14.1, C20.1, C40.1, C41.1, C42.1, C43.1, C100.1, C101.1, D1.2 (A), D3.1 (K), D4.1 (K), J4.1 (VSYS), J5.1 (VSYS), SW1.1, U2.5 (EN2), U2.10 (OUT), U2.11 (OUT), U3.1 (IN), U7.16 (Vin), U11.1 (VIN)
WL_CLK: U1.5 (GPIO3/WL_CLK), U7.3 (SCLK)
WL_CS: U1.37 (GPIO25/WL_CS), U7.9 (CS)
WL_DATA: R80.2, R81.2, U1.4 (GPIO2/WL_DATA), U7.5 (DIN)
WL_DOUT: R80.1, U7.6 (DOUT)
WL_IRQ: R81.1, U7.10 (nIRQ)
WL_ON: U1.41 (GPIO27/WL_ON), U7.12 (WL_ON), U7.13 (WL_ON)
XIN: C86.1, U1.21 (XIN), Y1.1
XOUT: R86.1, U1.22 (XOUT)
XTAL2: C87.1, R86.2, Y1.3

Notes on the sheet:
bluebuzz-rm2 — generated schematic
109 components / 72 nets / 6-layer. Bluetooth-audio vibrator controller: RP2350A + Raspberry Pi RM2 (CYW43439); USB-C, every other lead on back-side pads; BQ24074 charger with power path, a soft power latch (button, GPIO hold, USB), two low-side motor channels, 4 DPS368 barometers on the back (four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
The one connector on the board, on the BOTTOM edge (the top edge is the
RM2's RF keep-out). A6/B6 and A7/B7 are tied or the board enumerates in
one cable orientation only; 5.1k on each CC. The USBLC6-2P6 clamps VBUS
and protects D+/D-; 27 R in each line at the RP2350 is the reference
design's.
1 — USB-C and ESD
EN2 = 1, EN1 = 0: the R_ILIM input limit (0.99 A). 45.3k = 6 h safety timer. ITERM open = 10% default. VSYS
is the power-path output and feeds the LDO, both motors AND the RM2 (Vin 3.0-4.8 V). /PGOOD goes to GPIO9:
the RP2350 has no VBUS detect of its own. J2: solder pads on the back for the cell: + - T. T is TS for a
cell with a 10 k NTC; fit it and leave R13 off. Without an NTC R13 holds TS mid-window (always charging).
2 — BQ24074 charger with power path
500 mA, 25 uA Iq. Feeds the RP2350, the flash, the sensors, the IMU
and the RM2's VDDIO; off (EN low) is the system's off state. The
motors and the RM2's Vin take VSYS directly.
4 — 3.3 V LDO, enabled by the power latch
1M/1M, 2.1 uA, into ADC0 (GPIO26). C64 feeds the ADC's
sampling charge; the RP2350's ADC input is 500 ohm-ish during
a sample, so oversample.
3 — battery voltage sense
Five 1.6 x 2.2 mm ENIG pads at 2.0 mm pitch for a
pogo clip: SWDIO SWCLK RUN BOOT GND. Bridge BOOT
to GND while applying power for the UF2
bootloader; SWD is for debugging only. J5: three
test pads (VSYS, 3V3, 1V1) for bring-up, GND on
the SWD row. J6: the Raspberry Pi Debug Probe's
3-pin JST-SH (1 SC, 2 GND, 3 SD), footprint only
(DNP), on the back.
6 — SWD / boot pads, test pads, debug-probe connector (back)
Press SW1: VSYS reaches the LDO's EN through D5 and 3V3 comes up; the
RP2350 boots and drives PWR_HOLD (GPIO19) high, so the board stays on
after release. Firmware reads the button on GPIO8 (Q3, active low,
internal pull-up) and switches off by driving PWR_HOLD low. R63 holds
EN off; R64 discharges the gate. USB in (VBUS through D6 and R66) also
holds EN on, so flashing and SWD need no button. Charging runs while
off. Status: a 1010 addressable RGB LED (WS2812B type) on GPIO22
through 330 R; its VSYS supply goes through U11 (a second TPS22918, ON
= 3V3_SYS), so it draws nothing while the system is off.
7 — power button (soft latch) and status LED
Two identical PWM channels (GPIO13, GPIO17): AO3400A low side, B5819W 1 A Schottky across
each motor, 2 x 22 u of bulk at the pads. R41/R43 hold the gates down until firmware runs.
J4 is three solder pads on the back: VSYS M1 M2 -- the two motors share the supply pad.
Each channel is sized for 1 A.
13 — motors: two low-side FET channels from VSYS
The switched 3.3 V rail for the tactile array (block 6): the sensors draw
little, but gating them lets firmware power-cycle the array and keeps the
rail off in sleep.
5 — switched sensor rail
Four Infineon DPS368s on the BACK of the board in a diamond pattern (North U20, East U21, West
U22, South U23), cast in soft elastomer after Tenzer, Jentoft & Howe 2014 (The Feel of MEMS
Barometers): rubber poured over the array and pressure-cast (not vacuum: DPS368 p.43) so it fills
the ports; a load on the surface then reads as pressure. CSB low at power-up puts each sensor in
SPI mode; SPI1 on GPIO10-12, one chip select each on GPIO0 and GPIO14-16. 100n at every sensor.
11 — tactile array: DPS368 barometers on SPI1, cast in elastomer
ST MP34DT05TR-A top-port digital PDM MEMS microphone (3 x 4 x 1 mm HCLGA-4, 64 dB
SNR, 122.5 dBSPL AOP) on the always-on 3.3 V rail. LR tied to GND selects the
left-channel slot; CLK on GPIO29, DOUT on GPIO28 (PIO PDM state machine). Top
acoustic port needs no PCB hole.
14 — PDM MEMS microphone: MP34DT05-A (top-port)
ST LSM6DS3TR-C six-axis IMU on I2C1 (GPIO6/7, 4.7k pull-ups to the always-on rail): CS high
selects I2C, SA0 low gives address 0x6A; the aux I2C (SDx/SCx) is unused and tied to GND.
INT1/INT2 to GPIO5/18 for wake-on-motion, tap and tilt. 100n + 10u on VDD, 100n on VDDIO.
12 — IMU: LSM6DS3TR-C on I2C1, always on
12 MHz
100 n each at IOVDD 1, 11, 20, 30, 38, 45 and 54/53; C83 4.7 u at VREG_VIN 49
C80 4.7 u at L1, C81 4.7 u at DVDD 23, C82 / C98 100 n at DVDD 39 / 6
Raspberry Pi's RP2350A minimal design: 3.3 uH on VREG_LX with 4.7 u at the output and at DVDD, 100 n at the
third DVDD, 4.7 u on VREG_VIN, VREG_AVDD through 33 R + 4.7 u, ADC_AVDD through 10 R + 1 u, 27 R in each
USB line, 12 MHz crystal with 1 k in series with XOUT, the reference's ABM8-272-T3 (CL 10 pF) with its 15
pF loads. The radio's gSPI is on GPIO2/3/23/25 (the board file overrides the SDK's data and clock pins).
9 — RP2350A: core regulator, clock, USB, decoupling
W25Q32JVUUIQ, 3 x 4 mm USON (the 2 x 3 16 Mbit part had no stock).
QSPI_SS doubles as BOOTSEL: pull it low through the BOOT pad while
power comes up and the RP2350 enumerates as a UF2 drive. RUN has the
reference's 10k/100n and its own pad.
8 — QSPI flash, reset and boot
RMC20452T: Wi-Fi 4 + Bluetooth 5.2 Classic/LE, PCB antenna, modular certification. Vin 3.0-4.8 V from
VSYS (271 mA TX peaks stay off the LDO), VDDIO 3V3. gSPI: GPIO3 clock, GPIO2 data (DIN direct, DOUT via
470 R, nIRQ via 10 k), GPIO25 CS, GPIO27 WL_ON on pads 12 and 13 (WL_REG_ON and BT_REG_ON). The
datasheet's RF keep-out -- 5 mm into the body, 10.5 mm either side, 13.5 mm beyond -- is a rule area on
every layer; the module's antenna end is the board edge.
10 — Raspberry Pi Radio Module 2 (CYW43439)
No copper, no netlist entry: every rail is fed through a pin the symbols declare passive, so ERC
needs a driver per rail.
Power flags — the ERC root for each rail

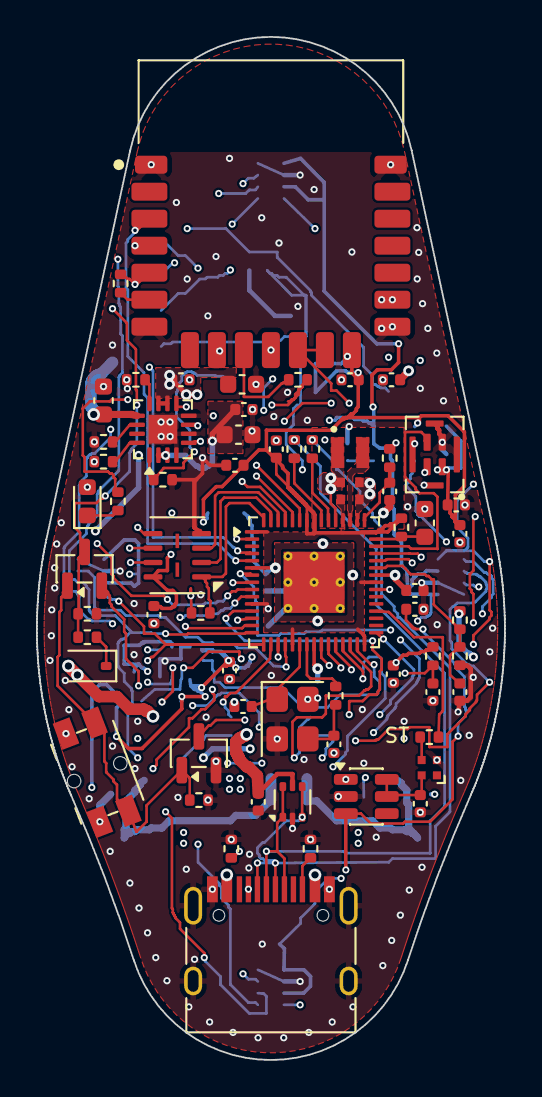
[picture p78: board bluebuzz-rm2.kicad_pcb from above]

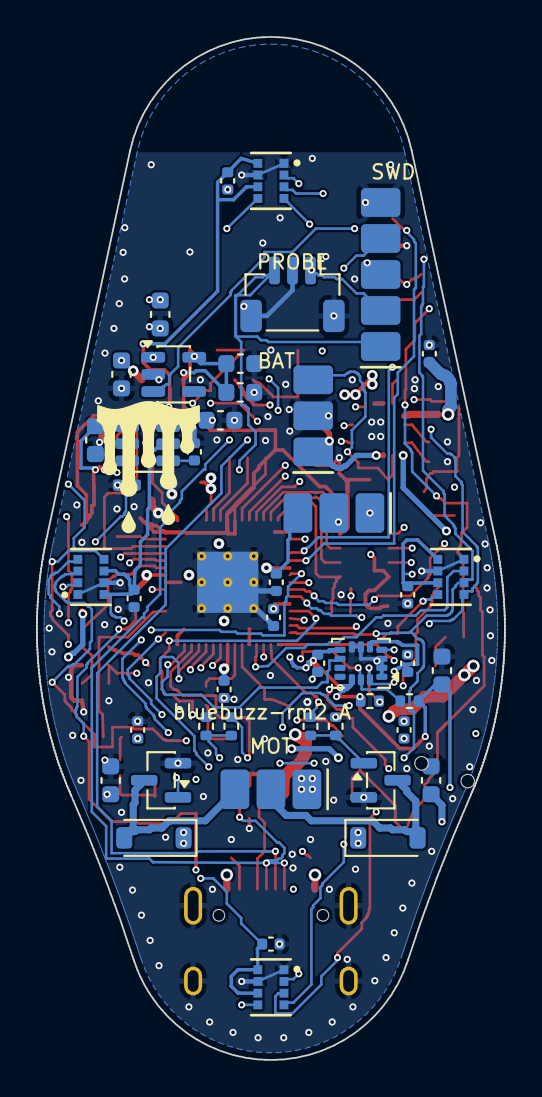
[picture p79: board bluebuzz-rm2.kicad_pcb from below]

Board: 6 copper layers, 26.0 x 56.8 mm, 109 parts (45 on the bottom side), 72 nets.
