sequoia-hope/bluebuzz/scripts/finish.py

#!/usr/bin/env python3
"""Close the last unconnected hops with a real path search.

close_gaps draws a straight line or one L on a single layer, and on this
board the survivors are precisely the hops that need more: a bend or two,
a layer change, a via placed where there is room for one. This stage is a
tiny grid router for exactly those. It reads KiCad's DRC unconnected
list, then for each pair runs A* over a 0.1 mm lattice on the three
signal layers (F.Cu, In2.Cu, B.Cu), with layer changes through 0.4/0.2
vias. What it draws is locked, so the routing stages keep it.

Obstacles are modelled the hard way, as RECTANGLES for pads: the shared
`Obstacles` bounding-circle model is fine for close_gaps' straight shots
through open space, but an A* path hugs the blocked boundary by
construction, and a circle of radius max(w,h)/2 misses the corners of
every non-square pad -- the first version of this stage put a via in the
exposed pad's corner and shorted the motor line to ground. Rectangle
masks are exact, so a found path is a legal path.

Endpoints on a plane layer (a stranded fragment `relayer` parked on In3)
are deleted and the search retargeted at the net's nearest copper on a
usable layer.

Run as a build stage between `close` and `drc`.
"""
import json
import math
import shutil
import subprocess
import sys
from heapq import heappush, heappop
from pathlib import Path

import pcbnew

sys.path.insert(0, str(Path(__file__).resolve().parent))
from circuit import load_design  # noqa: E402
from route import CX, CY, Router, rel, smd_layer, to_mm  # noqa: E402
from close_gaps import REPORT, drc_unconnected, index_board  # noqa: E402

ROOT = Path(__file__).resolve().parent.parent
PCB = ROOT / "out" / "bluebuzz-rm2.kicad_pcb"


def class_width(netname, design):
    """Track width for a net from the project's netclass patterns (gen_project):
    power nets get 0.4 mm, everything else the default."""
    import fnmatch
    from gen_project import DEFAULT
    if netname == "GND":
        # GND current rides the planes and pours; a finishing GND wire is a
        # short pad-to-copper hop, and at the Power class's 0.4 mm it sat
        # 0.1 mm from the IMU's 3V3 pad between two 0.5 mm-pitch GND pins
        return 0.25
    ns = DEFAULT["net_settings"]
    classes = {c["name"]: c["track_width"] for c in ns["classes"]}
    for pat in ns["netclass_patterns"]:
        if fnmatch.fnmatchcase(netname, pat["pattern"]):
            return classes[pat["netclass"]]
    return design["jlcpcb"]["default_track_mm"]


def set_width(w):
    """The masks and the drawn wire follow the net's class width."""
    global TRACK_W, HALF, W_GAP
    TRACK_W = w
    HALF = w / 2
    W_GAP = CLEAR + HALF


def set_via(netname):
    """...and the drawn via the class's own (a 0.4/0.2 via on VBUS was the
    single 0.53 A neck of every routed VBUS path, 2026-10-19)."""
    import fnmatch
    from gen_project import DEFAULT
    global VIA_D, VIA_DR, V_GAP
    ns = DEFAULT["net_settings"]
    cls = {c["name"]: c for c in ns["classes"]}
    c = cls["Default"]
    for pat in ns["netclass_patterns"]:
        if fnmatch.fnmatchcase(netname, pat["pattern"]):
            c = cls[pat["netclass"]]
            break
    VIA_D, VIA_DR = c["via_diameter"], c["via_drill"]
    V_GAP = VIA_D / 2 + CLEAR


def class_clearance():
    """The largest netclass clearance, plus a hair for the lattice. KiCad
    applies the LARGER of two nets' clearances, so a wire kept this far
    from everything is legal against every class. (This was a flat 0.2
    for a USB class that has since gone to 0.127; the extra 0.073 mm shut
    the last few gaps around the RP2350, 2026-10-18.) The 0.01 covers a
    straight move between two free lattice points bowing into a disk."""
    from gen_project import DEFAULT
    return max(c["clearance"] for c in DEFAULT["net_settings"]["classes"]) + 0.01

STEP = 0.1
LAYERS = None            # filled in main() from the stackup
VIA_COST = 18            # in grid steps: a via is worth ~1.8 mm of detour
TRACK_W = 0.15
HALF = TRACK_W / 2
CLEAR = class_clearance()
W_GAP = CLEAR + HALF     # copper margin for a new wire, from the item edge
VIA_D, VIA_DR = 0.4, 0.2  # the net's class via (set_via)
V_GAP = 0.2 + CLEAR      # copper margin for a new via's centre (0.4 via)


def grid_of(design, step=STEP):
    """The whole board, inset 0.35 mm (the antenna keepout and the other
    rule areas are masked by build_masks)."""
    b = design["board"]
    hw, hh = b["width_mm"] / 2, b["height_mm"] / 2
    x0, x1 = -hw + 0.35, hw - 0.35
    if b.get("outline") == "squish":
        from squish_outline import generate_outline_points_pcb
        _, info = generate_outline_points_pcb(
            r_tip=float(b.get("r_tip_mm", 10.0)),
            top_y_pcb=float(b.get("top_y_mm", -22.0)),
            offset_mm=float(b.get("offset_mm", 0.0)),
        )
        y0, y1 = info["y_top_pcb"] + 0.35, info["y_bot_pcb"] - 0.35
    else:
        y0, y1 = -hh + 0.35, hh - 0.35
    nx = int((x1 - x0) / step) + 1
    ny = int((y1 - y0) / step) + 1
    return x0, y0, nx, ny, step


def build_masks(board, design, netcode, grid, soft=False):
    """blocked[layer_index] and via_blocked, as sets of (ix, iy). `soft`
    leaves out the unlocked wires and vias of other nets (the rip-up
    search: rip_up)."""
    x0, y0, nx, ny, STEP = grid
    b = design["board"]
    hw, hh = b["width_mm"] / 2, b["height_mm"] / 2
    blocked = [set() for _ in LAYERS]
    via_blocked = set()
    lidx = {ly: k for k, ly in enumerate(LAYERS)}

    def mark_rect(target, rx0, ry0, rx1, ry1):
        i0 = max(0, math.ceil((rx0 - x0) / STEP - 1e-9))
        i1 = min(nx - 1, math.floor((rx1 - x0) / STEP + 1e-9))
        j0 = max(0, math.ceil((ry0 - y0) / STEP - 1e-9))
        j1 = min(ny - 1, math.floor((ry1 - y0) / STEP + 1e-9))
        for i in range(i0, i1 + 1):
            for j in range(j0, j1 + 1):
                target.add((i, j))

    def mark_disk(target, cx, cy, r):
        i0 = max(0, int((cx - r - x0) / STEP))
        i1 = min(nx - 1, int((cx + r - x0) / STEP) + 1)
        j0 = max(0, int((cy - r - y0) / STEP))
        j1 = min(ny - 1, int((cy + r - y0) / STEP) + 1)
        r2 = r * r
        for i in range(i0, i1 + 1):
            dx = x0 + i * STEP - cx
            for j in range(j0, j1 + 1):
                dy = y0 + j * STEP - cy
                if dx * dx + dy * dy <= r2:
                    target.add((i, j))

    # pads: exact rectangles, per layer for SMD, everywhere for through
    for fp in board.GetFootprints():
        for pd in fp.Pads():
            if pd.GetNetCode() == netcode:
                continue
            bb = pd.GetBoundingBox()
            px0, py0 = to_mm(bb.GetLeft()) - CX, to_mm(bb.GetTop()) - CY
            px1, py1 = to_mm(bb.GetRight()) - CX, to_mm(bb.GetBottom()) - CY
            lc = pd.GetLocalClearance()
            extra = max(0.0, to_mm(int(lc)) - 0.127) if lc else 0.0
            w = W_GAP + extra
            if pd.GetAttribute() == pcbnew.PAD_ATTRIB_SMD:
                targets = [lidx[smd_layer(pd)]] \
                    if smd_layer(pd) in lidx else []
            else:
                targets = list(range(len(LAYERS)))
            for li in targets:
                mark_rect(blocked[li], px0 - w, py0 - w, px1 + w, py1 + w)
            v = V_GAP + extra
            mark_rect(via_blocked, px0 - v, py0 - v, px1 + v, py1 + v)
            if pd.HasHole():
                # hole to copper 0.2 mm on every layer: an NPTH peg's pad
                # box is smaller than its hole (a TAC_CS2 wire 0.15 mm from
                # J1's peg, 2026-10-19)
                hx, hy = rel(pd.GetPosition())
                hr = max(to_mm(pd.GetDrillSize().x), to_mm(pd.GetDrillSize().y)) / 2
                for bl in blocked:
                    mark_disk(bl, hx, hy, hr + 0.2 + HALF + 0.01)
                mark_disk(via_blocked, hx, hy, hr + 0.2 + VIA_D / 2 + 0.01)

    # tracks and vias: sampled disks (they are thin; circles are honest)
    for t in board.GetTracks():
        same = t.GetNetCode() == netcode
        if soft and not same and not t.IsLocked():
            continue
        if isinstance(t, pcbnew.PCB_VIA):
            vx, vy = rel(t.GetPosition())
            rv = to_mm(t.GetWidth(pcbnew.F_Cu)) / 2     # 0.2, or 0.3 on a Power via
            rd = to_mm(t.GetDrillValue()) / 2
            if not same:
                for bl in blocked:
                    mark_disk(bl, vx, vy, rv + W_GAP)
            # hole-to-hole (0.2) applies to SAME-net vias too; other nets
            # need full copper clearance from this via's rim to ours
            mark_disk(via_blocked, vx, vy,
                      max(rd + VIA_DR / 2 + 0.2, VIA_D / 2 + 0.25) if same else rv + V_GAP)
            continue
        if same:
            continue
        a, b2 = rel(t.GetStart()), rel(t.GetEnd())
        hw2 = to_mm(t.GetWidth()) / 2
        L = math.hypot(b2[0] - a[0], b2[1] - a[1])
        n = max(1, int(L / (STEP / 2)))
        ly = t.GetLayer()
        li = lidx.get(ly)
        for k in range(n + 1):
            sx = a[0] + (b2[0] - a[0]) * k / n
            sy = a[1] + (b2[1] - a[1]) * k / n
            if li is not None:
                mark_disk(blocked[li], sx, sy, hw2 + W_GAP)
            mark_disk(via_blocked, sx, sy, hw2 + V_GAP)

    # the RP2350's power block (rp2350_block.py): its zones are planes the
    # router must not cut, and no zone is in the masks otherwise. Their
    # outlines' boxes, for every other net, on their own layer.
    for z in board.Zones():
        if z.GetIsRuleArea() or not z.GetZoneName().startswith(("rp2350_", "pwr_")) \
                or z.GetLayer() not in lidx:
            continue
        if z.GetNetCode() == netcode and z.GetNetname() != "GND":
            continue                     # its own net may join it -- but not
                                         # GND the PGND zone: one return point
        bb = z.GetBoundingBox()
        mark_rect(blocked[lidx[z.GetLayer()]],
                  to_mm(bb.GetLeft()) - CX - W_GAP, to_mm(bb.GetTop()) - CY - W_GAP,
                  to_mm(bb.GetRight()) - CX + W_GAP, to_mm(bb.GetBottom()) - CY + W_GAP)
        # and no through via of another net in them (a TAC_CS2 via under the
        # chip split the 3V3 band, 2026-10-18)
        mark_rect(via_blocked,
                  to_mm(bb.GetLeft()) - CX - V_GAP, to_mm(bb.GetTop()) - CY - V_GAP,
                  to_mm(bb.GetRight()) - CX + V_GAP, to_mm(bb.GetBottom()) - CY + V_GAP)

    # rule areas (all rectangles on this board)
    for z in board.Zones():
        if not z.GetIsRuleArea():
            continue
        bb = z.GetBoundingBox()
        bx0, by0 = to_mm(bb.GetLeft()) - CX, to_mm(bb.GetTop()) - CY
        bx1, by1 = to_mm(bb.GetRight()) - CX, to_mm(bb.GetBottom()) - CY
        if z.GetDoNotAllowTracks():
            for ly in z.GetLayerSet().Seq():
                if ly in lidx:
                    mark_rect(blocked[lidx[ly]], bx0 - HALF, by0 - HALF,
                              bx1 + HALF, by1 + HALF)
        if z.GetDoNotAllowVias():
            mark_rect(via_blocked, bx0 - VIA_D / 2 - 0.025, by0 - VIA_D / 2 - 0.025,
                      bx1 + VIA_D / 2 + 0.025, by1 + VIA_D / 2 + 0.025)

    # a via wants 0.2 copper-to-edge on its 0.45 annulus: keep centres
    # 0.45 in from every edge (the wire grid is already inset 0.35)
    ol_poly = pcbnew.SHAPE_POLY_SET()
    board.GetBoardPolygonOutlines(ol_poly)
    via_poly = pcbnew.SHAPE_POLY_SET(ol_poly)
    via_poly.Inflate(-pcbnew.FromMM(VIA_D / 2 + 0.28), pcbnew.CORNER_STRATEGY_ROUND_ALL_CORNERS, pcbnew.FromMM(0.01))
    wire_poly = pcbnew.SHAPE_POLY_SET(ol_poly)
    wire_poly.Inflate(-pcbnew.FromMM(0.25 + HALF), pcbnew.CORNER_STRATEGY_ROUND_ALL_CORNERS, pcbnew.FromMM(0.01))
    for i in range(nx):
        for j in range(ny):
            x, y = x0 + i * STEP, y0 + j * STEP
            pt = pcbnew.VECTOR2I(pcbnew.FromMM(CX + x), pcbnew.FromMM(CY + y))
            if not via_poly.Contains(pt):
                via_blocked.add((i, j))
            if not wire_poly.Contains(pt):
                for bl in blocked:
                    bl.add((i, j))

    # the net's class may be held to some layers (gen_project.LAYER_RULES:
    # the motor switch nodes to F.Cu, VBUS to the outer layers); with one
    # layer left it may not change layer at all
    allowed = class_layers(board.FindNet(netcode).GetNetname() if netcode else "")
    if allowed is not None:
        every = {(i, j) for i in range(nx) for j in range(ny)}
        for ly, li in lidx.items():
            if pcbnew.LayerName(ly) not in allowed:
                blocked[li] |= every
        if len(allowed) < 2:
            via_blocked |= every
    return blocked, via_blocked


def class_layers(netname):
    """The layers netname's class may use (gen_project.LAYER_RULES), or None."""
    import fnmatch
    from gen_project import DEFAULT, LAYER_RULES
    for pat in DEFAULT["net_settings"]["netclass_patterns"]:
        if fnmatch.fnmatchcase(netname, pat["pattern"]):
            return LAYER_RULES.get(pat["netclass"])
    return None


def free_anchor(pos, blocked_l, grid):
    """The anchor cell, or the nearest free cell within ~3 cells."""
    x0, y0, nx, ny, STEP = grid
    i = round((pos[0] - x0) / STEP)
    j = round((pos[1] - y0) / STEP)
    best = None
    for di in range(-3, 4):
        for dj in range(-3, 4):
            c = (i + di, j + dj)
            if not (0 <= c[0] < nx and 0 <= c[1] < ny):
                continue
            if c in blocked_l:
                continue
            d = di * di + dj * dj
            if best is None or d < best[0]:
                best = (d, c)
    return best[1] if best else None


def astar(starts, goals, blocked, via_blocked, grid):
    x0, y0, nx, ny, _step = grid
    goalset = set(goals)
    gx = sum(g[0][0] for g in goals) / len(goals)
    gy = sum(g[0][1] for g in goals) / len(goals)

    def h(c):
        dx, dy = abs(c[0][0] - gx), abs(c[0][1] - gy)
        return max(dx, dy) + 0.41421356 * min(dx, dy)      # octile: admissible for 45-degree moves

    openq = []
    came = {}
    dist = {}
    for s in starts:
        dist[s] = 0
        heappush(openq, (h(s), 0, s))
    seen = set()
    expansions = 0
    while openq:
        _, d, cur = heappop(openq)
        if cur in seen:
            continue
        seen.add(cur)
        expansions += 1
        if expansions > 6000000:
            return None
        if cur in goalset:
            path = [cur]
            while cur in came:
                cur = came[cur]
                path.append(cur)
            return path[::-1]
        (ci, cj), cl = cur
        for di, dj in ((1, 0), (-1, 0), (0, 1), (0, -1), (1, 1), (1, -1), (-1, 1), (-1, -1)):
            ni, nj = ci + di, cj + dj
            if not (0 <= ni < nx and 0 <= nj < ny):
                continue
            nxt = ((ni, nj), cl)
            if (ni, nj) in blocked[cl] or nxt in seen:
                continue
            if di and dj and ((ci + di, cj) in blocked[cl] or (ci, cj + dj) in blocked[cl]):
                continue                     # a diagonal step may not cut a blocked corner
            nd = d + (1.41421356 if di and dj else 1)
            if nd < dist.get(nxt, 1 << 30):
                dist[nxt] = nd
                came[nxt] = cur
                heappush(openq, (nd + h(nxt), nd, nxt))
        if (ci, cj) not in via_blocked:
            for nl in range(len(LAYERS)):
                if nl == cl:
                    continue
                nxt = ((ci, cj), nl)
                if (ci, cj) in blocked[nl] or nxt in seen:
                    continue
                nd = d + VIA_COST
                if nd < dist.get(nxt, 1 << 30):
                    dist[nxt] = nd
                    came[nxt] = cur
                    heappush(openq, (nd + h(nxt), nd, nxt))
    return None


def sight(a, b, bl):
    """True when the straight run a -> b is 0/45/90 degrees and every
    lattice point on it is free (a diagonal may not cut a blocked corner,
    as in astar)."""
    dx, dy = b[0] - a[0], b[1] - a[1]
    if dx and dy and abs(dx) != abs(dy):
        return False
    sx, sy = (dx > 0) - (dx < 0), (dy > 0) - (dy < 0)
    for t in range(1, max(abs(dx), abs(dy)) + 1):
        c = (a[0] + sx * t, a[1] + sy * t)
        if c in bl:
            return False
        if sx and sy and ((c[0] - sx, c[1]) in bl or (c[0], c[1] - sy) in bl):
            return False
    return True


def straighten(path, blocked):
    """Pull the A* staircase tight. Octile ties on a fine lattice give
    runs of 0.05 mm zig-zags; on each same-layer run, jump to the farthest
    cell in clear 45-degree sight. Layer changes are kept as they are."""
    out = [path[0]]
    k = 0
    while k < len(path) - 1:
        if path[k + 1][1] != path[k][1]:
            k += 1
            out.append(path[k])
            continue
        ly = path[k][1]
        end = k
        while end + 1 < len(path) and path[end + 1][1] == ly:
            end += 1
        j = k + 1
        for m in range(end, k + 1, -1):
            if sight(path[k][0], path[m][0], blocked[ly]):
                j = m
                break
        out.append(path[j])
        k = j
    return out


def polyline(path, grid, true_start, true_goal, blocked=None):
    """The wires (layer index, a, b) and via points draw() would lay."""
    x0, y0, _, _, STEP = grid
    if blocked is not None:
        path = straighten(path, blocked)

    def heading(a, b):
        dx, dy = b[0][0] - a[0][0], b[0][1] - a[0][1]
        n = max(abs(dx), abs(dy)) or 1
        return (dx / n, dy / n)
    nodes = [path[0]]
    for k in range(1, len(path) - 1):
        a, b, c = path[k - 1], path[k], path[k + 1]
        if heading(a, b) != heading(b, c) or a[1] != b[1] or b[1] != c[1]:
            nodes.append(b)
    nodes.append(path[-1])
    pts = [(x0 + n[0][0] * STEP, y0 + n[0][1] * STEP) for n in nodes]
    if true_start is not None:
        pts[0] = true_start
    if true_goal is not None:
        pts[-1] = true_goal
    wires, vias = [], []
    for k in range(len(nodes) - 1):
        if nodes[k][1] != nodes[k + 1][1]:
            vias.append(pts[k])
        elif pts[k] != pts[k + 1]:
            wires.append((nodes[k][1], pts[k], pts[k + 1]))
    return wires, vias


def rip_up(board, design, nc, ends, grid):
    """For a pair with no path: search again with the other nets' unlocked
    wires and vias left out, and delete the ones that path would cross
    (rip(), with what then dangles), so the path can be laid; the ripped
    nets come back as open pairs in the next round. Returns the items in
    the way, or None when even that finds no path."""
    from route import seg_dist
    sb, svb = build_masks(board, design, nc, grid, soft=True)
    (p1, l1), (p2, l2) = ends
    starts = [(c, li) for li in l1 if (c := free_anchor(p1, sb[li], grid)) is not None]
    goals = [(c, li) for li in l2 if (c := free_anchor(p2, sb[li], grid)) is not None]
    if not starts or not goals:
        return None
    path = astar(starts, goals, sb, svb, grid)
    if path is None:
        return None
    wires, vias = polyline(path, grid, p1, p2, sb)
    hit = []
    for t in board.GetTracks():
        if t.GetNetCode() == nc or t.IsLocked():
            continue
        if t.Type() == pcbnew.PCB_VIA_T:
            c = rel(t.GetPosition())
            r = to_mm(t.GetWidth(pcbnew.F_Cu)) / 2
            if any(seg_dist(a, b, c, c) < r + HALF + CLEAR + 0.02 for _li, a, b in wires) or \
                    any(math.hypot(v[0] - c[0], v[1] - c[1]) < r + VIA_D / 2 + CLEAR + 0.02 for v in vias):
                hit.append(t)
            continue
        a2, b2 = rel(t.GetStart()), rel(t.GetEnd())
        w2 = to_mm(t.GetWidth()) / 2
        if any(LAYERS[li] == t.GetLayer() and seg_dist(a, b, a2, b2) < w2 + HALF + CLEAR + 0.02
               for li, a, b in wires) or \
                any(seg_dist(v, v, a2, b2) < w2 + VIA_D / 2 + CLEAR + 0.02 for v in vias):
            hit.append(t)
    return hit


def net_class(netname):
    """The net's class in design/nets.csv (SIGNAL, CLOCK, POWER ...)."""
    import csv
    global _NET_CLASSES
    if "_NET_CLASSES" not in globals():
        with open(ROOT / "design" / "nets.csv") as f:
            _NET_CLASSES = {r["net"]: r["class"] for r in csv.DictReader(f)}
    return _NET_CLASSES.get(netname, "")


def rip(board, hit):
    """Delete what rip_up found in the way, and what then dangles."""
    from route import prune_dangling
    for t in hit:
        board.Delete(t)
    prune_dangling(board)


def draw(rt, path, netname, grid, true_start, true_goal, blocked=None):
    x0, y0, _, _, STEP = grid

    def pt(cell):
        return (x0 + cell[0][0] * STEP, y0 + cell[0][1] * STEP)

    if blocked is not None:
        path = straighten(path, blocked)

    def heading(a, b):
        dx, dy = b[0][0] - a[0][0], b[0][1] - a[0][1]
        n = max(abs(dx), abs(dy)) or 1
        return (dx / n, dy / n)

    nodes = [path[0]]
    for k in range(1, len(path) - 1):
        a, b, c = path[k - 1], path[k], path[k + 1]
        turn = heading(a, b) != heading(b, c)
        if turn or a[1] != b[1] or b[1] != c[1]:
            nodes.append(b)
    nodes.append(path[-1])
    pts = [pt(n) for n in nodes]
    if true_start is not None:
        pts[0] = true_start
    if true_goal is not None:
        pts[-1] = true_goal
    vias = 0
    for k in range(len(nodes) - 1):
        a, b = nodes[k], nodes[k + 1]
        if a[1] != b[1]:
            rt.via(pts[k], netname, size=VIA_D, drill=VIA_DR)
            vias += 1
            continue
        if pts[k] == pts[k + 1]:
            continue
        rt.track(pts[k], pts[k + 1], netname, layer=LAYERS[a[1]],
                 width=TRACK_W)
    return vias


def endpoint(kind, obj, toward):
    lidx = {ly: k for k, ly in enumerate(LAYERS)}
    if kind == "pad":
        pos = rel(obj.GetPosition())
        if obj.GetAttribute() == pcbnew.PAD_ATTRIB_SMD:
            ls = [lidx[smd_layer(obj)]] if smd_layer(obj) in lidx else []
        else:
            ls = list(range(len(LAYERS)))
        return pos, ls
    if kind == "via":
        return rel(obj.GetPosition()), list(range(len(LAYERS)))
    a, b = rel(obj.GetStart()), rel(obj.GetEnd())
    da = math.hypot(a[0] - toward[0], a[1] - toward[1])
    db = math.hypot(b[0] - toward[0], b[1] - toward[1])
    ly = obj.GetLayer()
    return (a if da <= db else b), ([lidx[ly]] if ly in lidx else [])


def retarget(board, netcode, near):
    """The net's nearest joinable copper on a usable layer: a pad centre,
    a via, or a track end. For endpoints stranded on a plane layer."""
    lidx = {ly: k for k, ly in enumerate(LAYERS)}
    best = None

    def offer(pos, ls):
        nonlocal best
        d = math.hypot(pos[0] - near[0], pos[1] - near[1])
        if d < 0.2:
            return                     # that is the stranded thing itself
        if best is None or d < best[0]:
            best = (d, pos, ls)

    for fp in board.GetFootprints():
        for pd in fp.Pads():
            if pd.GetNetCode() != netcode:
                continue
            if pd.GetAttribute() == pcbnew.PAD_ATTRIB_SMD:
                if smd_layer(pd) in lidx:
                    offer(rel(pd.GetPosition()), [lidx[smd_layer(pd)]])
            else:
                offer(rel(pd.GetPosition()), list(range(len(LAYERS))))
    for t in board.GetTracks():
        if t.GetNetCode() != netcode:
            continue
        if isinstance(t, pcbnew.PCB_VIA):
            offer(rel(t.GetPosition()), list(range(len(LAYERS))))
        elif t.GetLayer() in lidx:
            li = [lidx[t.GetLayer()]]
            offer(rel(t.GetStart()), li)
            offer(rel(t.GetEnd()), li)
    return (best[1], best[2]) if best else (None, None)


def anchors_near(board, netcode, near, k=4, radius=4.0, within=None):
    """Up to k of the net's nearest other copper anchors: pad centres,
    vias, track ends. For retrying an entombed endpoint -- an In2 stub
    parked inside the optical via ban cannot reach any other layer,
    even though the net's own barrel sits a millimetre away with every
    layer open. (An alternate may belong to the far island, in which
    case the drawn copper merely parallels existing net copper; the
    next round's DRC is the arbiter either way.)"""
    lidx = {ly: kk for kk, ly in enumerate(LAYERS)}
    cands = []

    def offer(pos, ls, item):
        if within is not None and item.m_Uuid.AsString() not in within:
            return
        d = math.hypot(pos[0] - near[0], pos[1] - near[1])
        if 0.05 < d <= radius:
            cands.append((d, pos, ls, item))

    for fp in board.GetFootprints():
        for pd in fp.Pads():
            if pd.GetNetCode() != netcode:
                continue
            if pd.GetAttribute() == pcbnew.PAD_ATTRIB_SMD:
                if smd_layer(pd) in lidx:
                    offer(rel(pd.GetPosition()), [lidx[smd_layer(pd)]], pd)
            else:
                offer(rel(pd.GetPosition()), list(range(len(LAYERS))), pd)
    for t in board.GetTracks():
        if t.GetNetCode() != netcode:
            continue
        if isinstance(t, pcbnew.PCB_VIA):
            offer(rel(t.GetPosition()), list(range(len(LAYERS))), t)
        elif t.GetLayer() in lidx:
            li = [lidx[t.GetLayer()]]
            offer(rel(t.GetStart()), li, t)
            offer(rel(t.GetEnd()), li, t)
    cands.sort(key=lambda c: c[0])
    out, seen = [], set()
    for _d, pos, ls, item in cands:
        key = (round(pos[0], 2), round(pos[1], 2))
        if key in seen:
            continue
        seen.add(key)
        out.append((pos, ls, item))
        if len(out) >= k:
            break
    return out


def item_cluster(board, item):
    """Uuid set of the copper island `item` belongs to."""
    board.BuildConnectivity()
    conn = board.GetConnectivity()
    ids = {item.m_Uuid.AsString()}
    for o in list(conn.GetConnectedTracks(item)) \
            + list(conn.GetConnectedPads(item)):
        ids.add(o.m_Uuid.AsString())
    return ids


def finish_board(design, plane_layers):

    closed_total = 0
    ripped = {}                      # net -> times ripped up (rip_up)
    # a rip-up is a transaction: the board before it is kept, the next
    # round (which rips nothing) tries to re-route the ripped nets, and if
    # the open count did not drop the board goes back and that pair is
    # never ripped for again
    pending, no_rip = None, set()
    backup = PCB.with_suffix(".prerip.kicad_pcb")
    for _round in range(10):
        board = pcbnew.LoadBoard(str(PCB))
        rt = Router(board, design)
        idx = index_board(board)
        pairs = drc_unconnected()
        if not pairs and pending is None:
            break
        closed = 0
        ripped_now = False
        may_rip = pending is None
        for u in pairs:
            if ripped_now:
                break                # the board changed under the other pairs: next round
            items = [idx.get(i["uuid"]) for i in u["items"]]
            if all(i is None for i in items):
                continue
            if any(i is None for i in items):
                # one end is a ZONE (a pour piece the pad could not reach):
                # aim the pad at the net's nearest other copper instead
                k1, o1 = next(i for i in items if i is not None)
                netname = o1.GetNetname()
                nc = o1.GetNetCode()
                set_width(class_width(netname, design))
                set_via(netname)
                p1, l1 = endpoint(k1, o1, rel(o1.GetPosition()) if k1 != "track"
                                  else rel(o1.GetStart()))
                p2, l2 = retarget(board, nc, p1)
                if p2 is None:
                    continue
                k2, o2 = "pad", o1
            else:
                (k1, o1), (k2, o2) = items
                netname = o1.GetNetname()
                nc = o1.GetNetCode()
                set_width(class_width(netname, design))
                set_via(netname)
                p2_guess = rel(o2.GetPosition()) if k2 != "track" else \
                    rel(o2.GetStart())
                p1, l1 = endpoint(k1, o1, p2_guess)
                p2, l2 = endpoint(k2, o2, p1)
            # an endpoint stranded on a plane layer: delete the fragment
            # (it is a slot in somebody's plane) and aim at the net's
            # nearest reachable copper instead
            for kk, oo, pp, ll, which in ((k1, o1, p1, l1, 1),
                                          (k2, o2, p2, l2, 2)):
                if kk == "track" and not ll \
                        and oo.GetLayer() in plane_layers \
                        and not oo.IsLocked():
                    other = p2 if which == 1 else p1
                    # the stranded thing is a RUN of segments, and the
                    # pair comes back each round if only one is deleted:
                    # remove every unlocked same-net wire on that layer
                    ly = oo.GetLayer()
                    for tt in list(board.GetTracks()):
                        if (not isinstance(tt, pcbnew.PCB_VIA)
                                and tt.GetNetCode() == nc
                                and tt.GetLayer() == ly
                                and not tt.IsLocked()):
                            board.Delete(tt)
                    np_, nl_ = retarget(board, nc, other)
                    if which == 1:
                        p1, l1 = np_, nl_
                    else:
                        p2, l2 = np_, nl_
            if not l1 or not l2:
                print(f"  unusable endpoints: {netname}")
                continue
            path = grid = None
            for step in (STEP, STEP / 2):
                grid = grid_of(design, step)
                blocked, via_blocked = build_masks(board, design, nc, grid)
                starts, goals = [], []
                for ls, pos, out in ((l1, p1, starts), (l2, p2, goals)):
                    for li in ls:
                        c = free_anchor(pos, blocked[li], grid)
                        if c is not None:
                            out.append((c, li))
                if not starts or not goals:
                    print(f"  no free anchor at {step}: {netname} {p1}")
                    continue
                path = astar(starts, goals, blocked, via_blocked, grid)
                if path is not None:
                    break
                print(f"  no path at {step}: {netname} "
                      f"({p1[0]:.2f},{p1[1]:.2f}) -> "
                      f"({p2[0]:.2f},{p2[1]:.2f})")
            if path is None:
                # the chosen endpoints may be entombed; retry from the
                # net's other copper anchors near each end
                grid = grid_of(design, STEP)
                blocked, via_blocked = build_masks(board, design, nc, grid)
                # alternates must stay on their own end's island, or
                # the A* happily "closes" the pair with a zero-length
                # path from an anchor to itself
                cl1 = item_cluster(board, o1)
                cl2 = item_cluster(board, o2)
                a1s = [(p1, l1)] + [
                    (q, m) for q, m, _it in
                    anchors_near(board, nc, p1, within=cl1)]
                a2s = [(p2, l2)] + [
                    (q, m) for q, m, _it in
                    anchors_near(board, nc, p2, within=cl2)]
                print(f"    retrying {netname} with {len(a1s)}x{len(a2s)} "
                      f"anchor pairs (cluster of {len(cl1)})")
                tried = 0
                for q1, m1 in a1s:
                    for q2, m2 in a2s:
                        if ((q1, q2) == (p1, p2)) or tried >= 8:
                            continue
                        if math.hypot(q1[0] - q2[0], q1[1] - q2[1]) < 0.3:
                            continue
                        starts = [(c, li) for li in m1
                                  if (c := free_anchor(
                                      q1, blocked[li], grid)) is not None]
                        goals = [(c, li) for li in m2
                                 if (c := free_anchor(
                                     q2, blocked[li], grid)) is not None]
                        if not starts or not goals:
                            continue
                        tried += 1
                        path = astar(starts, goals, blocked,
                                     via_blocked, grid)
                        if path is not None:
                            print(f"  alternate anchors won: {netname} "
                                  f"({q1[0]:.2f},{q1[1]:.2f}) -> "
                                  f"({q2[0]:.2f},{q2[1]:.2f})")
                            p1, p2 = q1, q2
                            break
                    if path is not None:
                        break
            key = (netname, round(p1[0], 1), round(p1[1], 1), round(p2[0], 1), round(p2[1], 1))
            if path is None and may_rip and netname != "GND" and key not in no_rip \
                    and sum(ripped.values()) < 12:
                # rip up: clear the freerouted wires in the way (never a
                # locked one, never a net ripped twice already) and lay it
                grid = grid_of(design, STEP)
                hit = rip_up(board, design, nc, ((p1, l1), (p2, l2)), grid)
                nets = {t.GetNetname() for t in hit} if hit is not None else set()
                # only plain SIGNAL nets are ripped (never a clock, a fast
                # net, power or a switch node: the crystal went once), at
                # most two at a time, none for the third time
                if hit is not None and len(nets) <= 2 \
                        and all(net_class(n) == "SIGNAL" for n in nets) \
                        and not any(ripped.get(n, 0) >= 2 for n in nets):
                    pcbnew.SaveBoard(str(backup), board)
                    pending = (len(pairs) - closed, key)
                    rip(board, hit)
                    ripped_now = True
                    for n in nets:
                        ripped[n] = ripped.get(n, 0) + 1
                    blocked, via_blocked = build_masks(board, design, nc, grid)
                    starts = [(c, li) for li in l1 if (c := free_anchor(p1, blocked[li], grid)) is not None]
                    goals = [(c, li) for li in l2 if (c := free_anchor(p2, blocked[li], grid)) is not None]
                    if starts and goals:
                        path = astar(starts, goals, blocked, via_blocked, grid)
                    print(f"  ripped up {sorted(nets)} for {netname}: "
                          f"{'laid' if path is not None else 'still no path'}")
            if path is None:
                continue
            nv = draw(rt, path, netname, grid, p1, p2, blocked)
            print(f"  closed {netname}: ({p1[0]:.2f},{p1[1]:.2f}) -> "
                  f"({p2[0]:.2f},{p2[1]:.2f}), {nv} vias")
            closed += 1
        if closed or ripped_now:
            filler = pcbnew.ZONE_FILLER(board)
            filler.Fill(board.Zones())
            pcbnew.SaveBoard(str(PCB), board)
            closed_total += closed
        if pending is not None and not ripped_now:
            # the round after a rip-up: keep it only if it paid
            before, key = pending
            after = len(drc_unconnected())
            if after >= before:
                shutil.copy(backup, PCB)
                no_rip.add(key)
                print(f"  rip-up for {key[0]} undone: {after} open after it, {before} before")
            else:
                print(f"  rip-up for {key[0]} kept: {before} -> {after} open")
            pending = None
            continue
        if not closed and not ripped_now:
            break
    backup.unlink(missing_ok=True)
    board = pcbnew.LoadBoard(str(PCB))
    n = stitch_fragments(board, design)
    if n:
        print(f"    stitched {n} GND pour fragment(s)")
        pcbnew.ZONE_FILLER(board).Fill(board.Zones())
        pcbnew.SaveBoard(str(PCB), board)
        board = pcbnew.LoadBoard(str(PCB))
    board.BuildConnectivity()
    left = board.GetConnectivity().GetUnconnectedCount(True)
    print(f"    closed {closed_total}; {left} unconnected left")
    return left


def stitch_fragments(board, design):
    """A via into every GND pour fragment that has none. A fragment with
    only a GND pad in it stays connected to that pad and to nothing else,
    and DRC reports it as a zone-to-zone open; the stitching grid walks
    past the small ones."""
    from route import Obstacles, Router, mm
    obs = Obstacles(board)
    rt = Router(board, design)
    gnd = board.FindNet("GND").GetNetCode()
    r_via = design["jlcpcb"]["via_diameter_mm"] / 2
    ol_poly = pcbnew.SHAPE_POLY_SET()
    board.GetBoardPolygonOutlines(ol_poly)
    via_inner = pcbnew.SHAPE_POLY_SET(ol_poly)
    via_inner.Inflate(-mm(0.6), pcbnew.CORNER_STRATEGY_ROUND_ALL_CORNERS, mm(0.01))
    through = [rel(t.GetPosition()) for t in board.GetTracks()
               if t.Type() == pcbnew.PCB_VIA_T and t.GetNetCode() == gnd]
    through += [rel(p.GetPosition()) for fp in board.GetFootprints() for p in fp.Pads()
                if p.GetNetCode() == gnd and p.GetAttribute() == pcbnew.PAD_ATTRIB_PTH]
    no_via = [z for z in board.Zones() if z.GetIsRuleArea() and z.GetDoNotAllowVias()]

    def pt(x, y):
        return pcbnew.VECTOR2I(mm(CX + x), mm(CY + y))
    exact = None             # finish's exact via mask, built on first need
    added = 0
    for z in list(board.Zones()):
        if z.GetNetCode() != gnd or z.GetIsRuleArea():
            continue
        for ly in z.GetLayerSet().Seq():
            polys = z.GetFilledPolysList(ly)
            for i in range(polys.OutlineCount()):
                o = polys.Outline(i)
                if any(o.PointInside(pt(x, y)) for x, y in through):
                    continue
                bb = o.BBox()
                x0, y0 = to_mm(bb.GetLeft()) - CX, to_mm(bb.GetTop()) - CY
                x1, y1 = to_mm(bb.GetRight()) - CX, to_mm(bb.GetBottom()) - CY
                best = None
                for gap in (0.3, 0.2, 0.15):
                    y = y0
                    while y <= y1 and best is None:
                        x = x0
                        while x <= x1:
                            if (via_inner.Contains(pt(x, y))
                                    and o.PointInside(pt(x, y))
                                    and not any(k.Outline().Collide(pt(x, y), mm(r_via + 0.1)) for k in no_via)
                                    and obs.clear(x, y, r_via, gap)):
                                best = (x, y)
                                break
                            x += 0.1
                        y += 0.1
                    if best:
                        break
                if best is None:
                    # the circle model above is coarse (a track counts 0.15
                    # wider than it is); the exact rectangle/disk mask the
                    # grid router uses finds the legal spots it misses -- the
                    # IMU's two GND pins sat on an island boxed in by a 3V3
                    # loop with a legal via spot under the package
                    # (2026-10-18). Nearest legal cell to the island's middle.
                    if exact is None:
                        g = grid_of(design, STEP / 2)
                        exact = (g, build_masks(board, design, gnd, g)[1])
                    g, vb = exact
                    gx0, gy0, gnx, gny, gst = g
                    mx, my = (x0 + x1) / 2, (y0 + y1) / 2
                    cands = []
                    for i in range(max(0, int((x0 - gx0) / gst)), min(gnx, int((x1 - gx0) / gst) + 2)):
                        for j in range(max(0, int((y0 - gy0) / gst)), min(gny, int((y1 - gy0) / gst) + 2)):
                            x, y = gx0 + i * gst, gy0 + j * gst
                            if (i, j) not in vb and o.PointInside(pt(x, y)):
                                cands.append((math.hypot(x - mx, y - my), x, y))
                    if cands:
                        best = min(cands)[1:]
                if best is None:
                    print(f"    GND fragment on {board.GetLayerName(ly)} at "
                          f"({(x0 + x1) / 2:.1f},{(y0 + y1) / 2:.1f}) has no room for a via")
                    continue
                rt.via(best, "GND", locked=False)
                obs.items.append((best[0], best[1], r_via, gnd, None, "fragment stitch"))
                if exact is not None:
                    g, vb = exact
                    gx0, gy0, _, _, gst = g
                    ci, cj = round((best[0] - gx0) / gst), round((best[1] - gy0) / gst)
                    k = int(0.45 / gst) + 1        # hole-to-hole: keep later stitches off this one
                    vb.update((ci + a, cj + b) for a in range(-k, k + 1) for b in range(-k, k + 1))
                through.append(best)
                added += 1
    return added


def mitre(board, cut=0.3):
    """Cut every right-angle corner between two unlocked wires to two
    45-degree bends (the routers draw them; the pre-routes are mitred where
    they are laid). A corner qualifies when exactly two wires of one net,
    layer and width meet at a point with no pad or via on it; each is
    shortened by up to `cut` (never more than half its length) and a
    diagonal joins them, if that diagonal clears every other-net pad,
    track and via on its layer by the class clearance. Returns the corners
    cut and the corners left square."""
    tracks = [t for t in board.GetTracks() if t.Type() == pcbnew.PCB_TRACE_T]
    ends = {}
    for t in tracks:
        for e in (t.GetStart(), t.GetEnd()):
            ends.setdefault((e.x, e.y, t.GetLayer(), t.GetNetCode()), []).append(t)
    vias = [v for v in board.GetTracks() if v.Type() == pcbnew.PCB_VIA_T]
    pads = [pd for fp in board.GetFootprints() for pd in fp.Pads()]
    cut_n = left = 0
    for (x, y, ly, nc), ts in ends.items():
        if len(ts) != 2 or any(t.IsLocked() for t in ts) or ts[0].GetWidth() != ts[1].GetWidth():
            continue
        p = pcbnew.VECTOR2I(x, y)
        if any(v.GetPosition() == p for v in vias) or any(
                pd.GetNetCode() == nc and pd.HitTest(p) for pd in pads):
            continue
        legs = []
        for t in ts:
            far = t.GetEnd() if t.GetStart() == p else t.GetStart()
            legs.append((t, far))
        (t1, f1), (t2, f2) = legs
        d1 = (to_mm(f1.x - x), to_mm(f1.y - y))
        d2 = (to_mm(f2.x - x), to_mm(f2.y - y))
        l1, l2 = math.hypot(*d1), math.hypot(*d2)
        if l1 < 1e-3 or l2 < 1e-3 or abs(d1[0] * d2[0] + d1[1] * d2[1]) > 1e-3 * l1 * l2:
            continue                             # not a right angle
        hw = to_mm(t1.GetWidth()) / 2
        done = False
        for c in (cut, cut / 2):
            c = min(c, l1 / 2, l2 / 2)
            if c < 0.05:
                break
            a = (to_mm(x) + d1[0] / l1 * c, to_mm(y) + d1[1] / l1 * c)
            b = (to_mm(x) + d2[0] / l2 * c, to_mm(y) + d2[1] / l2 * c)
            if not diag_clear(board, a, b, hw, ly, nc, pads, tracks, vias):
                continue
            pa = pcbnew.VECTOR2I(pcbnew.FromMM(a[0]), pcbnew.FromMM(a[1]))
            pb = pcbnew.VECTOR2I(pcbnew.FromMM(b[0]), pcbnew.FromMM(b[1]))
            for t, q in ((t1, pa), (t2, pb)):
                if t.GetStart() == p:
                    t.SetStart(q)
                else:
                    t.SetEnd(q)
            d = pcbnew.PCB_TRACK(board)
            d.SetStart(pa)
            d.SetEnd(pb)
            d.SetLayer(ly)
            d.SetWidth(t1.GetWidth())
            d.SetNetCode(nc)
            board.Add(d)
            cut_n += 1
            done = True
            break
        left += not done
    return cut_n, left


def diag_clear(board, a, b, hw, ly, nc, pads, tracks, vias):
    """Does a wire a-b (board mm, half-width hw) on layer ly clear every
    other-net item there by the class clearance?"""
    from route import seg_dist
    gap = CLEAR + hw
    for pd in pads:
        if pd.GetNetCode() == nc or not pd.IsOnLayer(ly):
            continue
        bb = pd.GetBoundingBox()
        x0, y0, x1, y1 = to_mm(bb.GetLeft()), to_mm(bb.GetTop()), to_mm(bb.GetRight()), to_mm(bb.GetBottom())
        for k in range(11):
            px, py = a[0] + (b[0] - a[0]) * k / 10, a[1] + (b[1] - a[1]) * k / 10
            if math.hypot(max(x0 - px, 0, px - x1), max(y0 - py, 0, py - y1)) < gap:
                return False
    for v in vias:
        if v.GetNetCode() == nc:
            continue
        c = (to_mm(v.GetPosition().x), to_mm(v.GetPosition().y))
        if seg_dist(a, b, c, c) < gap + to_mm(v.GetWidth(pcbnew.F_Cu)) / 2:
            return False
    for t in tracks:
        if t.GetNetCode() == nc or t.GetLayer() != ly:
            continue
        s, e = t.GetStart(), t.GetEnd()
        if seg_dist(a, b, (to_mm(s.x), to_mm(s.y)), (to_mm(e.x), to_mm(e.y))) < gap + to_mm(t.GetWidth()) / 2:
            return False
    return True


def preroute(board, design, netname, a, b, layers=None, avoid=()):
    """Route one net from a to b -- each (position, [copper layers]) -- with
    the grid router, on the board in memory, before freerouting runs: the
    class's width, via and layers (route.py uses it for the VBUS trunk,
    which freerouting left open in most orderings once it was 0.6 mm with
    0.7/0.4 vias). `layers` narrows the class's layers further; `avoid`
    lists (layer, x0, y0, x1, y1) boxes it may not cross. What it draws is
    locked. Returns the vias used, or None."""
    global LAYERS
    from route import stackup
    st = stackup(design)
    pour = [] if st["pour"] in st["planes"] else [st["pour"]]
    LAYERS = [pcbnew.F_Cu] + st["signal"] + pour + [pcbnew.B_Cu]
    set_width(class_width(netname, design))
    set_via(netname)
    nc = board.FindNet(netname).GetNetCode()
    rt = Router(board, design)
    for step in (STEP, STEP / 2):
        grid = grid_of(design, step)
        blocked, via_blocked = build_masks(board, design, nc, grid)
        if layers is not None:
            every = {(i, j) for i in range(grid[2]) for j in range(grid[3])}
            for li, ly in enumerate(LAYERS):
                if ly not in layers:
                    blocked[li] |= every
        gx0, gy0, gnx, gny, gst = grid
        for ly, bx0, by0, bx1, by1 in avoid:
            li = LAYERS.index(ly)
            blocked[li] |= {(i, j) for i in range(max(0, int((bx0 - gx0) / gst)), min(gnx, int((bx1 - gx0) / gst) + 1))
                            for j in range(max(0, int((by0 - gy0) / gst)), min(gny, int((by1 - gy0) / gst) + 1))}
        ends = []
        for pos, lys in (a, b):
            ends.append([(c, LAYERS.index(ly)) for ly in lys if ly in LAYERS
                         and (c := free_anchor(pos, blocked[LAYERS.index(ly)], grid)) is not None])
        if not all(ends):
            continue
        path = astar(ends[0], ends[1], blocked, via_blocked, grid)
        if path is not None:
            return draw(rt, path, netname, grid, a[0], b[0], blocked)
    return None


def board_score():
    """(error violations, unconnected) for the board on disk."""
    unc = drc_unconnected()
    viol = []
    if REPORT.exists():
        viol = json.loads(REPORT.read_text()).get("violations", [])
    return len(viol), len(unc)


def main():
    """Close what close_gaps left, with the grid router. The planes (In1
    and In4 GND, In3 VSYS on six layers) never get a wire."""
    global LAYERS
    design = load_design()
    from route import stackup
    st = stackup(design)
    pour = [] if st["pour"] in st["planes"] else [st["pour"]]
    LAYERS = [pcbnew.F_Cu] + st["signal"] + pour + [pcbnew.B_Cu]
    left = finish_board(design, set(st["planes"]))
    board = pcbnew.LoadBoard(str(PCB))
    cut, square = mitre(board)
    pcbnew.ZONE_FILLER(board).Fill(board.Zones())
    pcbnew.SaveBoard(str(PCB), board)
    print(f"mitre: {cut} right-angle corners cut to 45 degrees, {square} left (no room)")
    viol, unc = board_score()
    print(f"finish: {unc} unconnected, {viol} DRC errors")
    REPORT.unlink(missing_ok=True)
    return 0


if __name__ == "__main__":
    sys.exit(main())
