sequoia-hope/bluebuzz/(commit log)

2026-10-19 bluebuzz: RP2350A + RM2 board, fully routed
    The RP2350A + Raspberry Pi Radio Module 2 board is the project; the
    abandoned nRF52840 board is kept in archive/nrf52840/. Routed with
    0 unconnected, 0 DRC errors and a clean audit (route ordering 11, with
    locked pin escapes for RP2350 pins 7, 8, 24 and 25-29).
2026-10-19 Route the USB pair as one coupled pair on B.Cu
    D+/D- now run 0.3 mm apart on centres (0.15 / 0.15, 90 ohm) on B.Cu over
    the In4 ground, from the USB-C join vias to the vias in R3/R4; before,
    freerouting split each line over F, In2 and In3. R11 and C10's GND pads,
    both in the top-left sensor's no-via box, share one locked via outside
    it (R11.2 was the open connection in 4 of 11 orderings).
    Re-routed: 0 unconnected, 0 DRC errors, audit clean (ROUTE_FIRST=5).
2026-10-19 Routing gate review: failed; add parity, current and plane checks
    design/gates/phase7.md records the gate. DRC is 0/0 and connectivity
    parity is clean, but every high-current layer change is a single via,
    the In3 VSYS pour is cut in two by signal wiring, and return vias and
    edge stitching are missing. It holds the evidence, the independent
    review's findings and the fix plan.
    New checks: scripts/check_parity.py (schematic vs board by pad sets),
    scripts/check_current.py (max-flow of each power path against the
    design currents), scripts/check_planes.py (plane pieces and voids,
    fast nets over their reference, return vias).
    The schematic now carries the board's BOM/DNP flags (circuit.DNP).
    Co-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
2026-10-19 Checks: rate pours by their fill, true In2 reference, stitching density
    check_current.py rasterises every pour fill (0.1 mm cells, 4-connected)
    into the max-flow, so a neck in a pour is a neck (the phase-7 review's
    M12: pours counted as unlimited hid the VSYS pour's 0.24-0.32 mm necks).
    scipy's Dinic replaces networkx so the whole-board pour solves in seconds.
    check_planes.py: In2 references the In3 VSYS plane (0.11 mm away, not
    In1 at 0.55); every plane is checked for pieces, voids and foreign wires;
    every signal via that moves the return In1<->In4 needs a GND via (1.0 mm
    fast, 1.5 mm slow), GND<->VSYS changes list the nearest VSYS cap; edge
    fence (3 mm pitch) and interior stitching (3 mm)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
2026-10-19 Generator: In3 a solid VSYS plane, power via arrays, stitching stage
    Phase-7 fix plan, generator side (design/gates/phase7.md, decisions.md):
    - In3 carries VSYS only: VSYS is a plane net like GND (out of the DSN,
    via-in-pad everywhere, never routed); WL_CLK to B.Cu, WL_CS to In2.
    - Power transfers as via arrays sized by check_current.py: the charger's
    OUT and BAT as F.Cu zones with 4 vias each, the MOT pads' arrays, the
    motor corners' VSYS zones, the RM2 VIN with C100 under it on the back.
    - Netclasses Motor (F.Cu only) and Vbus (0.65 mm, 0.7/0.4 vias), held in
    the DSN (use_layer) and by close_gaps / finish; finish places each
    class's own via. VBUS enters by one via beside C10; th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
2026-10-20 Generator: grid-route the nets freerouting stranded, fast-only reserved return vias
    VBUS receptacle links, TAC_CS2 and WL_IRQ routed first by finish.preroute;
    TAC_CS1 escape; WL_CLK clear of C91; locked GND for C91 and R61/C64;
    stitch / finish keep NPTH hole-to-copper. See decisions.md, part 3.
2026-10-20 Generator: grid-route TAC_CS1, C13's VBUS, the motor switch nodes and IMU_INT1 first
2026-10-20 finish: transactional rip-up for pairs with no path
    When the grid router finds no path, search again without other nets'
    unlocked wires, rip what is in the way (SIGNAL nets only, at most two),
    lay the path, and let the next round re-route the ripped nets; if the
    open count did not drop, the board before the rip comes back and that
    pair is not ripped for again.
2026-10-20 Board rerouted with the reworked generator (ordering 42): 0 unconnected, DRC errors 0
    - design.yaml routing: ordering 42 (0/0 of 48 orderings searched); a
    plain build routes that one ordering.
    - stitch.py: vias for plane-net pads DRC still reports open (J5's VSYS
    test pad), and a last sweep of the vias DRC calls dangling.
    - audit.py: the motor-path width rule skips wires inside a same-net pour.
    - Gate evidence regenerated in design/gates/phase7/.
2026-10-22 Squish 2mm offset outline, 4-sensor diamond, add MP34DT05 PDM mic, update placement and routing
2026-10-22 Complete routing on 2.0mm inward-offset squish outline (0 DRC errors, 0 unconnected, audit clean) and update exports/site
